MSolovtsov/BachelorThesis_Manipulator/Electronic/Altium/Курсовой проект по  электронике/Электроника/PCBbase.PcbDoc.htm

Reporting Options

# File in Newer Format

Date | : | 27.01.2025
Time | : | 15:22:56
Filename | : | C:\Users\mikha\Desktop\BMSTU\4_course\Дипломная работа\Электроника\Altium\Курсовой проект по электронике\Электроника\PCBbase.PcbDoc

Version | Warning
Release 23.6 | CAUTION - The PCB document contains Footprint parameters. These will be lost when opening the document in a version of Altium Designer that does not support this functionality.

This file was generated by a later version of the software
