MSolovtsov/BachelorThesis_Manipulator/Electronic/Altium/Курсовой проект по  электронике/Электроника/AD_GOST/Examples/MiniPC MB GOST/MiniPC MB GOST.PrjPcb And MiniPC MB GOST.XLS

Change Order Report For Project |  |  | MiniPC MB GOST.PrjPcb And MiniPC MB GOST.PrjPcb
Action | Object |  | Change Document | Status
Remove Pins From Nets
Remove | AB14-C357-1 from DDR4VCC_1 | In | MiniPC.PcbDoc
Remove | AB14-C357-2 from GND | In | MiniPC.PcbDoc
Remove | AB14-C358-1 from DDR4VCC_1 | In | MiniPC.PcbDoc
Remove | AB14-C358-2 from GND | In | MiniPC.PcbDoc
Remove | AB14-C359-1 from DDR4VCC_1 | In | MiniPC.PcbDoc
Remove | AB14-C359-2 from GND | In | MiniPC.PcbDoc
Remove | AB14-C360-1 from DDR4VCC_1 | In | MiniPC.PcbDoc
Remove | AB14-C360-2 from GND | In | MiniPC.PcbDoc
Remove | AB14-C361-1 from NetAB14-C361_1 | In | MiniPC.PcbDoc
Remove | AB14-C362-1 from DDR4VCC_1 | In | MiniPC.PcbDoc
Remove | AB14-C362-2 from GND | In | MiniPC.PcbDoc
Remove | AB15-C364-1 from DDR4VCC_1 | In | MiniPC.PcbDoc
Remove | AB15-C364-2 from GND | In | MiniPC.PcbDoc
Remove | AB15-C365-1 from DDR4VCC_1 | In | MiniPC.PcbDoc
Remove | AB15-C365-2 from GND | In | MiniPC.PcbDoc
Remove | AB15-C366-1 from DDR4VCC_1 | In | MiniPC.PcbDoc
Remove | AB15-C366-2 from GND | In | MiniPC.PcbDoc
Remove | AB15-C367-1 from DDR4VCC_1 | In | MiniPC.PcbDoc
Remove | AB15-C367-2 from GND | In | MiniPC.PcbDoc
Remove | AB15-C369-1 from DDR4VCC_1 | In | MiniPC.PcbDoc
Remove | AB15-C369-2 from GND | In | MiniPC.PcbDoc
Remove | AB21-C401-1 from GND | In | MiniPC.PcbDoc
Remove | AB21-C401-2 from IO_2V5_1 | In | MiniPC.PcbDoc
Remove | AB21-C402-1 from GND | In | MiniPC.PcbDoc
Remove | AB21-C402-2 from IO_3V3_1 | In | MiniPC.PcbDoc
Remove | AB21-C403-1 from GND | In | MiniPC.PcbDoc
Remove | AB21-C403-2 from 5V_1 | In | MiniPC.PcbDoc
Remove | AB21-C404-1 from GND | In | MiniPC.PcbDoc
Remove | AB21-C404-2 from IO_3V3_1 | In | MiniPC.PcbDoc
Remove | AB21-C409-1 from GND | In | MiniPC.PcbDoc
Remove | AB21-C409-2 from 3V3_AVDDH_31 | In | MiniPC.PcbDoc
Remove | AB21-C410-1 from GND | In | MiniPC.PcbDoc
Remove | AB21-C410-2 from 3V3_AVDDH_31 | In | MiniPC.PcbDoc
Remove | AB21-C411-1 from GND | In | MiniPC.PcbDoc
Remove | AB21-C411-2 from 3V3_AVDDH_31 | In | MiniPC.PcbDoc
Remove | AB21-C412-1 from GND | In | MiniPC.PcbDoc
Remove | AB21-C412-2 from 1V2_AVDLL_PLL_31 | In | MiniPC.PcbDoc
Remove | AB21-C413-1 from GND | In | MiniPC.PcbDoc
Remove | AB21-C413-2 from 1V2_AVDLL_PLL_31 | In | MiniPC.PcbDoc
Remove | AB21-C420-1 from GND | In | MiniPC.PcbDoc
Remove | AB21-C420-2 from 1V2_AVDLL_PLL_31 | In | MiniPC.PcbDoc
Remove | AB21-C421-1 from GND | In | MiniPC.PcbDoc
Remove | AB21-C421-2 from 1V2_AVDLL_PLL_31 | In | MiniPC.PcbDoc
Remove | AB21-C422-1 from GND | In | MiniPC.PcbDoc
Remove | AB21-C422-2 from 1V2_AVDLL_PLL_31 | In | MiniPC.PcbDoc
Remove | MH1-MH1 from GND | In | MiniPC.PcbDoc
Remove | MH2-MH1 from GND | In | MiniPC.PcbDoc
Remove | MH3-MH1 from GND | In | MiniPC.PcbDoc
Remove | MH4-MH1 from GND | In | MiniPC.PcbDoc
Remove Component Class Members
Remove | AB16-X1 from A1 | In | MiniPC.PcbDoc
Remove | AB19AC1-X4 from AB19 | In | MiniPC.PcbDoc
Remove | AB19AC1-X4 from AB20 | In | MiniPC.PcbDoc
Remove | AB19AC1-X4 from AC12 | In | MiniPC.PcbDoc
Remove | AB22-XS6 from A3 | In | MiniPC.PcbDoc
Remove | AC2-C540 from AB21 | In | MiniPC.PcbDoc
Remove | AC2-C541 from AB21 | In | MiniPC.PcbDoc
Remove | AC2-C542 from AB21 | In | MiniPC.PcbDoc
Remove | AC2-C543 from AB21 | In | MiniPC.PcbDoc
Remove | AC2-R314 from AB21 | In | MiniPC.PcbDoc
Remove | AC2-R315 from AB21 | In | MiniPC.PcbDoc
Remove | AC2-X5 from AB21 | In | MiniPC.PcbDoc
пятница 6-сен-06.2019 12:04:29 PM |  |  |  |  | Page 1 of 15
Action | Object |  | Change Document | Status
Change Component Parameters
Modify | 5 parameter change(s) (Current - Cathode, Noise - | In | MiniPC.PcbDoc
 | 0#1Hz to 10Hz, Operating Temperature,
 | Temperature Coefficient, Tolerance) In AB3-D7
пятница 6-сен-06.2019 12:04:29 PM |  |  |  |  | Page 2 of 15
Action | Object |  | Change Document | Status
Change Net Names
Modify | 0V9_SENSE+_41 -> 0V9_SENSE+ | In | MiniPC.PcbDoc
Modify | 0V9_SENSE-_41 -> 0V9_SENSE- | In | MiniPC.PcbDoc
Modify | 0V95_1 -> 0V95 | In | MiniPC.PcbDoc
Modify | 1V0_1 -> 1V0 | In | MiniPC.PcbDoc
Modify | 1V2_AVDDL_31 -> 1V2_AVDDL | In | MiniPC.PcbDoc
Modify | 1V2_AVDLL_PLL_31 -> 1V2_AVDLL_PLL | In | MiniPC.PcbDoc
Modify | 1V2_DVDDL_31 -> 1V2_DVDDL | In | MiniPC.PcbDoc
Modify | 1V8_DVDDH_31 -> 1V8_DVDDH | In | MiniPC.PcbDoc
Modify | 3V3_1 -> 3V3 | In | MiniPC.PcbDoc
Modify | 3V3_AVDDH_31 -> 3V3_AVDDH | In | MiniPC.PcbDoc
Modify | 3V3_SENSE+_36 -> 3V3_SENSE+ | In | MiniPC.PcbDoc
Modify | 3V3_SENSE-_36 -> 3V3_SENSE- | In | MiniPC.PcbDoc
Modify | 5V_1 -> IO_5V | In | MiniPC.PcbDoc
Modify | aux_12V_1 -> aux_12V | In | MiniPC.PcbDoc
Modify | CLK_DIFF1_8_N -> CLK_DIFF1_N | In | MiniPC.PcbDoc
Modify | CLK_DIFF1_8_P -> CLK_DIFF1_P | In | MiniPC.PcbDoc
Modify | CLK_DIFF2_8_N -> CLK_DIFF2_N | In | MiniPC.PcbDoc
Modify | CLK_DIFF2_8_P -> CLK_DIFF2_P | In | MiniPC.PcbDoc
Modify | CLOCK_I2C_SCL_8 -> CLOCK_I2C_SCL | In | MiniPC.PcbDoc
Modify | CLOCK_I2C_SDA_8 -> CLOCK_I2C_SDA | In | MiniPC.PcbDoc
Modify | COMP01_41 -> COMP01 | In | MiniPC.PcbDoc
Modify | COMP02_36 -> COMP02 | In | MiniPC.PcbDoc
Modify | Core_0V9_1 -> Core_0V9 | In | MiniPC.PcbDoc
Modify | DDR4_BLK1.CTRL.ACT_1 -> | In | MiniPC.PcbDoc
 | DDR4_BLK1.CTRL.ACT
Modify | DDR4_BLK1.CTRL.ALERT_1 -> | In | MiniPC.PcbDoc
 | DDR4_BLK1.CTRL.ALERT
Modify | DDR4_BLK1.CTRL.CK0_1_N -> | In | MiniPC.PcbDoc
 | DDR4_BLK1.CTRL.CK0_N
Modify | DDR4_BLK1.CTRL.CK0_1_P -> | In | MiniPC.PcbDoc
 | DDR4_BLK1.CTRL.CK0_P
Modify | DDR4_BLK1.CTRL.CK1_1_N -> | In | MiniPC.PcbDoc
 | DDR4_BLK1.CTRL.CK1_N
Modify | DDR4_BLK1.CTRL.CK1_1_P -> | In | MiniPC.PcbDoc
 | DDR4_BLK1.CTRL.CK1_P
Modify | DDR4_BLK1.CTRL.CKE_1 -> | In | MiniPC.PcbDoc
 | DDR4_BLK1.CTRL.CKE
Modify | DDR4_BLK1.CTRL.CS_1 -> | In | MiniPC.PcbDoc
 | DDR4_BLK1.CTRL.CS
Modify | DDR4_BLK1.CTRL.ODT_1 -> | In | MiniPC.PcbDoc
 | DDR4_BLK1.CTRL.ODT
Modify | DDR4_BLK1.CTRL.PARITY_1 -> | In | MiniPC.PcbDoc
 | DDR4_BLK1.CTRL.PARITY
Modify | DDR4_BLK1.CTRL.RESET_1 -> | In | MiniPC.PcbDoc
 | DDR4_BLK1.CTRL.RESET
Modify | DDR4_BLK1.CTRL.SCL_1 -> | In | MiniPC.PcbDoc
 | DDR4_BLK1.CTRL.SCL
Modify | DDR4_BLK1.CTRL.SDA_1 -> | In | MiniPC.PcbDoc
 | DDR4_BLK1.CTRL.SDA
Modify | DDR4_BLK1.DL1.DM0_1 -> | In | MiniPC.PcbDoc
 | DDR4_BLK1.DL1.DM0
Modify | DDR4_BLK1.DL1.DQ0_1 -> | In | MiniPC.PcbDoc
 | DDR4_BLK1.DL1.DQ0
Modify | DDR4_BLK1.DL1.DQ1_1 -> | In | MiniPC.PcbDoc
 | DDR4_BLK1.DL1.DQ1
Modify | DDR4_BLK1.DL1.DQ2_1 -> | In | MiniPC.PcbDoc
 | DDR4_BLK1.DL1.DQ2
Modify | DDR4_BLK1.DL1.DQ3_1 -> | In | MiniPC.PcbDoc
 | DDR4_BLK1.DL1.DQ3
Modify | DDR4_BLK1.DL1.DQ4_1 -> | In | MiniPC.PcbDoc
 | DDR4_BLK1.DL1.DQ4
Modify | DDR4_BLK1.DL1.DQ5_1 -> | In | MiniPC.PcbDoc
 | DDR4_BLK1.DL1.DQ5
Modify | DDR4_BLK1.DL1.DQ6_1 -> | In | MiniPC.PcbDoc
 | DDR4_BLK1.DL1.DQ6
Modify | DDR4_BLK1.DL1.DQ7_1 -> | In | MiniPC.PcbDoc
 | DDR4_BLK1.DL1.DQ7
Modify | DDR4_BLK1.DL1.DQS0_1_N -> | In | MiniPC.PcbDoc
 | DDR4_BLK1.DL1.DQS0_N
Modify | DDR4_BLK1.DL1.DQS0_1_P -> | In | MiniPC.PcbDoc
пятница 6-сен-06.2019 12:04:29 PM |  |  |  |  | Page 3 of 15
Action | Object |  | Change Document | Status
Change Net Names
 | DDR4_BLK1.DL1.DQS0_P
Modify | DDR4_BLK1.DL2.DM1_1 -> | In | MiniPC.PcbDoc
 | DDR4_BLK1.DL2.DM1
Modify | DDR4_BLK1.DL2.DQ8_1 -> | In | MiniPC.PcbDoc
 | DDR4_BLK1.DL2.DQ8
Modify | DDR4_BLK1.DL2.DQ9_1 -> | In | MiniPC.PcbDoc
 | DDR4_BLK1.DL2.DQ9
Modify | DDR4_BLK1.DL2.DQ10_1 -> | In | MiniPC.PcbDoc
 | DDR4_BLK1.DL2.DQ10
Modify | DDR4_BLK1.DL2.DQ11_1 -> | In | MiniPC.PcbDoc
 | DDR4_BLK1.DL2.DQ11
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
 | DDR4_BLK1.DL7.DQ50
Modify | DDR4_BLK1.DL7.DQ51_1 -> | In | MiniPC.PcbDoc
 | DDR4_BLK1.DL7.DQ51
Modify | DDR4_BLK1.DL7.DQ52_1 -> | In | MiniPC.PcbDoc
 | DDR4_BLK1.DL7.DQ52
Modify | DDR4_BLK1.DL7.DQ53_1 -> | In | MiniPC.PcbDoc
 | DDR4_BLK1.DL7.DQ53
Modify | DDR4_BLK1.DL7.DQ54_1 -> | In | MiniPC.PcbDoc
 | DDR4_BLK1.DL7.DQ54
Modify | DDR4_BLK1.DL7.DQ55_1 -> | In | MiniPC.PcbDoc
 | DDR4_BLK1.DL7.DQ55
Modify | DDR4_BLK1.DL7.DQS6_1_N -> | In | MiniPC.PcbDoc
 | DDR4_BLK1.DL7.DQS6_N
Modify | DDR4_BLK1.DL7.DQS6_1_P -> | In | MiniPC.PcbDoc
 | DDR4_BLK1.DL7.DQS6_P
Modify | DDR4_BLK1.DL8.DM7_1 -> | In | MiniPC.PcbDoc
 | DDR4_BLK1.DL8.DM7
Modify | DDR4_BLK1.DL8.DQ56_1 -> | In | MiniPC.PcbDoc
 | DDR4_BLK1.DL8.DQ56
Modify | DDR4_BLK1.DL8.DQ57_1 -> | In | MiniPC.PcbDoc
 | DDR4_BLK1.DL8.DQ57
Modify | DDR4_BLK1.DL8.DQ58_1 -> | In | MiniPC.PcbDoc
пятница 6-сен-06.2019 12:04:29 PM |  |  |  |  | Page 5 of 15
Action | Object |  | Change Document | Status
Change Net Names
 | DDR4_BLK1.DL8.DQ58
Modify | DDR4_BLK1.DL8.DQ59_1 -> | In | MiniPC.PcbDoc
 | DDR4_BLK1.DL8.DQ59
Modify | DDR4_BLK1.DL8.DQ60_1 -> | In | MiniPC.PcbDoc
 | DDR4_BLK1.DL8.DQ60
Modify | DDR4_BLK1.DL8.DQ61_1 -> | In | MiniPC.PcbDoc
 | DDR4_BLK1.DL8.DQ61
Modify | DDR4_BLK1.DL8.DQ62_1 -> | In | MiniPC.PcbDoc
 | DDR4_BLK1.DL8.DQ62
Modify | DDR4_BLK1.DL8.DQ63_1 -> | In | MiniPC.PcbDoc
 | DDR4_BLK1.DL8.DQ63
Modify | DDR4_BLK1.DL8.DQS7_1_N -> | In | MiniPC.PcbDoc
 | DDR4_BLK1.DL8.DQS7_N
Modify | DDR4_BLK1.DL8.DQS7_1_P -> | In | MiniPC.PcbDoc
 | DDR4_BLK1.DL8.DQS7_P
Modify | DDR4_BLK2.CTRL.CK0_1_N -> | In | MiniPC.PcbDoc
 | DDR4_BLK2.CTRL.CK0_N
Modify | DDR4_BLK2.CTRL.CK0_1_P -> | In | MiniPC.PcbDoc
 | DDR4_BLK2.CTRL.CK0_P
Modify | DDR4_BLK2.CTRL.CK1_1_N -> | In | MiniPC.PcbDoc
 | DDR4_BLK2.CTRL.CK1_N
Modify | DDR4_BLK2.CTRL.CK1_1_P -> | In | MiniPC.PcbDoc
 | DDR4_BLK2.CTRL.CK1_P
Modify | DDR4_BLK2.CTRL.CKE_1 -> | In | MiniPC.PcbDoc
 | DDR4_BLK2.CTRL.CKE
Modify | DDR4_BLK2.CTRL.CS_1 -> | In | MiniPC.PcbDoc
 | DDR4_BLK2.CTRL.CS
Modify | DDR4_BLK2.CTRL.ODT_1 -> | In | MiniPC.PcbDoc
 | DDR4_BLK2.CTRL.ODT
Modify | DDR4_INT.CTRL.ACT_1 -> | In | MiniPC.PcbDoc
 | DDR4_INT.CTRL.ACT
Modify | DDR4_INT.CTRL.ALERT0_1 -> | In | MiniPC.PcbDoc
 | DDR4_INT.CTRL.ALERT0
Modify | DDR4_INT.CTRL.ALERT1_1 -> | In | MiniPC.PcbDoc
 | DDR4_INT.CTRL.ALERT1
Modify | DDR4_INT.CTRL.CAS_1 -> | In | MiniPC.PcbDoc
 | DDR4_INT.CTRL.CAS
Modify | DDR4_INT.CTRL.CKE_1 -> | In | MiniPC.PcbDoc
 | DDR4_INT.CTRL.CKE
Modify | DDR4_INT.CTRL.CLK_1_N -> | In | MiniPC.PcbDoc
 | DDR4_INT.CTRL.CLK_N
Modify | DDR4_INT.CTRL.CLK_1_P -> | In | MiniPC.PcbDoc
 | DDR4_INT.CTRL.CLK_P
Modify | DDR4_INT.CTRL.CSn_1 -> | In | MiniPC.PcbDoc
 | DDR4_INT.CTRL.CSn
Modify | DDR4_INT.CTRL.ODT_1 -> | In | MiniPC.PcbDoc
 | DDR4_INT.CTRL.ODT
Modify | DDR4_INT.CTRL.PAR_1 -> | In | MiniPC.PcbDoc
 | DDR4_INT.CTRL.PAR
Modify | DDR4_INT.CTRL.RAS_1 -> | In | MiniPC.PcbDoc
 | DDR4_INT.CTRL.RAS
Modify | DDR4_INT.CTRL.RESETn_1 -> | In | MiniPC.PcbDoc
 | DDR4_INT.CTRL.RESETn
Modify | DDR4_INT.CTRL.WEn_1 -> | In | MiniPC.PcbDoc
 | DDR4_INT.CTRL.WEn
Modify | DDR4_INT.DL1.DM0_1 -> DDR4_INT.DL1.DM0 | In | MiniPC.PcbDoc
Modify | DDR4_INT.DL1.DQ0_1 -> DDR4_INT.DL1.DQ0 | In | MiniPC.PcbDoc
Modify | DDR4_INT.DL1.DQ1_1 -> DDR4_INT.DL1.DQ1 | In | MiniPC.PcbDoc
Modify | DDR4_INT.DL1.DQ2_1 -> DDR4_INT.DL1.DQ2 | In | MiniPC.PcbDoc
Modify | DDR4_INT.DL1.DQ3_1 -> DDR4_INT.DL1.DQ3 | In | MiniPC.PcbDoc
Modify | DDR4_INT.DL1.DQ4_1 -> DDR4_INT.DL1.DQ4 | In | MiniPC.PcbDoc
Modify | DDR4_INT.DL1.DQ5_1 -> DDR4_INT.DL1.DQ5 | In | MiniPC.PcbDoc
Modify | DDR4_INT.DL1.DQ6_1 -> DDR4_INT.DL1.DQ6 | In | MiniPC.PcbDoc
Modify | DDR4_INT.DL1.DQ7_1 -> DDR4_INT.DL1.DQ7 | In | MiniPC.PcbDoc
Modify | DDR4_INT.DL1.DQS0_1_N -> | In | MiniPC.PcbDoc
 | DDR4_INT.DL1.DQS0_N
Modify | DDR4_INT.DL1.DQS0_1_P -> | In | MiniPC.PcbDoc
 | DDR4_INT.DL1.DQS0_P
Modify | DDR4_INT.DL2.DM1_1 -> DDR4_INT.DL2.DM1 | In | MiniPC.PcbDoc
Modify | DDR4_INT.DL2.DQ8_1 -> DDR4_INT.DL2.DQ8 | In | MiniPC.PcbDoc
пятница 6-сен-06.2019 12:04:29 PM |  |  |  |  | Page 6 of 15
Action | Object |  | Change Document | Status
Change Net Names
Modify | DDR4_INT.DL2.DQ9_1 -> DDR4_INT.DL2.DQ9 | In | MiniPC.PcbDoc
Modify | DDR4_INT.DL2.DQ10_1 -> DDR4_INT.DL2.DQ10 | In | MiniPC.PcbDoc
Modify | DDR4_INT.DL2.DQ11_1 -> DDR4_INT.DL2.DQ11 | In | MiniPC.PcbDoc
Modify | DDR4_INT.DL2.DQ12_1 -> DDR4_INT.DL2.DQ12 | In | MiniPC.PcbDoc
Modify | DDR4_INT.DL2.DQ13_1 -> DDR4_INT.DL2.DQ13 | In | MiniPC.PcbDoc
Modify | DDR4_INT.DL2.DQ14_1 -> DDR4_INT.DL2.DQ14 | In | MiniPC.PcbDoc
Modify | DDR4_INT.DL2.DQ15_1 -> DDR4_INT.DL2.DQ15 | In | MiniPC.PcbDoc
Modify | DDR4_INT.DL2.DQS1_1_N -> | In | MiniPC.PcbDoc
 | DDR4_INT.DL2.DQS1_N
Modify | DDR4_INT.DL2.DQS1_1_P -> | In | MiniPC.PcbDoc
 | DDR4_INT.DL2.DQS1_P
Modify | DDR4_INT.DL3.DM2_1 -> DDR4_INT.DL3.DM2 | In | MiniPC.PcbDoc
Modify | DDR4_INT.DL3.DQ16_1 -> DDR4_INT.DL3.DQ16 | In | MiniPC.PcbDoc
Modify | DDR4_INT.DL3.DQ17_1 -> DDR4_INT.DL3.DQ17 | In | MiniPC.PcbDoc
Modify | DDR4_INT.DL3.DQ18_1 -> DDR4_INT.DL3.DQ18 | In | MiniPC.PcbDoc
Modify | DDR4_INT.DL3.DQ19_1 -> DDR4_INT.DL3.DQ19 | In | MiniPC.PcbDoc
Modify | DDR4_INT.DL3.DQ20_1 -> DDR4_INT.DL3.DQ20 | In | MiniPC.PcbDoc
Modify | DDR4_INT.DL3.DQ21_1 -> DDR4_INT.DL3.DQ21 | In | MiniPC.PcbDoc
Modify | DDR4_INT.DL3.DQ22_1 -> DDR4_INT.DL3.DQ22 | In | MiniPC.PcbDoc
Modify | DDR4_INT.DL3.DQ23_1 -> DDR4_INT.DL3.DQ23 | In | MiniPC.PcbDoc
Modify | DDR4_INT.DL3.DQS2_1_N -> | In | MiniPC.PcbDoc
 | DDR4_INT.DL3.DQS2_N
Modify | DDR4_INT.DL3.DQS2_1_P -> | In | MiniPC.PcbDoc
 | DDR4_INT.DL3.DQS2_P
Modify | DDR4_INT.DL4.DM3_1 -> DDR4_INT.DL4.DM3 | In | MiniPC.PcbDoc
Modify | DDR4_INT.DL4.DQ24_1 -> DDR4_INT.DL4.DQ24 | In | MiniPC.PcbDoc
Modify | DDR4_INT.DL4.DQ25_1 -> DDR4_INT.DL4.DQ25 | In | MiniPC.PcbDoc
Modify | DDR4_INT.DL4.DQ26_1 -> DDR4_INT.DL4.DQ26 | In | MiniPC.PcbDoc
Modify | DDR4_INT.DL4.DQ27_1 -> DDR4_INT.DL4.DQ27 | In | MiniPC.PcbDoc
Modify | DDR4_INT.DL4.DQ28_1 -> DDR4_INT.DL4.DQ28 | In | MiniPC.PcbDoc
Modify | DDR4_INT.DL4.DQ29_1 -> DDR4_INT.DL4.DQ29 | In | MiniPC.PcbDoc
Modify | DDR4_INT.DL4.DQ30_1 -> DDR4_INT.DL4.DQ30 | In | MiniPC.PcbDoc
Modify | DDR4_INT.DL4.DQ31_1 -> DDR4_INT.DL4.DQ31 | In | MiniPC.PcbDoc
Modify | DDR4_INT.DL4.DQS3_1_N -> | In | MiniPC.PcbDoc
 | DDR4_INT.DL4.DQS3_N
Modify | DDR4_INT.DL4.DQS3_1_P -> | In | MiniPC.PcbDoc
 | DDR4_INT.DL4.DQS3_P
Modify | DDR4VCC_1 -> DDR4VCC | In | MiniPC.PcbDoc
Modify | DP_3V3_2 -> DP_3V3 | In | MiniPC.PcbDoc
Modify | DP_ML_LANE0_C_2_N -> DP_ML_LANE0_C_N | In | MiniPC.PcbDoc
Modify | DP_ML_LANE0_C_2_P -> DP_ML_LANE0_C_P | In | MiniPC.PcbDoc
Modify | DP_ML_LANE1_C_2_N -> DP_ML_LANE1_C_N | In | MiniPC.PcbDoc
Modify | DP_ML_LANE1_C_2_P -> DP_ML_LANE1_C_P | In | MiniPC.PcbDoc
Modify | DP_ML_LANE2_C_2_N -> DP_ML_LANE2_C_N | In | MiniPC.PcbDoc
Modify | DP_ML_LANE2_C_2_P -> DP_ML_LANE2_C_P | In | MiniPC.PcbDoc
Modify | DP_ML_LANE3_C_2_N -> DP_ML_LANE3_C_N | In | MiniPC.PcbDoc
Modify | DP_ML_LANE3_C_2_P -> DP_ML_LANE3_C_P | In | MiniPC.PcbDoc
Modify | ENET_REFCLK_C_8_N -> ENET_REFCLK_C_N | In | MiniPC.PcbDoc
Modify | ENET_REFCLK_C_8_P -> ENET_REFCLK_C_P | In | MiniPC.PcbDoc
Modify | GND_DP_2 -> GND_DP | In | MiniPC.PcbDoc
Modify | GND_SENSE_1 -> GND_SENSE | In | MiniPC.PcbDoc
Modify | HPS_0V95_1 -> HPS_0V95 | In | MiniPC.PcbDoc
Modify | IO_1V8_1 -> IO_1V8 | In | MiniPC.PcbDoc
Modify | IO_2V5_1 -> IO_2V5 | In | MiniPC.PcbDoc
Modify | IO_3V3_1 -> IO_3V3 | In | MiniPC.PcbDoc
Modify | NetAB14-C361_1 -> NetAB14-R86_2 | In | MiniPC.PcbDoc
Modify | PCIE.CLK_SYN._1_N -> PCIE.CLK_SYN._N | In | MiniPC.PcbDoc
Modify | PCIE.CLK_SYN._1_P -> PCIE.CLK_SYN._P | In | MiniPC.PcbDoc
Modify | PCIE.DL.RX0._1_N -> PCIE.DL.RX0._N | In | MiniPC.PcbDoc
Modify | PCIE.DL.RX0._1_P -> PCIE.DL.RX0._P | In | MiniPC.PcbDoc
Modify | PCIE.DL.RX1._1_N -> PCIE.DL.RX1._N | In | MiniPC.PcbDoc
Modify | PCIE.DL.RX1._1_P -> PCIE.DL.RX1._P | In | MiniPC.PcbDoc
Modify | PCIE.DL.RX2._1_N -> PCIE.DL.RX2._N | In | MiniPC.PcbDoc
Modify | PCIE.DL.RX2._1_P -> PCIE.DL.RX2._P | In | MiniPC.PcbDoc
Modify | PCIE.DL.RX3._1_N -> PCIE.DL.RX3._N | In | MiniPC.PcbDoc
Modify | PCIE.DL.RX3._1_P -> PCIE.DL.RX3._P | In | MiniPC.PcbDoc
Modify | PCIE.DL.RX4._1_N -> PCIE.DL.RX4._N | In | MiniPC.PcbDoc
Modify | PCIE.DL.RX4._1_P -> PCIE.DL.RX4._P | In | MiniPC.PcbDoc
Modify | PCIE.DL.RX5._1_N -> PCIE.DL.RX5._N | In | MiniPC.PcbDoc
пятница 6-сен-06.2019 12:04:29 PM |  |  |  |  | Page 7 of 15
Action | Object |  | Change Document | Status
Change Net Names
Modify | PCIE.DL.RX5._1_P -> PCIE.DL.RX5._P | In | MiniPC.PcbDoc
Modify | PCIE.DL.RX6._1_N -> PCIE.DL.RX6._N | In | MiniPC.PcbDoc
Modify | PCIE.DL.RX6._1_P -> PCIE.DL.RX6._P | In | MiniPC.PcbDoc
Modify | PCIE.DL.RX7._1_N -> PCIE.DL.RX7._N | In | MiniPC.PcbDoc
Modify | PCIE.DL.RX7._1_P -> PCIE.DL.RX7._P | In | MiniPC.PcbDoc
Modify | PCIE.DL.TX0._1_N -> PCIE.DL.TX0._N | In | MiniPC.PcbDoc
Modify | PCIE.DL.TX0._1_P -> PCIE.DL.TX0._P | In | MiniPC.PcbDoc
Modify | PCIE.DL.TX1._1_N -> PCIE.DL.TX1._N | In | MiniPC.PcbDoc
Modify | PCIE.DL.TX1._1_P -> PCIE.DL.TX1._P | In | MiniPC.PcbDoc
Modify | PCIE.DL.TX2._1_N -> PCIE.DL.TX2._N | In | MiniPC.PcbDoc
Modify | PCIE.DL.TX2._1_P -> PCIE.DL.TX2._P | In | MiniPC.PcbDoc
Modify | PCIE.DL.TX3._1_N -> PCIE.DL.TX3._N | In | MiniPC.PcbDoc
Modify | PCIE.DL.TX3._1_P -> PCIE.DL.TX3._P | In | MiniPC.PcbDoc
Modify | PCIE.DL.TX4._1_N -> PCIE.DL.TX4._N | In | MiniPC.PcbDoc
Modify | PCIE.DL.TX4._1_P -> PCIE.DL.TX4._P | In | MiniPC.PcbDoc
Modify | PCIE.DL.TX5._1_N -> PCIE.DL.TX5._N | In | MiniPC.PcbDoc
Modify | PCIE.DL.TX5._1_P -> PCIE.DL.TX5._P | In | MiniPC.PcbDoc
Modify | PCIE.DL.TX6._1_N -> PCIE.DL.TX6._N | In | MiniPC.PcbDoc
Modify | PCIE.DL.TX6._1_P -> PCIE.DL.TX6._P | In | MiniPC.PcbDoc
Modify | PCIE.DL.TX7._1_N -> PCIE.DL.TX7._N | In | MiniPC.PcbDoc
Modify | PCIE.DL.TX7._1_P -> PCIE.DL.TX7._P | In | MiniPC.PcbDoc
Modify | PCIE.PERSTn_1 -> PCIE.PERSTn | In | MiniPC.PcbDoc
Modify | PCIE_aux3V3_1 -> PCIE_aux3V3 | In | MiniPC.PcbDoc
Modify | PCIE_DC_3V3_1 -> PCIE_DC_3V3 | In | MiniPC.PcbDoc
Modify | PCIE_TX0_C_12_N -> PCIE_TX0_C_N | In | MiniPC.PcbDoc
Modify | PCIE_TX0_C_12_P -> PCIE_TX0_C_P | In | MiniPC.PcbDoc
Modify | PCIE_TX1_C_12_N -> PCIE_TX1_C_N | In | MiniPC.PcbDoc
Modify | PCIE_TX1_C_12_P -> PCIE_TX1_C_P | In | MiniPC.PcbDoc
Modify | PCIE_TX2_C_12_N -> PCIE_TX2_C_N | In | MiniPC.PcbDoc
Modify | PCIE_TX2_C_12_P -> PCIE_TX2_C_P | In | MiniPC.PcbDoc
Modify | PCIE_TX3_C_12_N -> PCIE_TX3_C_N | In | MiniPC.PcbDoc
Modify | PCIE_TX3_C_12_P -> PCIE_TX3_C_P | In | MiniPC.PcbDoc
Modify | PCIE_TX4_C_12_N -> PCIE_TX4_C_N | In | MiniPC.PcbDoc
Modify | PCIE_TX4_C_12_P -> PCIE_TX4_C_P | In | MiniPC.PcbDoc
Modify | PCIE_TX5_C_12_N -> PCIE_TX5_C_N | In | MiniPC.PcbDoc
Modify | PCIE_TX5_C_12_P -> PCIE_TX5_C_P | In | MiniPC.PcbDoc
Modify | PCIE_TX6_C_12_N -> PCIE_TX6_C_N | In | MiniPC.PcbDoc
Modify | PCIE_TX6_C_12_P -> PCIE_TX6_C_P | In | MiniPC.PcbDoc
Modify | PCIE_TX7_C_12_N -> PCIE_TX7_C_N | In | MiniPC.PcbDoc
Modify | PCIE_TX7_C_12_P -> PCIE_TX7_C_P | In | MiniPC.PcbDoc
Modify | PLL_1V8_1 -> PLL_1V8 | In | MiniPC.PcbDoc
Modify | PRESENT_12 -> PRESENT | In | MiniPC.PcbDoc
Modify | REFCLK0_FMCB_C_8_N -> | In | MiniPC.PcbDoc
 | REFCLK0_FMCB_C_N
Modify | REFCLK0_FMCB_C_8_P -> | In | MiniPC.PcbDoc
 | REFCLK0_FMCB_C_P
Modify | REFCLK1_FMCB_C_8_N -> | In | MiniPC.PcbDoc
 | REFCLK1_FMCB_C_N
Modify | REFCLK1_FMCB_C_8_P -> | In | MiniPC.PcbDoc
 | REFCLK1_FMCB_C_P
Modify | REFCLK_DP_C_8_N -> REFCLK_DP_C_N | In | MiniPC.PcbDoc
Modify | REFCLK_DP_C_8_P -> REFCLK_DP_C_P | In | MiniPC.PcbDoc
Modify | REFCLK_SDI_C_8_N -> REFCLK_SDI_C_N | In | MiniPC.PcbDoc
Modify | REFCLK_SDI_C_8_P -> REFCLK_SDI_C_P | In | MiniPC.PcbDoc
Modify | SENSESYNC1_41 -> SENSESYNC1 | In | MiniPC.PcbDoc
Modify | SENSESYNC2_36 -> SENSESYNC2 | In | MiniPC.PcbDoc
Modify | SHARE_CLK1_41 -> SHARE_CLK1 | In | MiniPC.PcbDoc
Modify | SHARE_CLK2_36 -> SHARE_CLK2 | In | MiniPC.PcbDoc
Modify | TRCT1_47 -> TRCT1 | In | MiniPC.PcbDoc
Modify | TRCT2_47 -> TRCT2 | In | MiniPC.PcbDoc
Modify | TRCT3_47 -> TRCT3 | In | MiniPC.PcbDoc
Modify | TRCT4_47 -> TRCT4 | In | MiniPC.PcbDoc
Modify | TRD1_31_N -> TRD1_N | In | MiniPC.PcbDoc
Modify | TRD1_31_P -> TRD1_P | In | MiniPC.PcbDoc
Modify | TRD2_31_N -> TRD2_N | In | MiniPC.PcbDoc
Modify | TRD2_31_P -> TRD2_P | In | MiniPC.PcbDoc
Modify | TRD3_31_N -> TRD3_N | In | MiniPC.PcbDoc
Modify | TRD3_31_P -> TRD3_P | In | MiniPC.PcbDoc
Modify | TRD4_31_N -> TRD4_N | In | MiniPC.PcbDoc
пятница 6-сен-06.2019 12:04:29 PM |  |  |  |  | Page 8 of 15
Action | Object |  | Change Document | Status
Change Net Names
Modify | TRD4_31_P -> TRD4_P | In | MiniPC.PcbDoc
Modify | USB3_port.DATA._4_N -> USB3_port.DATA._N | In | MiniPC.PcbDoc
Modify | USB3_port.DATA._4_P -> USB3_port.DATA._P | In | MiniPC.PcbDoc
Modify | USB3_port.GND_4 -> USB3_port.GND | In | MiniPC.PcbDoc
Modify | USB3_port.SSRX._4_N -> USB3_port.SSRX._N | In | MiniPC.PcbDoc
Modify | USB3_port.SSRX._4_P -> USB3_port.SSRX._P | In | MiniPC.PcbDoc
Modify | USB3_port.SSTX._4_N -> USB3_port.SSTX._N | In | MiniPC.PcbDoc
Modify | USB3_port.SSTX._4_P -> USB3_port.SSTX._P | In | MiniPC.PcbDoc
Modify | USB3_port.VBUS_4 -> USB3_port.VBUS | In | MiniPC.PcbDoc
Modify | USB3_TOD_4_N -> USB3_TOD_N | In | MiniPC.PcbDoc
Modify | USB3_TOD_4_P -> USB3_TOD_P | In | MiniPC.PcbDoc
Modify | VADJ_1 -> VADJ | In | MiniPC.PcbDoc
Modify | VCC_SENSE_1 -> VCC_SENSE | In | MiniPC.PcbDoc
Modify | VDD33_1_41 -> VDD33_1 | In | MiniPC.PcbDoc
Modify | VDD33_2_36 -> VDD33_2 | In | MiniPC.PcbDoc
Modify | Vref_DDR4_25 -> Vref_DDR4 | In | MiniPC.PcbDoc
Change Net Colors
Modify | [0V95_1] RGB(59, 178, 83) -> Default | In | MiniPC.PcbDoc
Modify | [1V0_1] RGB(59, 178, 83) -> Default | In | MiniPC.PcbDoc
Modify | [3V3_1] RGB(245, 154, 76) -> Default | In | MiniPC.PcbDoc
Modify | [3V3_OUTPUT] RGB(245, 154, 76) -> Default | In | MiniPC.PcbDoc
Modify | [12V_INPUT] RGB(208, 52, 158) -> Default | In | MiniPC.PcbDoc
Modify | [12V_OUTPUT] RGB(208, 52, 158) -> Default | In | MiniPC.PcbDoc
Modify | [aux_12V_1] RGB(208, 52, 158) -> Default | In | MiniPC.PcbDoc
Modify | [Core_0V9_1] RGB(59, 178, 83) -> Default | In | MiniPC.PcbDoc
Modify | [DDR4VCC_1] RGB(59, 178, 83) -> Default | In | MiniPC.PcbDoc
Modify | [GND] RGB(114, 214, 193) -> Default | In | MiniPC.PcbDoc
Modify | [HPS_0V95_1] RGB(59, 178, 83) -> Default | In | MiniPC.PcbDoc
Modify | [IO_1V8_1] RGB(235, 165, 194) -> Default | In | MiniPC.PcbDoc
Modify | [IO_3V3_1] RGB(245, 154, 76) -> Default | In | MiniPC.PcbDoc
Modify | [NetAB23-D15_D6] RGB(245, 154, 76) -> Default | In | MiniPC.PcbDoc
Modify | [NetAB23-D15_E6] RGB(245, 154, 76) -> Default | In | MiniPC.PcbDoc
Modify | [NetAB24-C437_2] RGB(235, 165, 194) -> Default | In | MiniPC.PcbDoc
Modify | [NetAB24-VT1_5] RGB(235, 165, 194) -> Default | In | MiniPC.PcbDoc
Modify | [NetAB31-R256_2] RGB(255, 110, 110) -> Default | In | MiniPC.PcbDoc
Modify | [NetAB33-R277_2] RGB(245, 154, 76) -> Default | In | MiniPC.PcbDoc
Modify | [PCIE_aux3V3_1] RGB(245, 154, 76) -> Default | In | MiniPC.PcbDoc
Modify | [PCIE_DC_3V3_1] RGB(245, 154, 76) -> Default | In | MiniPC.PcbDoc
Modify | [PLL_1V8_1] RGB(235, 165, 194) -> Default | In | MiniPC.PcbDoc
Modify | [VADJ_1] RGB(59, 178, 83) -> Default | In | MiniPC.PcbDoc
Remove Net Classes
Remove | CLK_DIFF_PCIE | From | MiniPC.PcbDoc
Remove | DDR4_40 | From | MiniPC.PcbDoc
Remove | DDR4_ADDR/C/C | From | MiniPC.PcbDoc
Remove | DDR4_BYTELINE0 | From | MiniPC.PcbDoc
Remove | DDR4_BYTELINE1 | From | MiniPC.PcbDoc
Remove | DDR4_BYTELINE2 | From | MiniPC.PcbDoc
Remove | DDR4_BYTELINE3 | From | MiniPC.PcbDoc
Remove | DDR4_SODIMM_ADDR/C/C | From | MiniPC.PcbDoc
Remove | DDR4_SODIMM_BYTELINE0 | From | MiniPC.PcbDoc
Remove | DDR4_SODIMM_BYTELINE1 | From | MiniPC.PcbDoc
Remove | DDR4_SODIMM_BYTELINE2 | From | MiniPC.PcbDoc
Remove | DDR4_SODIMM_BYTELINE3 | From | MiniPC.PcbDoc
Remove | DDR4_SODIMM_BYTELINE4 | From | MiniPC.PcbDoc
Remove | DDR4_SODIMM_BYTELINE5 | From | MiniPC.PcbDoc
Remove | DDR4_SODIMM_BYTELINE6 | From | MiniPC.PcbDoc
Remove | DDR4_SODIMM_BYTELINE7 | From | MiniPC.PcbDoc
Remove | ENET_HPS | From | MiniPC.PcbDoc
Remove | PCIE_CLK | From | MiniPC.PcbDoc
Remove | PCIE_RX | From | MiniPC.PcbDoc
Remove | PCIE_TX_C | From | MiniPC.PcbDoc
Remove | PCIE_TX | From | MiniPC.PcbDoc
Remove | PCIE_Upr | From | MiniPC.PcbDoc
Remove | SFP | From | MiniPC.PcbDoc
Remove | USB3_diff | From | MiniPC.PcbDoc
пятница 6-сен-06.2019 12:04:29 PM |  |  |  |  | Page 9 of 15
Action | Object |  | Change Document | Status
Remove Channel Classes
Remove | Channel Class [Интерфейс Ethernet] | From | MiniPC.PcbDoc
Remove | Channel Class [Соединитель Ethernet] | From | MiniPC.PcbDoc
Remove | Channel Class [Соединитель SFP] | From | MiniPC.PcbDoc
пятница 6-сен-06.2019 12:04:29 PM |  |  |  |  | Page 10 of 15
Action | Object |  | Change Document | Status
Change Differential Pair Positive Net Name
Modify | CLK_DIFF1_8_P -> CLK_DIFF1_P | In | MiniPC.PcbDoc
Modify | CLK_DIFF2_8_P -> CLK_DIFF2_P | In | MiniPC.PcbDoc
Modify | DDR4_BLK1.CTRL.CK0_1_P -> | In | MiniPC.PcbDoc
 | DDR4_BLK1.CTRL.CK0_P
Modify | DDR4_BLK1.CTRL.CK1_1_P -> | In | MiniPC.PcbDoc
 | DDR4_BLK1.CTRL.CK1_P
Modify | DDR4_BLK1.DL1.DQS0_1_P -> | In | MiniPC.PcbDoc
 | DDR4_BLK1.DL1.DQS0_P
Modify | DDR4_BLK1.DL2.DQS1_1_P -> | In | MiniPC.PcbDoc
 | DDR4_BLK1.DL2.DQS1_P
Modify | DDR4_BLK1.DL3.DQS2_1_P -> | In | MiniPC.PcbDoc
 | DDR4_BLK1.DL3.DQS2_P
Modify | DDR4_BLK1.DL4.DQS3_1_P -> | In | MiniPC.PcbDoc
 | DDR4_BLK1.DL4.DQS3_P
Modify | DDR4_BLK1.DL5.DQS4_1_P -> | In | MiniPC.PcbDoc
 | DDR4_BLK1.DL5.DQS4_P
Modify | DDR4_BLK1.DL6.DQS5_1_P -> | In | MiniPC.PcbDoc
 | DDR4_BLK1.DL6.DQS5_P
Modify | DDR4_BLK1.DL7.DQS6_1_P -> | In | MiniPC.PcbDoc
 | DDR4_BLK1.DL7.DQS6_P
Modify | DDR4_BLK1.DL8.DQS7_1_P -> | In | MiniPC.PcbDoc
 | DDR4_BLK1.DL8.DQS7_P
Modify | DDR4_BLK2.CTRL.CK0_1_P -> | In | MiniPC.PcbDoc
 | DDR4_BLK2.CTRL.CK0_P
Modify | DDR4_BLK2.CTRL.CK1_1_P -> | In | MiniPC.PcbDoc
 | DDR4_BLK2.CTRL.CK1_P
Modify | DDR4_INT.CTRL.CLK_1_P -> | In | MiniPC.PcbDoc
 | DDR4_INT.CTRL.CLK_P
Modify | DDR4_INT.DL1.DQS0_1_P -> | In | MiniPC.PcbDoc
 | DDR4_INT.DL1.DQS0_P
Modify | DDR4_INT.DL2.DQS1_1_P -> | In | MiniPC.PcbDoc
 | DDR4_INT.DL2.DQS1_P
Modify | DDR4_INT.DL3.DQS2_1_P -> | In | MiniPC.PcbDoc
 | DDR4_INT.DL3.DQS2_P
Modify | DDR4_INT.DL4.DQS3_1_P -> | In | MiniPC.PcbDoc
 | DDR4_INT.DL4.DQS3_P
Modify | DP_ML_LANE0_C_2_P -> DP_ML_LANE0_C_P | In | MiniPC.PcbDoc
Modify | DP_ML_LANE1_C_2_P -> DP_ML_LANE1_C_P | In | MiniPC.PcbDoc
Modify | DP_ML_LANE2_C_2_P -> DP_ML_LANE2_C_P | In | MiniPC.PcbDoc
Modify | DP_ML_LANE3_C_2_P -> DP_ML_LANE3_C_P | In | MiniPC.PcbDoc
Modify | ENET_REFCLK_C_8_P -> ENET_REFCLK_C_P | In | MiniPC.PcbDoc
Modify | PCIE.CLK_SYN._1_P -> PCIE.CLK_SYN._P | In | MiniPC.PcbDoc
Modify | PCIE.DL.RX0._1_P -> PCIE.DL.RX2._P | In | MiniPC.PcbDoc
Modify | PCIE.DL.RX1._1_P -> PCIE.DL.RX1._P | In | MiniPC.PcbDoc
Modify | PCIE.DL.RX2._1_P -> PCIE.DL.RX0._P | In | MiniPC.PcbDoc
Modify | PCIE.DL.RX3._1_P -> PCIE.DL.RX3._P | In | MiniPC.PcbDoc
Modify | PCIE.DL.RX4._1_P -> PCIE.DL.RX4._P | In | MiniPC.PcbDoc
Modify | PCIE.DL.RX5._1_P -> PCIE.DL.RX5._P | In | MiniPC.PcbDoc
Modify | PCIE.DL.RX6._1_P -> PCIE.DL.RX6._P | In | MiniPC.PcbDoc
Modify | PCIE.DL.RX7._1_P -> PCIE.DL.RX7._P | In | MiniPC.PcbDoc
Modify | PCIE.DL.TX0._1_P -> PCIE.DL.TX0._P | In | MiniPC.PcbDoc
Modify | PCIE.DL.TX1._1_P -> PCIE.DL.TX1._P | In | MiniPC.PcbDoc
Modify | PCIE.DL.TX2._1_P -> PCIE.DL.TX2._P | In | MiniPC.PcbDoc
Modify | PCIE.DL.TX3._1_P -> PCIE.DL.TX3._P | In | MiniPC.PcbDoc
Modify | PCIE.DL.TX4._1_P -> PCIE.DL.TX4._P | In | MiniPC.PcbDoc
Modify | PCIE.DL.TX5._1_P -> PCIE.DL.TX5._P | In | MiniPC.PcbDoc
Modify | PCIE.DL.TX6._1_P -> PCIE.DL.TX6._P | In | MiniPC.PcbDoc
Modify | PCIE.DL.TX7._1_P -> PCIE.DL.TX7._P | In | MiniPC.PcbDoc
Modify | PCIE_TX0_C_12_P -> PCIE_TX0_C_P | In | MiniPC.PcbDoc
Modify | PCIE_TX1_C_12_P -> PCIE_TX1_C_P | In | MiniPC.PcbDoc
Modify | PCIE_TX2_C_12_P -> PCIE_TX2_C_P | In | MiniPC.PcbDoc
Modify | PCIE_TX3_C_12_P -> PCIE_TX3_C_P | In | MiniPC.PcbDoc
Modify | PCIE_TX4_C_12_P -> PCIE_TX4_C_P | In | MiniPC.PcbDoc
Modify | PCIE_TX5_C_12_P -> PCIE_TX5_C_P | In | MiniPC.PcbDoc
Modify | PCIE_TX6_C_12_P -> PCIE_TX6_C_P | In | MiniPC.PcbDoc
Modify | PCIE_TX7_C_12_P -> PCIE_TX7_C_P | In | MiniPC.PcbDoc
Modify | REFCLK0_FMCB_C_8_P -> | In | MiniPC.PcbDoc
 | REFCLK0_FMCB_C_P
Modify | REFCLK1_FMCB_C_8_P -> | In | MiniPC.PcbDoc
 | REFCLK1_FMCB_C_P
пятница 6-сен-06.2019 12:04:29 PM |  |  |  |  | Page 11 of 15
Action | Object |  | Change Document | Status
Change Differential Pair Positive Net Name
Modify | REFCLK_DP_C_8_P -> REFCLK_DP_C_P | In | MiniPC.PcbDoc
Modify | REFCLK_SDI_C_8_P -> REFCLK_SDI_C_P | In | MiniPC.PcbDoc
Modify | TRD1_31_P -> TRD1_P | In | MiniPC.PcbDoc
Modify | TRD2_31_P -> TRD2_P | In | MiniPC.PcbDoc
Modify | TRD3_31_P -> TRD3_P | In | MiniPC.PcbDoc
Modify | TRD4_31_P -> TRD4_P | In | MiniPC.PcbDoc
Modify | USB3_port.DATA._4_P -> USB3_port.DATA._P | In | MiniPC.PcbDoc
Modify | USB3_port.SSRX._4_P -> USB3_port.SSRX._P | In | MiniPC.PcbDoc
Modify | USB3_port.SSTX._4_P -> USB3_port.SSTX._P | In | MiniPC.PcbDoc
Modify | USB3_TOD_4_P -> USB3_TOD_P | In | MiniPC.PcbDoc
пятница 6-сен-06.2019 12:04:29 PM |  |  |  |  | Page 12 of 15
Action | Object |  | Change Document | Status
Change Differential Pair Negative Net Name
Modify | CLK_DIFF1_8_N -> CLK_DIFF1_N | In | MiniPC.PcbDoc
Modify | CLK_DIFF2_8_N -> CLK_DIFF2_N | In | MiniPC.PcbDoc
Modify | DDR4_BLK1.CTRL.CK0_1_N -> | In | MiniPC.PcbDoc
 | DDR4_BLK1.CTRL.CK0_N
Modify | DDR4_BLK1.CTRL.CK1_1_N -> | In | MiniPC.PcbDoc
 | DDR4_BLK1.CTRL.CK1_N
Modify | DDR4_BLK1.DL1.DQS0_1_N -> | In | MiniPC.PcbDoc
 | DDR4_BLK1.DL1.DQS0_N
Modify | DDR4_BLK1.DL2.DQS1_1_N -> | In | MiniPC.PcbDoc
 | DDR4_BLK1.DL2.DQS1_N
Modify | DDR4_BLK1.DL3.DQS2_1_N -> | In | MiniPC.PcbDoc
 | DDR4_BLK1.DL3.DQS2_N
Modify | DDR4_BLK1.DL4.DQS3_1_N -> | In | MiniPC.PcbDoc
 | DDR4_BLK1.DL4.DQS3_N
Modify | DDR4_BLK1.DL5.DQS4_1_N -> | In | MiniPC.PcbDoc
 | DDR4_BLK1.DL5.DQS4_N
Modify | DDR4_BLK1.DL6.DQS5_1_N -> | In | MiniPC.PcbDoc
 | DDR4_BLK1.DL6.DQS5_N
Modify | DDR4_BLK1.DL7.DQS6_1_N -> | In | MiniPC.PcbDoc
 | DDR4_BLK1.DL7.DQS6_N
Modify | DDR4_BLK1.DL8.DQS7_1_N -> | In | MiniPC.PcbDoc
 | DDR4_BLK1.DL8.DQS7_N
Modify | DDR4_BLK2.CTRL.CK0_1_N -> | In | MiniPC.PcbDoc
 | DDR4_BLK2.CTRL.CK0_N
Modify | DDR4_BLK2.CTRL.CK1_1_N -> | In | MiniPC.PcbDoc
 | DDR4_BLK2.CTRL.CK1_N
Modify | DDR4_INT.CTRL.CLK_1_N -> | In | MiniPC.PcbDoc
 | DDR4_INT.CTRL.CLK_N
Modify | DDR4_INT.DL1.DQS0_1_N -> | In | MiniPC.PcbDoc
 | DDR4_INT.DL1.DQS0_N
Modify | DDR4_INT.DL2.DQS1_1_N -> | In | MiniPC.PcbDoc
 | DDR4_INT.DL2.DQS1_N
Modify | DDR4_INT.DL3.DQS2_1_N -> | In | MiniPC.PcbDoc
 | DDR4_INT.DL3.DQS2_N
Modify | DDR4_INT.DL4.DQS3_1_N -> | In | MiniPC.PcbDoc
 | DDR4_INT.DL4.DQS3_N
Modify | DP_ML_LANE0_C_2_N -> DP_ML_LANE0_C_N | In | MiniPC.PcbDoc
Modify | DP_ML_LANE1_C_2_N -> DP_ML_LANE1_C_N | In | MiniPC.PcbDoc
Modify | DP_ML_LANE2_C_2_N -> DP_ML_LANE2_C_N | In | MiniPC.PcbDoc
Modify | DP_ML_LANE3_C_2_N -> DP_ML_LANE3_C_N | In | MiniPC.PcbDoc
Modify | ENET_REFCLK_C_8_N -> ENET_REFCLK_C_N | In | MiniPC.PcbDoc
Modify | PCIE.CLK_SYN._1_N -> PCIE.CLK_SYN._N | In | MiniPC.PcbDoc
Modify | PCIE.DL.RX0._1_N -> PCIE.DL.RX2._N | In | MiniPC.PcbDoc
Modify | PCIE.DL.RX1._1_N -> PCIE.DL.RX1._N | In | MiniPC.PcbDoc
Modify | PCIE.DL.RX2._1_N -> PCIE.DL.RX0._N | In | MiniPC.PcbDoc
Modify | PCIE.DL.RX3._1_N -> PCIE.DL.RX3._N | In | MiniPC.PcbDoc
Modify | PCIE.DL.RX4._1_N -> PCIE.DL.RX4._N | In | MiniPC.PcbDoc
Modify | PCIE.DL.RX5._1_N -> PCIE.DL.RX5._N | In | MiniPC.PcbDoc
Modify | PCIE.DL.RX6._1_N -> PCIE.DL.RX6._N | In | MiniPC.PcbDoc
Modify | PCIE.DL.RX7._1_N -> PCIE.DL.RX7._N | In | MiniPC.PcbDoc
Modify | PCIE.DL.TX0._1_N -> PCIE.DL.TX0._N | In | MiniPC.PcbDoc
Modify | PCIE.DL.TX1._1_N -> PCIE.DL.TX1._N | In | MiniPC.PcbDoc
Modify | PCIE.DL.TX2._1_N -> PCIE.DL.TX2._N | In | MiniPC.PcbDoc
Modify | PCIE.DL.TX3._1_N -> PCIE.DL.TX3._N | In | MiniPC.PcbDoc
Modify | PCIE.DL.TX4._1_N -> PCIE.DL.TX4._N | In | MiniPC.PcbDoc
Modify | PCIE.DL.TX5._1_N -> PCIE.DL.TX5._N | In | MiniPC.PcbDoc
Modify | PCIE.DL.TX6._1_N -> PCIE.DL.TX6._N | In | MiniPC.PcbDoc
Modify | PCIE.DL.TX7._1_N -> PCIE.DL.TX7._N | In | MiniPC.PcbDoc
Modify | PCIE_TX0_C_12_N -> PCIE_TX0_C_N | In | MiniPC.PcbDoc
Modify | PCIE_TX1_C_12_N -> PCIE_TX1_C_N | In | MiniPC.PcbDoc
Modify | PCIE_TX2_C_12_N -> PCIE_TX2_C_N | In | MiniPC.PcbDoc
Modify | PCIE_TX3_C_12_N -> PCIE_TX3_C_N | In | MiniPC.PcbDoc
Modify | PCIE_TX4_C_12_N -> PCIE_TX4_C_N | In | MiniPC.PcbDoc
Modify | PCIE_TX5_C_12_N -> PCIE_TX5_C_N | In | MiniPC.PcbDoc
Modify | PCIE_TX6_C_12_N -> PCIE_TX6_C_N | In | MiniPC.PcbDoc
Modify | PCIE_TX7_C_12_N -> PCIE_TX7_C_N | In | MiniPC.PcbDoc
Modify | REFCLK0_FMCB_C_8_N -> | In | MiniPC.PcbDoc
 | REFCLK0_FMCB_C_N
Modify | REFCLK1_FMCB_C_8_N -> | In | MiniPC.PcbDoc
 | REFCLK1_FMCB_C_N
пятница 6-сен-06.2019 12:04:29 PM |  |  |  |  | Page 13 of 15
Action | Object |  | Change Document | Status
Change Differential Pair Negative Net Name
Modify | REFCLK_DP_C_8_N -> REFCLK_DP_C_N | In | MiniPC.PcbDoc
Modify | REFCLK_SDI_C_8_N -> REFCLK_SDI_C_N | In | MiniPC.PcbDoc
Modify | TRD1_31_N -> TRD1_N | In | MiniPC.PcbDoc
Modify | TRD2_31_N -> TRD2_N | In | MiniPC.PcbDoc
Modify | TRD3_31_N -> TRD3_N | In | MiniPC.PcbDoc
Modify | TRD4_31_N -> TRD4_N | In | MiniPC.PcbDoc
Modify | USB3_port.DATA._4_N -> USB3_port.DATA._N | In | MiniPC.PcbDoc
Modify | USB3_port.SSRX._4_N -> USB3_port.SSRX._N | In | MiniPC.PcbDoc
Modify | USB3_port.SSTX._4_N -> USB3_port.SSTX._N | In | MiniPC.PcbDoc
Modify | USB3_TOD_4_N -> USB3_TOD_N | In | MiniPC.PcbDoc
Add Component Classes
Add | Board Template Connector | To | MiniPC.PcbDoc
Remove Rooms
Remove | Room Sheet_16_DDR4 | From | MiniPC.PcbDoc
 | (Scope=InComponentClass('Sheet_16_DDR4'))
 | BottomLayer
Remove | Room Sheet_23_12V_to_5V(Scope=InComponent | From | MiniPC.PcbDoc
 | Class('Sheet_23_12V_to_5V')) BottomLayer
Remove | Room Sheet_24_12V_to_3V3(Scope=InCompone | From | MiniPC.PcbDoc
 | ntClass('Sheet_24_12V_to_3V3')) BottomLayer
Remove | Room Sheet_25_3V3_to_2V5(Scope=InCompone | From | MiniPC.PcbDoc
 | ntClass('Sheet_25_3V3_to_2V5')) BottomLayer
Remove | Room Sheet_26_3V3_to_1V8(Scope=InCompone | From | MiniPC.PcbDoc
 | ntClass('Sheet_26_3V3_to_1V8')) BottomLayer
Remove | Room Sheet_27_12V_3V3_1V8_Swiches(Scope=I | From | MiniPC.PcbDoc
 | nComponentClass('Sheet_27_12V_3V3_1V8_Swi
 | ches')) BottomLayer
Remove | Room Sheet_28_12V_to_0V9(Scope=InCompone | From | MiniPC.PcbDoc
 | ntClass('Sheet_28_12V_to_0V9')) BottomLayer
Remove | Room Sheet_29_3V3_to_0V9(Scope=InCompone | From | MiniPC.PcbDoc
 | ntClass('Sheet_29_3V3_to_0V9')) BottomLayer
Remove | Room Sheet_30_3.3V_to_0.9V(Scope=InCompon | From | MiniPC.PcbDoc
 | entClass('Sheet_30_3.3V_to_0.9V')) BottomLayer
Remove | Room Sheet_31_3.3V_to_1.0V(Scope=InCompon | From | MiniPC.PcbDoc
 | entClass('Sheet_31_3.3V_to_1.0V')) BottomLayer
Remove | Room Sheet_33_3.3V_to_DDR4_VDD(Scope=InC | From | MiniPC.PcbDoc
 | omponentClass('Sheet_33_3.3V_to_DDR4_VDD'))
 | BottomLayer
пятница 6-сен-06.2019 12:04:29 PM |  |  |  |  | Page 14 of 15
Action | Object |  | Change Document | Status
Add Rooms
Add | Room A1 (Scope=InComponentClass('A1')) | To | MiniPC.PcbDoc
 | TopLayer
Add | Room A3 (Scope=InComponentClass('A3')) | To | MiniPC.PcbDoc
 | TopLayer
Add | Room A4 (Scope=InComponentClass('A4')) | To | MiniPC.PcbDoc
 | TopLayer
Add | Room A8 (Scope=InComponentClass('A8')) | To | MiniPC.PcbDoc
 | TopLayer
Add | Room A9 (Scope=InComponentClass('A9')) | To | MiniPC.PcbDoc
 | TopLayer
Add | Room A11 (Scope=InComponentClass('A11')) | To | MiniPC.PcbDoc
 | TopLayer
Add | Room AB2 (Scope=InComponentClass('AB2')) | To | MiniPC.PcbDoc
 | TopLayer
Add | Room AB3 (Scope=InComponentClass('AB3')) | To | MiniPC.PcbDoc
 | TopLayer
Add | Room AB4 (Scope=InComponentClass('AB4')) | To | MiniPC.PcbDoc
 | TopLayer
Add | Room AB7 (Scope=InComponentClass('AB7')) | To | MiniPC.PcbDoc
 | TopLayer
Add | Room AB9 (Scope=InComponentClass('AB9')) | To | MiniPC.PcbDoc
 | TopLayer
Add | Room AB13 (Scope=InComponentClass('AB13')) | To | MiniPC.PcbDoc
 | TopLayer
Add | Room AB14 (Scope=InComponentClass('AB14')) | To | MiniPC.PcbDoc
 | TopLayer
Add | Room AB15 (Scope=InComponentClass('AB15')) | To | MiniPC.PcbDoc
 | TopLayer
Add | Room AB16 (Scope=InComponentClass('AB16')) | To | MiniPC.PcbDoc
 | TopLayer
Add | Room AB17 (Scope=InComponentClass('AB17')) | To | MiniPC.PcbDoc
 | TopLayer
Add | Room AB18 (Scope=InComponentClass('AB18')) | To | MiniPC.PcbDoc
 | TopLayer
Add | Room AB25 (Scope=InComponentClass('AB25')) | To | MiniPC.PcbDoc
 | TopLayer
Add | Room Board Template Connector | To | MiniPC.PcbDoc
 | (Scope=InComponentClass('Board Template
 | Connector')) TopLayer
Remove Differential Pair Classes
Remove | 100 | From | MiniPC.PcbDoc
Remove | DDR4_80 | From | MiniPC.PcbDoc
Remove | DDR4_SODIMM_CK0 | From | MiniPC.PcbDoc
Remove | DDR4_SODIMM_CK1 | From | MiniPC.PcbDoc
Remove | DDR4_SODIMM_CK2 | From | MiniPC.PcbDoc
Remove | DDR4_SODIMM_CK3 | From | MiniPC.PcbDoc
Remove | DDR_CKL | From | MiniPC.PcbDoc
Remove | New Class | From | MiniPC.PcbDoc
Remove | PCIE_85 | From | MiniPC.PcbDoc
Remove | SFPA_RX | From | MiniPC.PcbDoc
Remove | SFPA_TX | From | MiniPC.PcbDoc
Remove | SFPB_RX | From | MiniPC.PcbDoc
Remove | SFPB_TX | From | MiniPC.PcbDoc
Remove | USB3_85 | From | MiniPC.PcbDoc
пятница 6-сен-06.2019 12:04:29 PM |  |  |  |  | Page 15 of 15
