MSolovtsov/BachelorThesis_Manipulator/ВКРБ_Соловцов.docx

# Введение

Современные автоматизированные и робототехнические системы играют ключевую роль в широком спектре промышленных и научных задач, включая автоматизацию производственных процессов, выполнение операций в труднодоступных или опасных для человека условиях, а также обучение и исследование в области мехатроники и управления. Одним из важнейших элементов манипулятора является захватное устройство, обеспечивающее взаимодействие с объектами окружающей среды.

Разработка привода захватного устройства представляет собой актуальную инженерную задачу, требующую комплексного подхода, включающего как механическое, так и электрическое проектирование, синтез систем автоматического управления и программную реализацию. Особенно важной является реализация привода для учебных стендов, которые используются в образовательных учреждениях для подготовки специалистов в области робототехники. Такие установки должны быть не только функциональными и надёжными, но и достаточно простыми для анализа, моделирования и модернизации.

Целью данной работы является разработка привода трёхпальцевого захватного устройства, предназначенного для учебного стенда манипулятора. В процессе выполнения работы рассматриваются все ключевые этапы: от постановки технического задания и конструкторских расчётов до проектирования электронных компонентов системы управления и разработки программного обеспечения.

Практическая значимость заключается в создании законченного решения, которое может быть использовано в качестве учебного и исследовательского стенда.

# Техническое задание для привода схвата

Наименование проекта: Разработка трехпалого схвата для лабораторного стенда-манипулятора

Исполнитель: Соловцов М.А.

Дата: 29.10.2024

Цель разработки

Создание трехпалого схвата для учебного манипулятора, предназначенного для проведения лабораторных работ по автоматизации, робототехнике и мехатронике. Схват должен быть безопасен, прост в управлении, и позволять студентам практиковаться в разработке управления манипуляторами и изучении принципов захвата и перемещения объектов.

Область применения

Схват предназначен для использования в учебных лабораториях в составе манипуляторного стенда и должен позволять безопасно захватывать и перемещать легкие учебные объекты различной формы и размера.

Требования к конструкции

- Количество зажимов: 3.
- Материал пальцев: пластик, возможны мягкие накладки (резина или силикон).
- Механизм привода пальцев: двигатель постоянного тока с червячной передачей.

Требования к приводу и мощности двигателя

- Тип двигателя: постоянного тока.
- Мощность двигателя: до 5 Вт.
- Напряжение питания: от источника постоянного тока 5-12 В.
- Управление: по положению.

Основные функциональные требования

- Статическая ошибка по угловому положению не должна превышать 10%.
- Скорость раскрытия/закрытия пальцев: 5 рад/с.
- Время реакции: не более 3 секунды.

Требования к системе управления

- Тип управления: простое цифровое управление (через микроконтроллер семейства STM32).
- Обратная связь: датчики положения (например, потенциометры).

# 1. Разработка и синтез привода захватного устройства

Анализируя различные типы захватов и их механизмы, мы пришли к выводу, что наше захватное устройство должно быть трехпалым механическим, оснащенным плоскопараллельным кинематическим механизмом. Такая конструкция обеспечивает универсальность, позволяя эффективно работать с объектами различной формы и размеров. Плоскопараллельный механизм гарантирует стабильное удержание деталей за счет равномерного распределения усилия на пальцы, что особенно важно при манипуляциях с хрупкими или нестабильными заготовками. Это решение оптимально для наших целей, так как оно сочетает простоту конструкции с надежностью и широкими функциональными возможностями.

На рис. 1 представлена планируемая структурная схема схвата манипулятора. Она иллюстрирует основные компоненты и их взаимосвязи, позволяя понять, как задумана работа схвата. В ней показаны различные элементы, такие как элементы силовой части, датчики и система управления в целом, которые совместно обеспечивают функциональность привода. Структурная схема помогает визуализировать принципы работы схвата и служит основой для дальнейшего проектирования и оптимизации его работы.

Рис. 1. Структурная схема привода захватного устройства.

КУ – корректирующее устройство изменяет сигнал ошибки так, чтобы привести привод к нужным характеристикам.

УМ – усилитель мощности используется для управления потоком энергии от источника. Мощность на выходе значительно больше, чем мощность входного сигнала. Примеры: силовые транзисторы, электромагнитные устройства, гидравлика, тиристоры, магнитные и пневматические элементы.

ИД – исполнительный двигатель преобразует поданный на него сигнал в механическое движение, чтобы выполнить заданное действие в системе. Он служит для управления различными механизмами, перемещая или приводя в движение объект управления.

МП – механическая передача передаёт движение и силу от двигателя к объекту регулирования. Она состоит из набора деталей, таких как шестерни, ремни, цепи, валы и шкивы. Эти компоненты работают вместе, чтобы изменить скорость, направление или силу движения.

ОР – объектом регулирования в данной системе является захватное устройство и груз.

ДП – датчик положения

ОС по положению – обратная связь по положению позволяет добиться от привода отработки входного воздействия.

## 1.1. Конструкторская часть

В данной части работы предстоит разработать конструкцию захвата для учебного манипулятора. Рассмотрим основные требования к конструкции:

- Возможность изготовления деталей захвата с помощью 3D-принтера, что предполагает простую форму и сравнительно крупные размеры компонентов.
- Обеспечение легкой и удобной сборки конструкции.
- Использование стандартных и доступных покупных элементов, которые должны быть недорогими.
- Необходимость обеспечения параллельного движения пальцев захвата для эффективного удержания объектов.

### 1.1.1. Расчет механической передачи

Одним из самых простых и популярных решений для создания трёхпалого захвата является червячная передача. Она из себя представляет механизм, который передаёт вращение за счёт зацепления между винтообразным элементом (червяком) и зубчатым колесом. Червяк похож на винт с особой резьбой, а червячное колесо — на шестерёнку с наклонными зубьями. Такая форма зубьев делает передачу более прочной и долговечной.

Червячные передачи используются, когда нужно передавать движение между пересекающимися валами, чаще всего под углом 90 градусов. При вращении червяк плавно зацепляется с колесом, заставляя его крутиться.

Достоинства:

- Позволяет сильно уменьшить скорость вращения за один шаг
- Работает плавно и почти бесшумно

Недостатки:

- Теряет много энергии при передаче движения
- Нужна высокая точность сборки и настройка
- Может перегреваться, поэтому нужен хороший отвод тепла

По форме боковой поверхности витка червяки подразделяются на архимедовы (ZA), конволютные (ZN), эвольвентные (ZI), нелинейчатые с поверхностью, образованной конусом (ZK), и с вогнутым профилем витка (ZT). Выберем эвольвентный, как наиболее распространенный вид. [1]

Для 3D печати популярным материалом является ABS-пластик. Он обладает низким коэффициентом трения и хорошо сопротивляется износу при скольжении, что критично для червячных передач. Также если при печати поставить коэффициент заполнения детали 60%, то он будет менее хрупкий, и выдержит высокие нагрузки без разрушения, и может выдерживать высокие рабочие температуры, что важно, так как червячная передача может нагреваться при работе.

Кинематический расчёт

Определим сначала число заходов червяка Zч = 4 (из стандартного ряда числа нарезок = 1; 2; 4). Число зубьев колеса выберем из стандартного 2-го ряда (Приложение А) Zк = 27.

В червячной передаче передаточное число (i) определяется как отношение числа зубьев колеса (Zк) к числу заходов червяка (Zч):

i= (Zк)/(Zч)=27/4=6, 75 (1)

Это связано с тем, что при каждом полном обороте червяка колесо поворачивается на количество зубьев, равное числу заходов червяка. Поэтому для полного оборота колеса требуется, чтобы червяк совершил Zк / Zч оборотов.

Необходимо отметить, что в червячной передаче делительные диаметры червяка и колеса не обкатываются друг о друга, как в обычных зубчатых передачах, а взаимодействуют посредством скольжения. Поэтому передаточное число не может быть выражено через отношение делительных диаметров.

Также важной величиной в расчете червячной передачи является скорость скольжения Vs. Она определяется по формуле [2]:

Vs= (4.3 ∙ (π ∙ n_н)/30 ∙ i)/(10^3) = (4.3 ∙ (π ∙ 10)/30 ∙ 6.75)/(10^3)=0,03 м/с, (2)

где

n_н =10 об/мин – частота вращения червячного колеса.

При условии низкой скорости скольжения (0,03 м/с) динамические и тепловые эффекты минимальны, что благоприятно сказывается на долговечности материала. ABS обладает пределом прочности при растяжении порядка 50–90 МПа, а типичный предел текучести может находиться около 55–65 МПа. При выборе коэффициента запаса прочности (обычно 2–3 для пластмасс) допустимое напряжение для расчетов получается в диапазоне примерно 20–30 МПа. Таким образом, можно принять допускаемое напряжение([σн]) для ABS около 25 Мпа [3].

Крутящий момент на червячном колесе примем равным номинальному моменту на выходном валу мотора-редуктора JGA25-370 (предварительно выбранном) T = M_н = 0,95 Н ∙ м.

Геометрический расчет

Назначим из стандартных рядов модуль (Приложение А) для всех колес m=1 мм и коэффициент диаметра червяка (Приложение А) q=20 мм. Тогда межосевое расстояние определяют по формуле [2]:

a_ω = (m ∙(q + Z_к ))/2= (1 ∙(20 + 27))/2= 23,5 мм (3)

Определяем коэффициент смещения

x=(a_ω)/m-0,5(Z_к +q)=23,5-0,5(27+20)=0<1 (4)

В нашем случае коэффициент смещения удовлетворяет условию, поэтому размеры червяка и колес считаются следующим образом [4]:

Делительный диаметр червяка d_ч =q∙m=20∙1=20 мм (5)

Диаметр вершин червяка d_(aч) =d_ч +2m=20+2=22 мм (6)

Диаметр впадин червяка d_(fч) =d_ч -2,4m=20-2,4=17,6 мм (7)

Длина нарезанной части червяка

b_ч ≥|10+5,5|x| + Zч|∙m-C=(10 +0+4)∙1-0=14 мм, (8)

где C=0 при x≤0 , C=(70+60∙x)∙m/(Zк) при x>0 .

Назначим b_ч =17 мм >14 мм.

Делительный диаметр колеса d_к =Z_к ∙m=27 мм. (9)

Диаметр вершин колеса d_(aк) =Z_к +2m(1+x)=27+2=29 мм (10)

Диаметр впадин колеса

d_(fк) =Z_к -2m(1,2-x)=27-2,4=24,6 мм (11)

Ширина венца b_к ≥ψ_a ∙a_ω =0,315∙23,5=7,4 мм, (12)

где ψ_a =0,355 при Zч = 1 или 2, ψ_a =0,315 при Zч = 4.

Назначим b_к =10 мм >7,4 мм.

Угол подъема линии витка на делительном цилиндре (и на начальном цилиндре, т.к. x=0 )

γ=arctg((Zч)/q)=arctg(4/20)=11,31° (13)

Основной угол подъема (рассчитывается для червяка ZI)

cos⁡(γ_b )=cos(γ)cos⁡(20°) , (14)

тогда (учитывая, что 0°<γ_b <90° ) γ_b = 22,9° .

Все основные геометрические параметры механической передачи представлены в таблице 1 (Приложение Б).

Помимо прочего необходимо расположить три зубчатых колеса на равные углы относительно червяка. Червяк при вращении будет перемещаться вдоль своей оси, и чтобы три колеса были правильно зацеплены, их зубья должны соответствовать текущему положению витков червяка. То есть, нужно повернуть каждое последующее колесо на определенный угол, чтобы их зубья совпали с витками червяка при их угловом смещении на 120°. Значит, для компенсации этого смещения колесо должно быть повернуто на угол

θ= (120°)/i=(120°)/(6,75)=17,7778° . (15)

Таким образом, каждое следующее колесо должно быть повернуто на 17,7778° относительно предыдущего. Поскольку три колеса, то углы будут:

первое колесо: 0°;

второе колесо: 17,7778° ≈ 17°46'40'';

третье колесо: 35,5556° ≈ 35°33'20'' относительно первого.

Силовой расчет

Для расчета КПД ( η ) передачи необходимо найти приведенный угол трения ( ρ ) между материалами червяка и колеса. К сожалению, конкретных данных о коэффициенте трения между деталями из ABS без смазки в доступных источниках нет. Однако известно, что сам материал обладает низким коэффициентом трения и часто используется для покрытия трущихся деталей, что повышает их эксплуатационные качества и позволяет функционировать без смазки.

Для оценки приведенного угла трения в червячной передаче можно воспользоваться известными коэффициентами трения для ABS с другими материалами. Например, коэффициент трения ABS по стали без смазки составляет 0,17–0,20. [5] Предполагая, что коэффициент трения в нашем случае будет в этом же диапазоне, можно рассчитать приведенный угол трения по формуле:

ρ=arctg(f)=arctg(0,20)≈ 11,3° , (16)

где f — коэффициент трения.

η=(tg(γ))/(tg(γ+ρ))=(tg(11,31°))/(tg(11,31°+11,3°))=0,48 (17)

Получается, что КПД в данном случае очень невысокий. Тогда оценим приведенный угол трения ABS в тех же условиях, но с масляной смазкой, коэффициент трения которой составляет 0,014–0,020 [5].

ρ=arctg(f)=arctg(0,017)≈ 0,97° , (18)

при f = 0,017 (среднее значение).

η=(tg(γ))/(tg(γ+ρ))=(tg(11,31°))/(tg(11,31°+0,97°))=0,92 (19)

Стоит отметить, что это приблизительная оценка. Точные значения коэффициента трения зависят от множества факторов, включая качество поверхности, температуру, влажность и скорость скольжения.

Осевая сила на червяке, равная окружной силе на колесе [2]

F_(aч) =F_(tк) =(2T)/(d_к)=(2∙0,95∙10^3)/27=70,4 Н (20)

Осевая сила на колесе, равная окружной силе на червяке

F_(aк) =F_(tч) =(2T)/(d_ч ∙i∙η)=(2∙0,95∙10^3)/(20∙6,75∙0,92)=15,3 Н (21)

Радиальные усилия на колесе и червяке

F_(rк) =F_(rч) =F_(tк) ∙tg(20°)=25,6 Н (22)

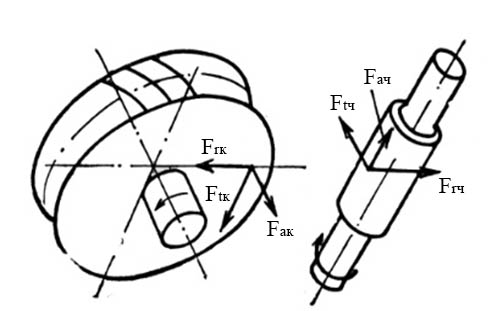
[picture p21: figure]

Рис. 2. Силы, действующие в зацеплении червячной передачи

### 1.1.2. Расчет валов и опор

Расчет вала на изгибную прочность

На вал при червячной передаче действует осевая и радиальные силы.

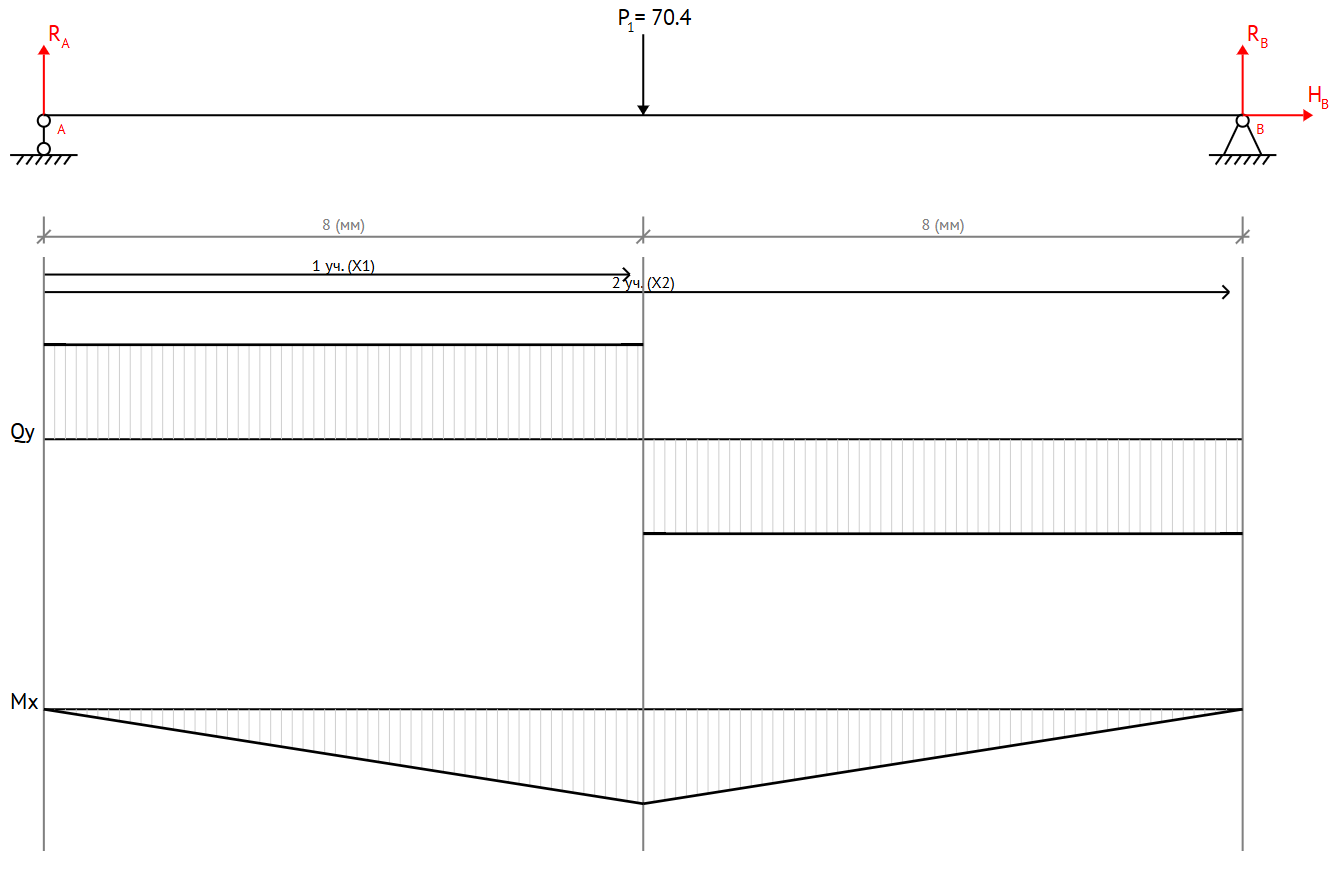
[picture p22: figure]

Рис. 3. Эпюры. Проекция на плоскость OXZ.

Расчет вала в плоскости OXZ (на схеме P_1 =F_(tк) ):

{, -F_(tк) ∙l+R_(By) ∙2l=0, R_(Ay) ∙2l-F_(tк) ∙l=0 (23)

{, -70,4∙8+R_(By) ∙16=0, R_(Ay) ∙16-70,4∙8=0 (24)

R_(Ay) =R_(By) =35,2 Н (25)

Проверка:

R_(Ay) -F_(tк) +R_(By) =0 (26)

35,2-70,4+35,2=0 Н (27)

M_(изг.y) =563,2 Н ∙ мм (28)

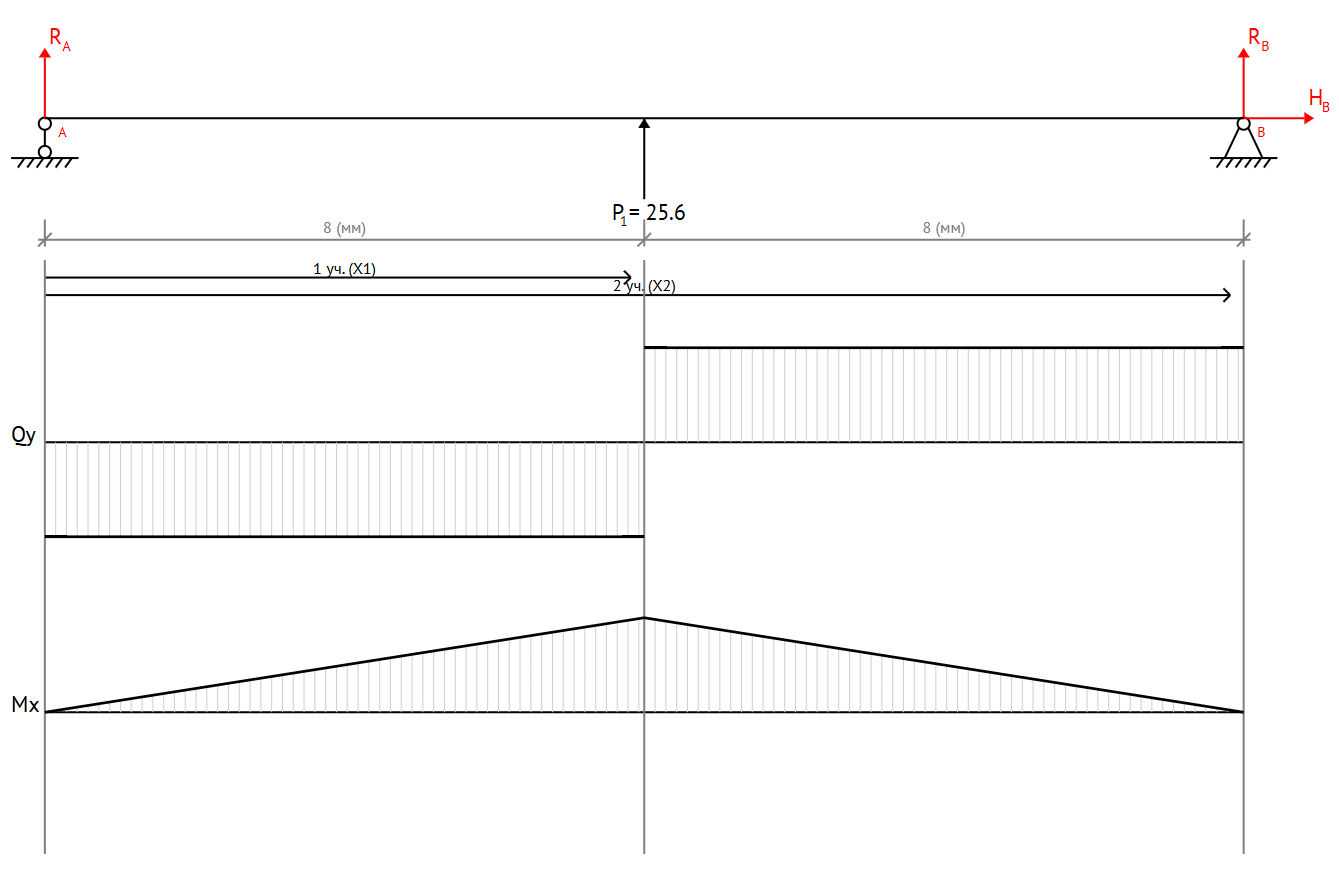
[picture p23: figure]

Рис. 4. Эпюры. Проекция на плоскость OYZ.

Расчет вала в плоскости OYZ (на схеме P_1 =F_(rк) ):

{, F_(rк) ∙l+R_(Bx) ∙2l=0, R_(Ax) ∙2l+F_(rк) ∙l=0 (29)

{, 25,6∙8+R_(Bx) ∙16=0, R_(Ax) ∙16+25,6∙8=0 (30)

R_(Ax) =R_(Bx) =-12,8 Н (31)

Проверка:

R_(Ax) +F_(rк) +R_(Bx) =0 (32)

-12,8+25,6-12,8=0 Н (33)

M_(изг.x) =204,8 Н ∙ мм (34)

Реакции в опорах:

F_A =√(R_(Ax) ^2 +R_(Ay) ^2)=√(12,8^2 +35,2^2)=37,46 Н (35)

F_B =√(R_(Bx) ^2 +R_(By) ^2)=√(12,8^2 +35,2^2)=37,46 Н (36)

Изгибающий момент:

M_(изг.) =√(M_(изг.x) ^2 +M_(изг.y) ^2)=√(563,2^2 +204,8^2)=599,28 Н ∙ мм (37)

Приведенный момент:

M_(прив.) =√(M_(изг.) ^2 +0,75∙T^2)=√(599,28^2 +0,75∙950^2)=1017,85 Н ∙ мм (38)

Диаметр вала:

d≥³√((M_(прив.))/(0,1∙[σ_Н ]))=³√((1017,85)/(0,1∙25))=7,41 мм (39)

Расчет вала на крутильную прочность

[τ]=0,58∙[σ_Н ]=0,58∙25=14,5 МПа, (40)

где [τ] – допускаемое касательное напряжение.

M_(кр.) =T=950 Н ∙ мм (41)

d≥³√((M_(кр.))/(0,2∙[τ]))=³√(950/(0,2∙14,5))=6,89 мм (42)

Условие крутильной жесткости.

∆φ ≤ [φ] (43)

[φ] = 10', (44)

где [φ] – допускаемое значение угла закручивания валика, угл.мин.

Расчет будем вести с учетом того, что по всей длине вала (16 мм) действует постоянный крутящий момент, равный 950 Н·мм.

d≥⁴√((64∙M_(кр.) ∙l)/(π∙G∙[φ])) , (45)

где G – модуль упругости второго рода. Он характеризует способность материала сопротивляться деформациям сдвига. Для пластика ABS значение модуля сдвига можно оценить, используя известные значения модуля Юнга (E) и коэффициента Пуассона (ν). Связь между этими величинами определяется формулой:

G=E/(2(1+ν))=3/(2(1+0,375))=1,09 ГПа, (46)

где E — модуль Юнга, ν — коэффициент Пуассона.

Для ABS 6,6 модуль Юнга составляет примерно 2–4 ГПа [6]. Коэффициент Пуассона для ABS обычно находится в диапазоне 0,35–0,4. Подставляя средние значения в формулу, получили G=1,09 ГПа. Тогда по формуле (45):

d≥⁴√((64∙950∙16)/(π∙1,09∙10^9 ∙0,06108))=0,26 мм (47)

Исходя из расчетов, представленных выше, выбираем диаметр валов на оси зубчатых колес d=8 мм.

Расчет подшипника

n_н =10 об/мин – частота вращения вала,

L_h =10000 часов долговечность,

d=8 мм – предварительно рассчитанный диаметр вала.

Так как n > 1 об/мин, то подбор подшипника нужно вести по динамической грузоподъемности.

(C)_p ≤C . (48)

Основные расчетные формулы:

(C)_p =0,01P³√(60n_н L_h) ; (49)

P=(VXF_(rк) +YF_(aк) )K_σ K_T . (50)

Так как не заданы условия эксплуатации, принимаем коэффициенты безопасности и температуры соответственно:

K_σ =1, K_T =1.

Вращается внешнее кольцо, значит: V = 1,2.

Радиальную силу и осевую нагрузку, воспринимаемые подшипником, нашли выше (формулы (21) и (22)), и они не равны нулю. Следовательно, по формуле (51) [7]

(F_(aк))/(V∙F_(rк))=(15,3)/(1,2∙25,6)= 0,498 (51)

можно выбрать однорядный радиально–упорный подшипник с углом контакта (так как 0,35≤(F_a)/(VF_r)≤0,7 ).

По таблице находим значения коэффициентов [7]: Х = 0,45 ; Y = 1,13.

Тогда по формуле (50) и (49):

P=1,2∙0,45∙25,6+1,13∙15,3=31,113 Н, (52)

(C)_p =0,01∙31,113³√(60∙10∙10000)=56,54 Н. (53)

По каталогу с учетом, что d=8 мм, выбираем подшипник 1006098 ГОСТ 831-75 [8] ( C=1400 Н, С_0 =545 Н ).

Проверка расчетного условия показывает, что данный подшипник подходит:

(C)_p = 56,54 Н < 1400 H= C . (54)

На основании расчетов приведем конструкцию проектируемого привода. На рис. 5 представлена кинематическая схема трехпалого свата.

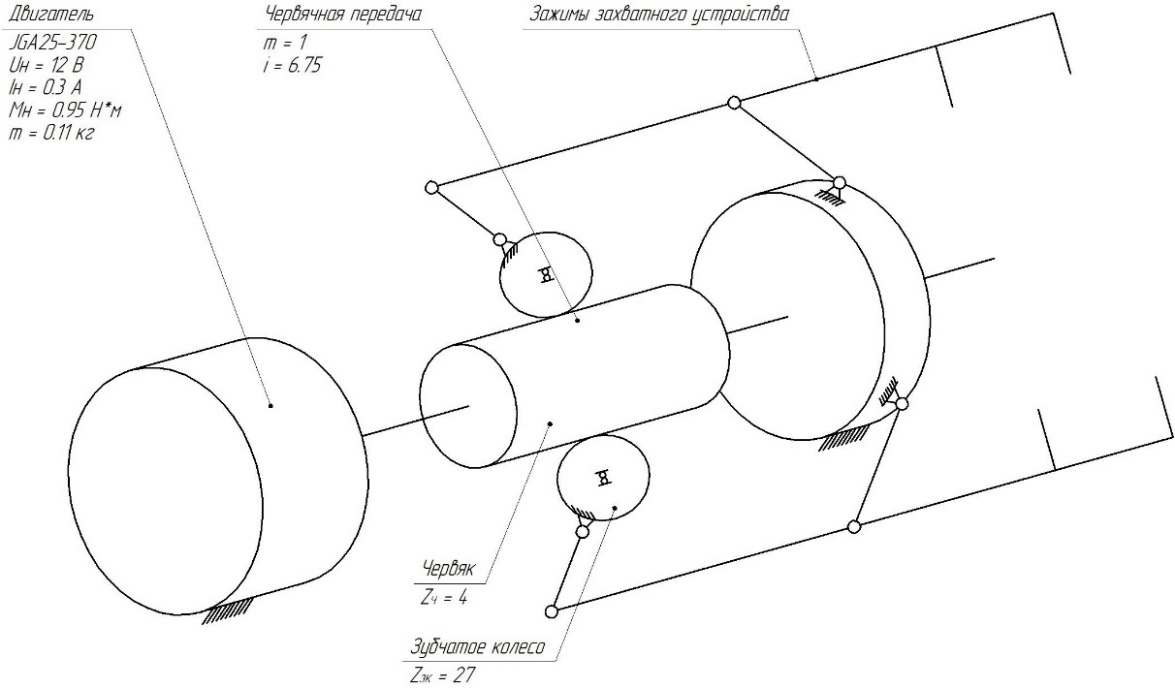
[picture p24: figure]

Рис. 5. Кинематическая схема трехпальцевого схвата.

На рисунке 1 (Приложение В) приведена детальная 3D модель привода захватного устройства учебного робота-манипулятора.

Захват начинается с того, что двигатель передаёт вращательное движение на червячную передачу. Червячная передача снижает скорость вращения двигателя, при этом повышая крутящий момент. Это позволяет создать мощное и стабильное усилие, необходимое для надёжного захвата различных предметов.

Червячная передача преобразует вращательное движение в поступательное, передавая его на механизм, управляющий тремя зажимами захватного устройства. Червяк воздействует на шестерёнки, которые синхронно сближают или раздвигают зажимы.

Три зажима расположены вокруг центральной оси захвата равномерно. Их движение согласовано благодаря червячной передаче, что позволяет зажимам плавно сходиться к центру или расходиться, обеспечивая равномерное распределение усилия. Это позволяет надёжно захватывать как мелкие, так и крупные объекты, без риска их смещения.

Детали для этого трёхпальцевого манипулятора будут напечатаны на 3D-принтере. Это значит, что мы создадим чертежи и с помощью 3D-печати сделаем нужные части для захвата. Использование такого принтера позволяет изготовить детали точно по нашим размерам и формам, а также ускоряет процесс, потому что детали можно будет сразу собрать и протестировать на стенде.

В качестве датчика углового положения пальцев схвата был выбран бесконтактный энкодер AS5600 с диапазоном измерения в 360 ° .

В первоначальном положении угол поворота пальцев схвата манипулятора составляет 0 ° . Их максимальный угол поворота равен 60 ° , что соответствует смыканию рабочей части данных пальцев. Данные углы будут обеспечены программно, однако дополнительно планируется добавить ограничители поворота.

В качестве исполнительного двигателя был выбран мотор-редуктор JGA25-370, поскольку он является относительно дешевым и находится в широком доступе. А также, данный электродвигатель есть в легкой доступности на кафедре.

Таким образом, на базе уже существующего стенда появится более сложная и гибкая система с трёхпальцевым захватом, который позволит выполнять новые задачи, требующие более точного и устойчивого захвата различных объектов.

## 1.2. Энергетический расчет

В качестве исполнительного двигателя был предварительно выбран мотор-редуктор JGA25-370. Документальные параметры данного электродвигателя с передаточным отношением 103 приведены в таблице 2 (Приложение Б).

Все параметры выбранного двигателя известны, так как он находится на кафедре и ранее неоднократно использовался в различных научных и учебных проектах. Наличие опыта работы с этим двигателем позволяет с уверенностью полагаться на его характеристики и учитывать их в расчетах и разработке текущей задачи.

R=R_я – сопротивление обмоток двигателя,

k_м – коэффициент момента,

k_e =k_ω – коэффициент противо-ЭДС,

T_e =T_э – электрическая постоянная времени,

J_e =J_(дв) – момент инерции двигателя,

J_(r_e) =J_(ред пр) – момент инерции редуктора, приведенный к валу двигателя.

Были введены дополнительно следующие переменные:

J=J_(дв) +J_(ред пр) - суммарный момент инерции, приведенный к валу исполнительного двигателя,

T_(эм) =(R_я ∙J)/(k_м ∙k_ω) – электромеханическая постоянная времени,

T_э – электрическая постоянная времени.

В результате ранее была получена передаточная функция по положению двигателя постоянного тока, которая выглядит следующим образом:

W_(дв) (s)=(1/(k_ω))/(is(T_(эм) T_э s^2 +T_(эм) s+1))≅(k_(нч))/(s(T_(эм) s+1)(T_э s+1)) (55)

, где k_(нч) =1/(i∙k_ω) – коэффициент усиления неизменяемой части.

В соответствии с техническими параметрам для данного мотор-редуктора значение коэффициента момента данного двигателя:

k_м =(M_(дн))/(I_н)=(M_н)/(I_н ∙i∙η_(ред)) (56)

k_м =(0,196)/(0,3∙103∙0,855)=0,0074 (57)

Поскольку порядки коэффициентов момента и противо-ЭДС приблизительно равны, то было применено следующее допущение:

k_м =k_ω =0,0074 (58)

Ранее по графику ЛФЧХ двигателя были уже определены интересующие параметры исполнительного двигателя:

T_(эм) ≅0,063 с (59)

Поскольку данный двигатель имеет мощность менее 100 Вт, то было принято следующее приближение:

T_э ≅0,1∙T_(эм) =0,0063 с (60)

Проверим приближение, принятое в формуле (55). Для этого найдем корни знаменателя и убедимся, что они не являются мнимыми.

0,063∙0,0063∙s^2 +0,063 ∙s^2 +1=0 (61)

s_1 =-140,8; s_2 =-17,9 (62)

Далее была определено значение сопротивления якорной обмотки исполнительного двигателя. Для установившегося режима запишем следующее уравнение:

U_н =I_н ∙R_я +E (63)

E=k_ω ∙ω_(дв) (64)

ω_(дв) =(π∙n_(дв))/30 (65)

Следовательно, сопротивление можно определить следующим образом:

R_я =(U_н -k_ω ∙(π∙n_(дв))/30)/(I_н) (66)

R_я =(12-0,0074∙(π∙4738)/30)/(0,3)≅27,8 Ом (67)

На основании данных параметров был определен суммарный момент инерции, приведенный к валу исполнительного двигателя:

J=(k_м ∙k_ω ∙T_(эм))/(R_я) (68)

J=(0,0074∙0,0074∙0,063)/(27,8)≅0,124∙10^(-6) кг∙м^2 (69)

Для двигателя со сплошным ротором можно принять следующее соотношение:

J_(ред пр) ≅(0,1…0,15)J_(дв) (70)

J=J_(дв) +J_(ред пр) =1,15J_(дв) (71)

J_(дв) =(0,124∙10^(-6))/(1,15)≅0,108∙10^(-6) кг∙м^2 (72)

J_(ред пр) =0,016∙10^(-6) кг∙м^2 (73)

В разрабатываемом приводе схвата манипулятора будет использоваться точно такой же исполнительный двигатель, однако будет выбран редуктор с передаточным отношением 500 и дополнительно введена одноступенчатая зубчатая передача с передаточным отношением 6,75.

Общее передаточное число механических передач будет равно:

i_(общ) =i_(ред) ∙i_(доп) (74)

i_(общ) =500∙6,75=3375 (75)

Параметры для мотор-редуктора JGA25-370 с передаточным отношением 500 приведены в таблице 3 (Приложение Б).

Приведем основные формулы энергетического расчета для точечного режима:

M_т = J_н ∙α(t)+ M_c (76)

, где M_т - требуемый момент на валу привода;

M_(тд) = (M_т)/(η_(ред) ∙i_(общ))+ J_(дв пр) ∙ i_(общ) ∙ α(t) (77)

, где M_(тд) - требуемый момент двигателя;

U_(тя) = (R_я)/(K_M)∙M_(тд) +K_ω ∙i_(общ) ∙ α(t) (78)

, где U_(тя) - требуемое управляющее напряжение.

Для проверки рассчитанных значений момента и напряжения по допустимым будем использовать:

M_(тд) = M_(дм) ≤ M_(дд) = 0,9 ∙ λ_M ∙ M_н (79)

, где λ_M – коэффициент форсирования по моменту;

M_(дд) , M_(дм) – допустимый и максимальный моменты двигателя;

U_(тя) = U_(ям) ≤ U_(яд) = 0,95 ∙ λ_(ск) ∙ U_н (80)

, где λ_(ск) – коэффициент форсирования по скорости.

U_(яд) , U_(дм) – допустимое и максимальное напряжение якоря двигателя.

Однако для данного привода приведенные формулы изменятся. При сжатии схватом выбранного объекта составляющие формул (76), (77) и (78), содержащие скорость и ускорение объекта регулирования, будут равны 0, поскольку движение пальцев схвата практически отсутствует. Однако при движении пальцев до момента соприкосновения с захватываемым объектом составляющая формулы (76), содержащая момент сопротивления движения, будет равна 0, так как пальцы схвата не оказывают усилие на захватываемый объект. Следовательно, разделим данные формулы на два случая и проверим каждый из них.

При сжатии захватываемого объекта формулы будут выглядеть следующим образом:

M_т = M_c (81)

M_(тд) = (M_т)/(η_(ред) ∙i_(общ)) (82)

U_(тя) = (R_я)/(K_M)∙M_(тд) (83)

При свободном движении пальцев схвата до соприкосновения с захватываемым объектом формулы примут следующий вид:

M_т = J_н ∙α(t) (84)

M_(тд) = (M_т)/(η_(ред) ∙i)+ J_(дв пр) ∙i_(общ) ∙ α(t) (85)

U_(тя) = (R_я)/(K_M)∙M_(тд) +K_ω ∙i_(общ) ∙ α(t) (86)

Предварительно определим значения моментов инерции нагрузки и силового редуктора с передаточным отношением 500.

Примем увеличение момента инерции редуктора с передаточным отношением 500, приведенного к валу исполнительного двигателя, в 5 раз по сравнению с редуктором с передаточным отношением 103.

J_(ред пр) ^(') =5J_(ред пр) =0,08∙10^(-6) кг∙м^2 (87)

Тогда приведенный момент инерции двигателя рассчитаем по следующей формуле:

J_(дв пр) =J_(ред пр) ^(') + J_(дв) (88)

J_(дв пр) = (0,08+ 0,108) ∙ 10^(-6) =0,188 ∙ 10^(-6) кг∙м^2 (89)

Приведем расчет для определения момента инерции нагрузки:

J_н =J_(пальца) +J_(опоры пальца) +J_(зк) (90)

Момент инерции зубчатого колеса определяется по следующей формуле:

J_(зк) = (π∙b∙ρ∙d^4 ∙10^(-12))/32 (91)

, где b - ширина (толщина) зубчатого колеса в мм,

ρ - плотность материала зубчатого колеса в кг/м³,

d - наружный диаметр зубчатого колеса в мм,

10⁻¹² - поправочный коэффициент для перевода единиц измерения в СИ.

Разобьем все детали конструкции на простейшие геометрические фигуры и определим момент инерции:

J_н =1/6∙0,112∙0,0575+0,112∙0,0265^2 +0,112∙0,178^2 +1/12∙0,0115∙ ∙0,056^2 ++0,0115∙0,11^2 +0,0115∙0,048^2 +1/12∙0,01∙0,092^2 ++ 0,01∙0,1045^2 +0,01∙0,029^2 +1/12∙0,011∙0,078^2 +0,011∙0,059^2 ++ 0,011∙0,0315^2 ++(π∙10∙1,14∙27^4 ∙10^(-12))/32+0,008∙0,0195^2 +0,008∙0,01575^2 ++ (π∙17∙1,14∙20^4 ∙10^(-12))/32≅ 0,0051 кг∙м^2 (92)

Проведем расчет для случая, когда схват сжимает требуемый объект.

Рассчитаем требуемый момент на валу привода:

M_т =10∙0,178=1,78 Н∙м (93)

Рассчитаем требуемый момент на валу двигателя:

M_(тд) = (1,78)/(0,855∙3375)=0,00062 Н∙м (94)

Рассчитаем требуемое напряжение якоря:

U_(тя) = (27,8)/(0,0074)∙0,00278≅10,44 В (95)

Сравним рассчитанные значения момента и напряжения с допустимыми:

M_(тд) = 0,00062 Н∙м ≤ M_(дд) = 0,9∙2,5∙ 0,0022=0,00495 Н∙м (96)

U_(тя) = 10,44 В≤ U_(яд) = 0,9 ∙1 ∙ 12=10,8 В (97)

Проведем расчет для случая, когда пальцы схвата движутся свободно:

Рассчитаем требуемый момент на валу привода:

M_т =1∙0,0051=0,0051 Н∙м (98)

Рассчитаем требуемый момент на валу двигателя:

M_(тд) = (0,0051)/(0,855∙3375)+ 0,188∙ 10^(-6) ∙ 3375∙ 1≅0,00064 Н∙м (99)

Рассчитаем требуемое напряжение якоря:

U_(тя) = (27,8)/(0,0074)∙0,0001+0,0074∙750∙ 1≅5,93 В (100)

Сравним рассчитанные значения момента и напряжения с допустимыми:

M_(тд) = 0,00064 Н∙м ≤ M_(дд) = 0,9∙2,5∙ 0,0022=0,00495 Н∙м (101)

U_(тя) = 5,93 В≤ U_(яд) = 0,9 ∙1 ∙ 12=10,8 В (102)

Максимальные значения требуемых момента двигателя и напряжения якоря получились меньше допустимых при свободном движении пальцев схвата и при сжатии требуемого объекта. Следовательно, предварительно выбранный мотор-редуктора JGA25-370 можно использовать в разрабатываемом приводе. На этом моменте считаем энергетический расчет оконченным.

## 1.3. Модель и синтез САУ

Синтез системы необходимо проводить с учетом углов положения, то есть во время движения пальцев захватного устройства. Для реализации данного процесса будет использована среда Matlab, с помощью которой проанализируем его работу с учетом всех необходимых параметров.

### 1.3.1. Линейная модель привода

На первом этапе составим математическую модель, позволяющую промоделировать непосредственное перемещение объекта. То есть, движения пальцев схвата до прикосновения с захватываемым объектом и возврат пальцев в исходное положение.

Параметры для синтезируемого привода приведем в соответствующем m-файле, который представлен ниже.

% Техническая информация о JGA25-370

n = 46*103;% Об/мин

i0 = 500;

isum = 3375;%

w = pi*n/30;% рад/с

In = 0.3;% A

Un = 12;% B

R = 27.8;% Ом

ke = (Un-In*R)/w;

km = ke;

Je = 0.108*10^(-6);% кг*м2

Jr = 0.016*10^(-6);% кг*м2

Tm = 0.063;% с

Te = 0.1*Tm;% с

L = Te*R;% Гн

В соответствии со структурной схемой разрабатываемого привода схвата составим математическую модель, описывающую процесс сжатия и разжатия схвата, представленную на рис. 6.

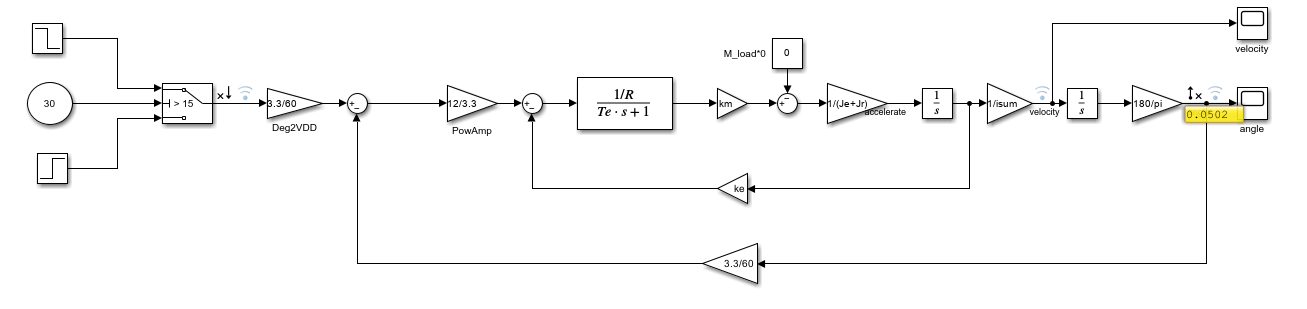
[picture p25: figure]

Рис. 6. Линейная математическая модель привода схвата без коррекции.

Так как задающее воздействие в градусах, то для перехода к напряжению, которое использует микроконтроллер, а именно 3,3 В, нужен блок deg2VDD, значение в нем k_(лог1) = 3.3/60 В/(°) . В обратной связи по напряжению находится энкодер, который переводит значение угла положения в соответствующее значение напряжения, он задан в виде такого же коэффициента k_(лог2) =k_(лог1) = 3.3/60 В/(°) .

Усилитель мощности представлен коэффициентом усиления k_(ум) =(Un)/(3,3)=12/(3,3) – переводит напряжение микроконтроллера в номинальное напряжение двигателя.

J = J_р +J_(ред) – общий момент инерции, приведенный к валу двигателя, состоящий из: момента инерции ротора двигателя – J_р , момента инерции редуктора, приведенного к валу двигателя – J_(ред) .

Так как управляемую координату мы тоже отсчитываем в градусах, то также необходим блок rad2deg, который переводит радианы в градусы k_(р-г) =180/π .

Составим передаточную функцию привода на основании приведенной выше математической модели:

=g∙k_(лог1) -x∙k_(лог2) =k_(лог1) ∙(g-x) ; (103)

u_(дв) = ∙k_(ум) =(g-x)∙k_(лог1) ∙k_(ум) ; (104)

u_1 =u_(дв) -k_ω ∙ =(g-x)∙k_(лог1) ∙k_(ум) -k_ω ∙ ; (105)

I= (1/R)/(T_e ∙s+1)∙u_1 =((g-x)∙k_(лог1) ∙k_(ум) -k_ω ∙)/(T_e ∙s+1)∙1/R ; (106)

M=I∙k_m =((g-x)∙k_(лог1) ∙k_(ум) -k_ω ∙)/(T_e ∙s+1)∙(k_m)/R ; (107)

=M/J=((g-x)∙k_(лог1) ∙k_(ум) -k_ω ∙)/(T_e ∙s+1)∙(k_m)/(R∙J) ; (108)

=∙1/s=((g-x)∙k_(лог1) ∙k_(ум) -k_ω ∙)/((T_e ∙s+1)∙s)∙(k_m)/(R∙J)= ((g-x)∙k_(лог1) ∙k_(ум) k_m)/((T_e ∙s+1)∙s∙R∙J + k_ω ∙k_m) ; (109)

=∙1/s=((g-x)∙k_(лог1) ∙k_(ум) k_m)/(((T_e ∙s+1)∙s∙R∙J + k_ω ∙k_m )∙s) ; (110)

x=∙k_(р-г) =((g-x)∙k_(лог1) ∙k_(ум) k_m ∙k_(р-г))/(((T_e ∙s+1)∙s∙R∙J + k_ω ∙k_m )∙s) ; (111)

Решив систему уравнений, получим передаточную функцию привода:

W(s)=K/(s∙(A_1 ∙s^2 +A_2 ∙s+1)) , где (112)

K=(k_(лог1) k_(ум) k_(р-г))/(k_ω) (113)

A_1 =(J ∙R∙T_e)/(k_ω ∙k_m) (114)

A_2 =(J ∙R)/(k_ω ∙k_m) (115)

Промоделируем работу данной системы. В качестве задающего воздействия подается угол 60 ° в соответствии с данными из конструкторской части. Графики изменения выходной величины – угла отклонения и угловой скорости – приведены на рис. 7.

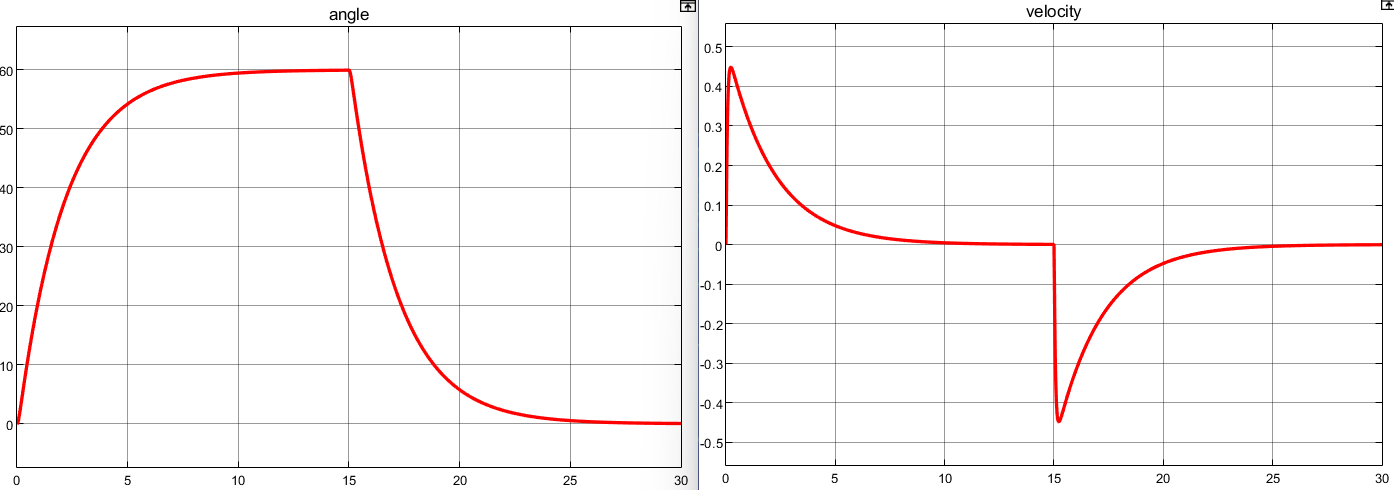
[picture p26: figure]

Рис. 7. Графики изменения угла отклонения и угловой скорости без коррекции линейной системы.

На данном графике видно, что система без коррекции не может обеспечить время срабатывания, указанное в техническом задании, для захвата требуемого объекта.

График ошибки линейной системы без коррекции представлен на рис. 8.

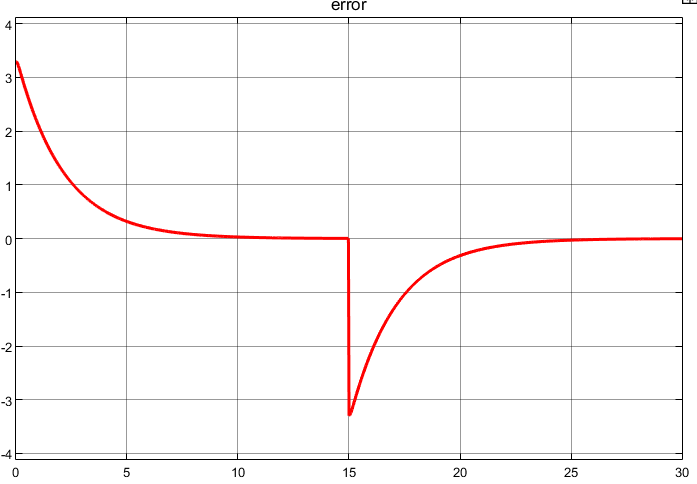
[picture p27: figure]

Рис. 8. График ошибки линейной системы без коррекции.

График переходного процесса приведен на рис. 9.

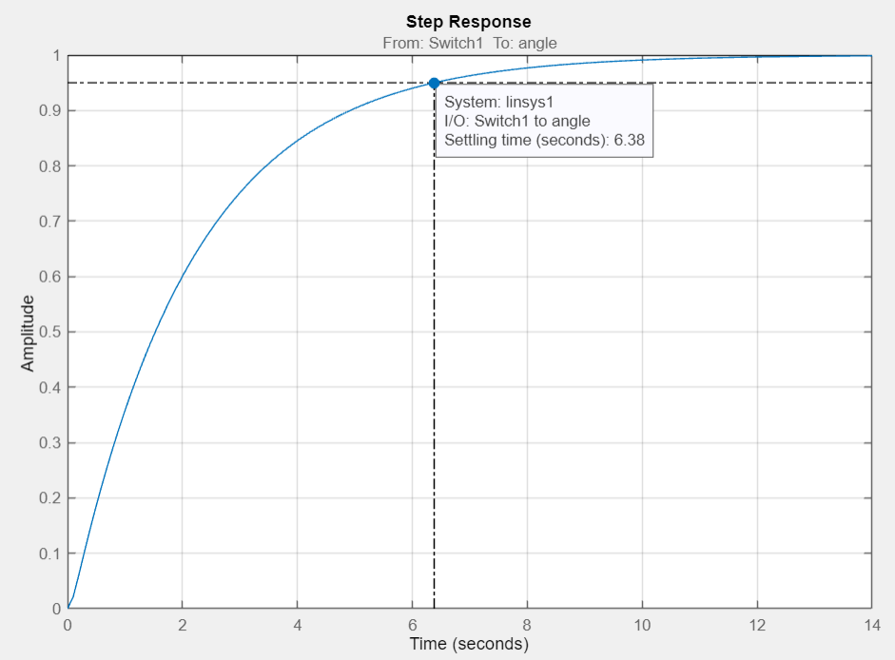
[picture p28: figure]

Рис. 9. График переходного процесса для привода схвата.

По рис. 10 видим, что перерегулирование σ=0% , а время переходного процесса t_(пп) =6,38 с .

Также приведем частотные характеристики модели (ЛАФЧХ) на рис. 10:

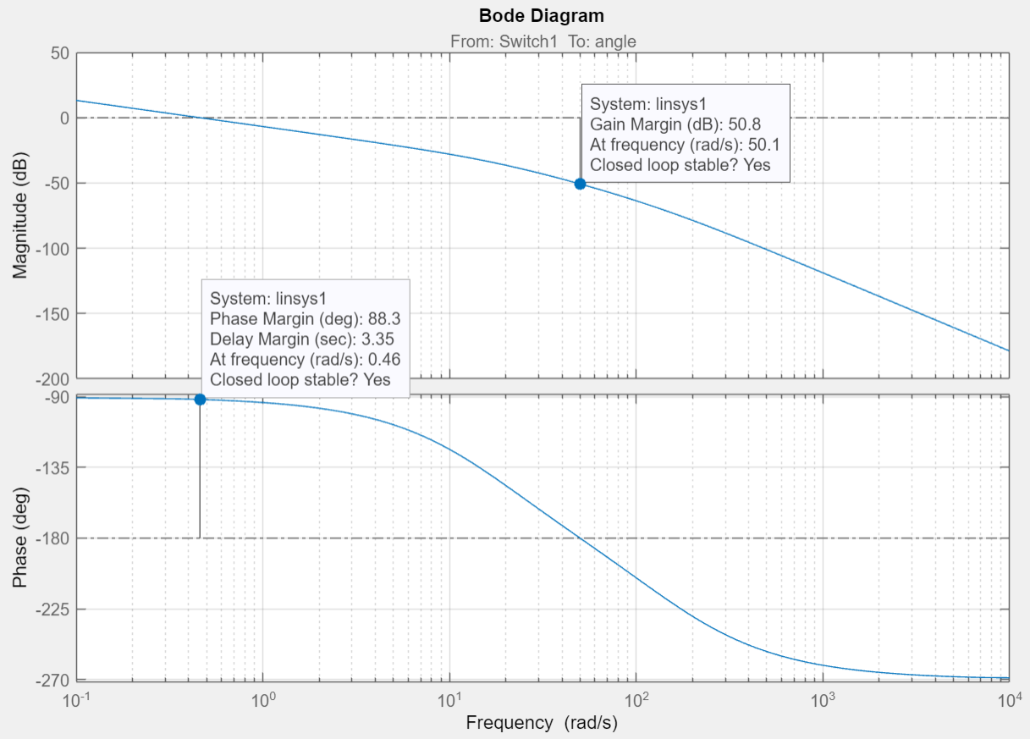
[picture p29: figure]

Рис. 10. Частотные характеристики линейной нескорректированной модели.

По логарифмическим частотным характеристикам определяем запас по амплитуде и фазе. Запас по амплитуде ∆A=50,8 дБ , а запас по фазе ∆φ=88,3° .

Данная система не удовлетворяет заданным в техническом задании требованиям. Следовательно, для достижения необходимых результатов нужно ввести корректирующее устройство. В качестве коррекции выберем ПИ-регулятор.

### 1.3.2. Коррекция линейной модели привода

Составим линейную математическую модель привода схвата манипулятора с учетом коррекции, приведенную на рис. 11.

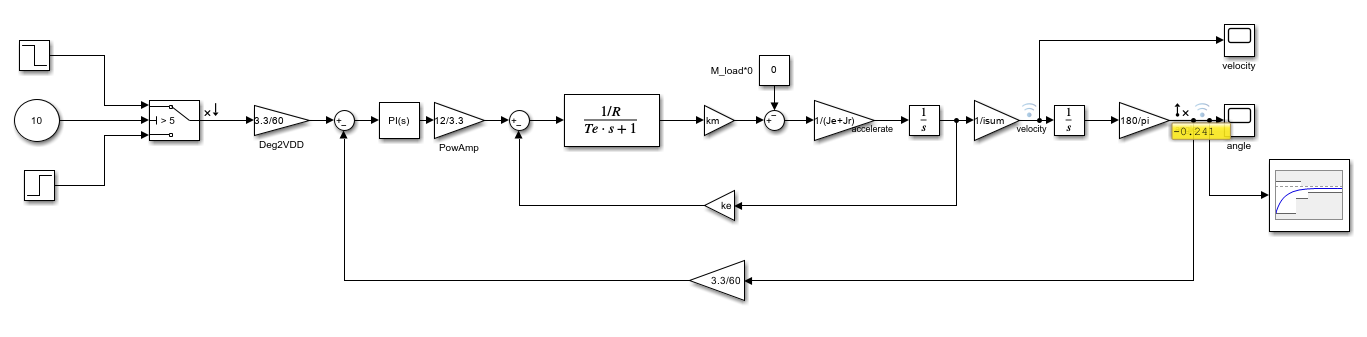
[picture p30: figure]

Рис. 11. Линейная математическая модель привода схвата с коррекцией.

Передаточная функция выбранного ПИ-регулятора выглядит следующим образом:

W_к (s)=k_(p1) +(k_(i1))/s=(k_(p1) ∙s+k_(i1))/s (116)

, где k_(p1) – коэффициент усиления пропорциональной составляющей;

k_(i1) – коэффициент усиления интегральной составляющей.

Для задания желаемых параметров используем блок Check Step Response Characteristics. В результате проведения синтеза данной системы в ПО Simulink получим следующие значения коэффициентов усиления выбранного регулятора:

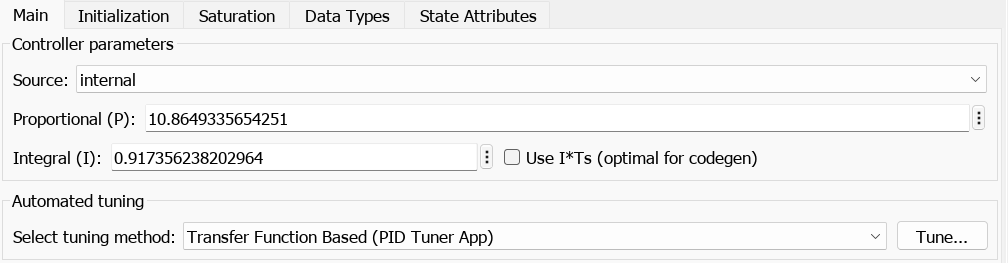
[picture p31: figure]

Рис. 12. Коэффициенты ПИ-регулятора.

k_p =10,865 (117)

k_i =0,917 (118)

Промоделируем работу скорректированной системы. Графики изменения выходной величины – угла отклонения и угловой скорости – приведена на рис. 13.

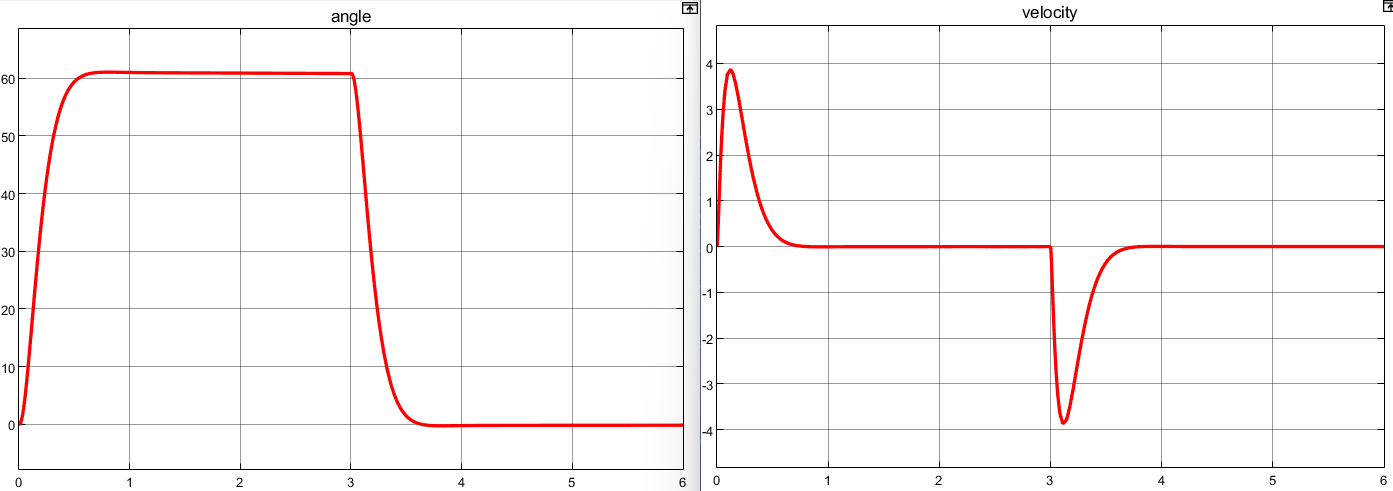
[picture p32: figure]

Рис. 13. Графики изменения угла отклонения и угловой скорости с коррекцией линейной системы.

График ошибки линейной системы с коррекцией представлен на рис. 14.

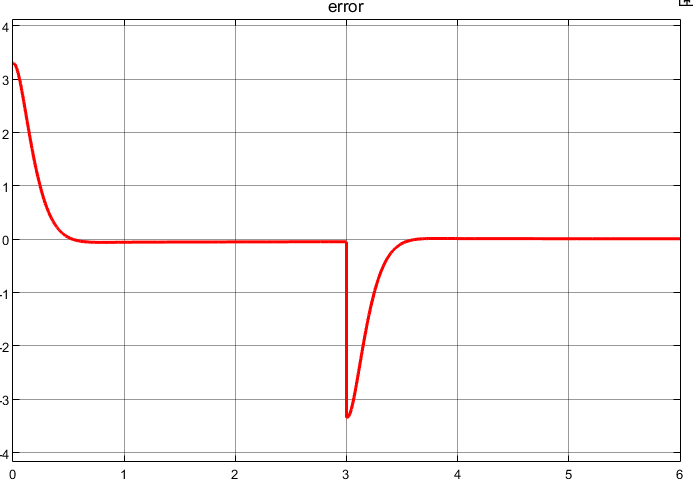
[picture p33: figure]

Рис. 14. График ошибки линейной системы с коррекцией.

График переходного процесса для линейной системы с коррекцией приведен на рис. 15.

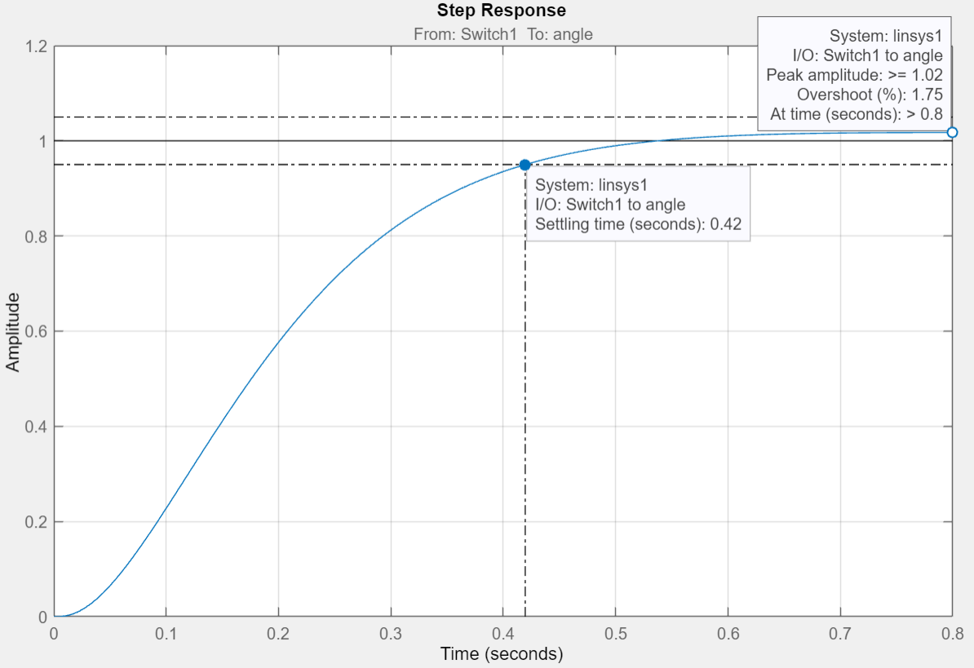
[picture p34: figure]

Рис. 15. График переходного процесса для привода схвата.

По рис. 6 видим, что перерегулирование σ=2% , а время переходного процесса t_(пп) =0,42 с .

В соответствии с данными графиками была получена система, полностью удовлетворяющая требованиям технического задания: значение установившейся ошибки не превышает 10% (2% < 10%), при этом время переходного процесса составляет 0,42 с.

Также приведем частотные характеристики модели (ЛАФЧХ) с коррекцией на рис. 16:

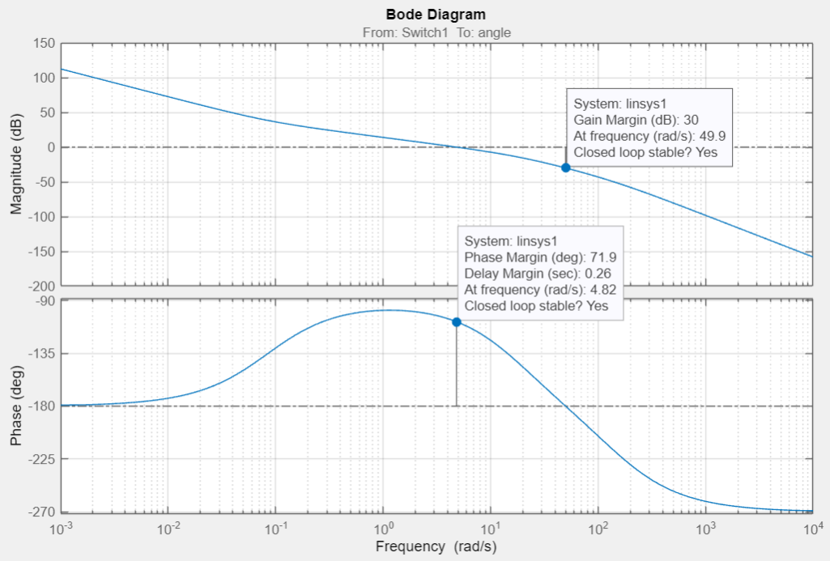
[picture p35: figure]

Рис.16. Частотные характеристики линейной скорректированной модели.

По логарифмическим частотным характеристикам определяем запас по амплитуде и фазе. Запас по амплитуде ∆A=30 дБ , а запас по фазе ∆φ=71,9° .

Далее проверим работу системы с учетом возникающих в процессе работы нелинейностей.

### 1.3.3. Нелинейная модель привода

Составим нелинейную математическую модель привода схвата манипулятора с учетом коррекции и нелинейностей, приведенную на рис. 17:

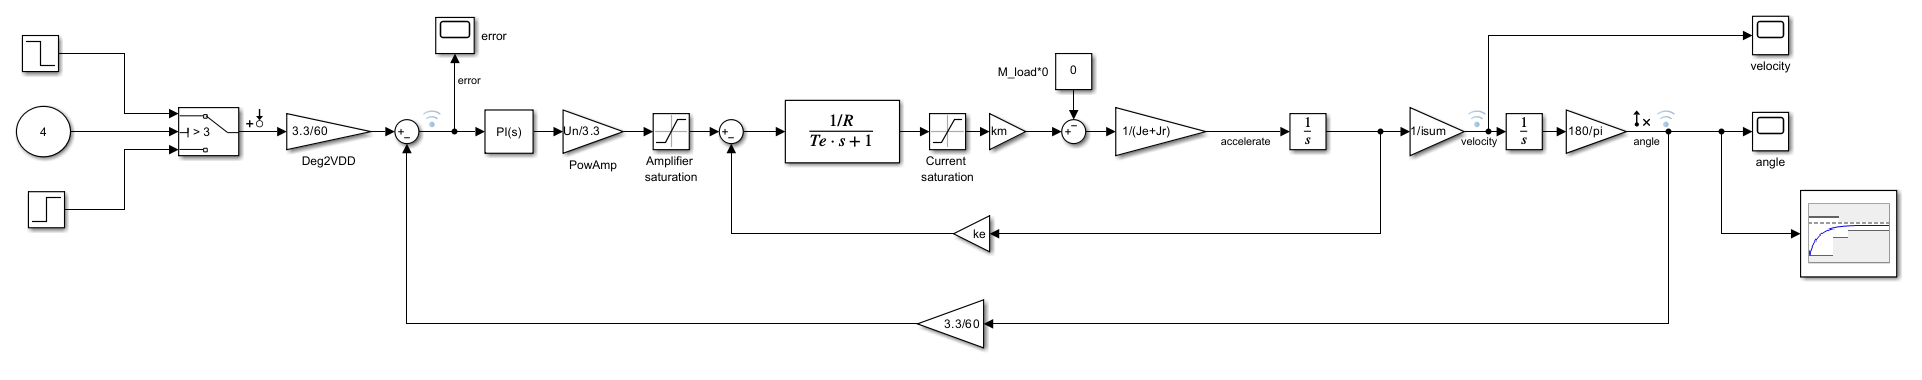
[picture p36: figure]

Рис. 17. Нелинейная математическая модель привода схвата с коррекцией.

Основными нелинейностями, возникающими в процессе работы, являются:

- насыщение усилителя мощности, на схеме данная нелинейность описывается блоком Saturation, ее максимальное по модулю значение равно номинальному напряжению питания двигателя 12 В;
- насыщение тока в обмотках двигателя, на схеме данная нелинейность описывается блоком Saturation, ее максимальное по модулю значение равно максимально допустимому току в обмотках 1,2 А.

Промоделируем работу данной системы. Графики изменения выходной величины – угла отклонения и угловой скорости – приведены на рис. 18.

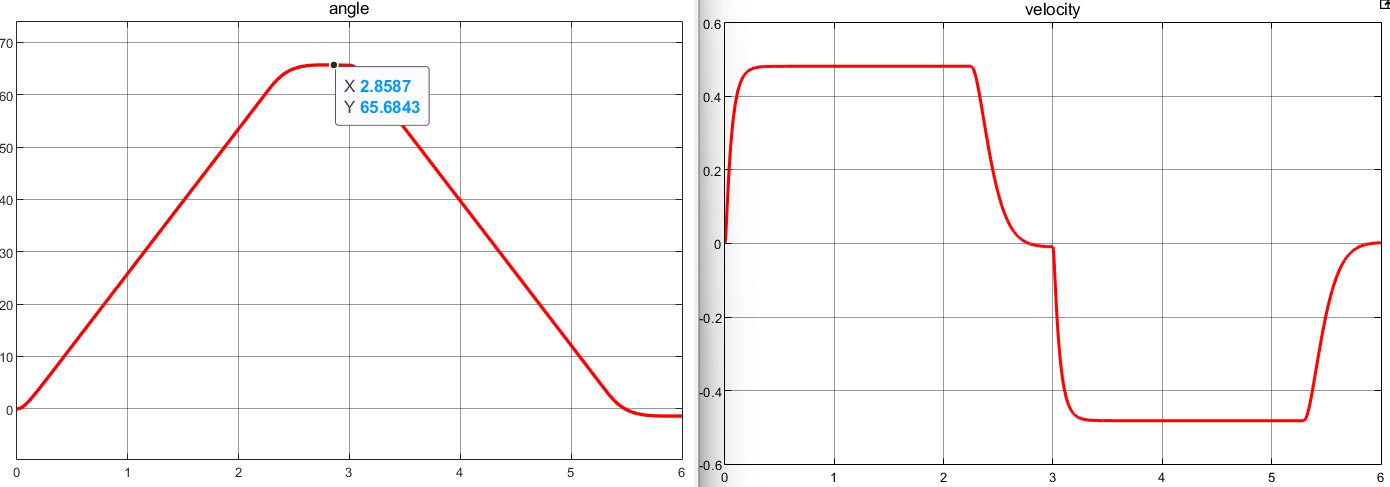
[picture p37: figure]

Рис. 18. Графики изменения угла отклонения и угловой скорости с коррекцией нелинейной системы.

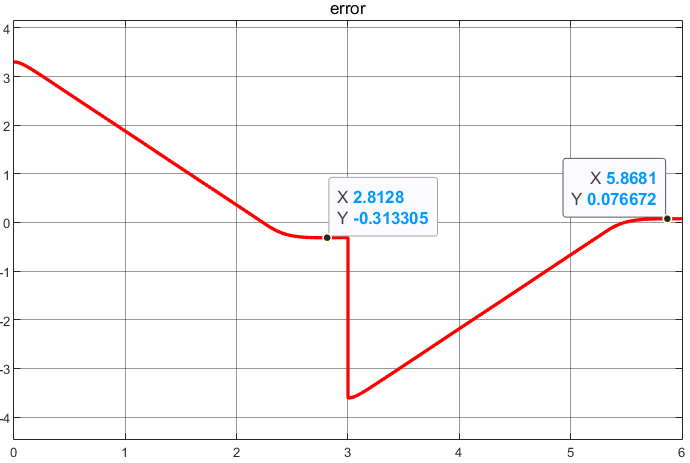
[picture p38: figure]

Рис. 19. График ошибки нелинейной системы с коррекцией.

В соответствии с данными графиками была получена нелинейная система, полностью удовлетворяющая требованиям технического задания: значение установившейся ошибки не превышает 10% (9,46% < 10%), при это время переходного процесса составляет 2,5 с.

Логично предположить, что в дальнейшем может появиться идея подключить датчик усилия. Смоделируем работу системы в таком случае с удержанием объекта. Для этого внесем изменения в нелинейную модель, добавив следующую логику. Предположим, что привод обхватывает предмет, то есть пальцы разгибаются не полностью, а лишь наполовину (на 30 ° ). При контакте он фиксирует свое положение, а для удержания предмета требуется статическая сила 10 Н. Для реализации данной логики в модель добавляются: ключ на входе, сумматор для расчета угла возврата и реле для фиксации нового положения. Схема представлена на рис. 20.

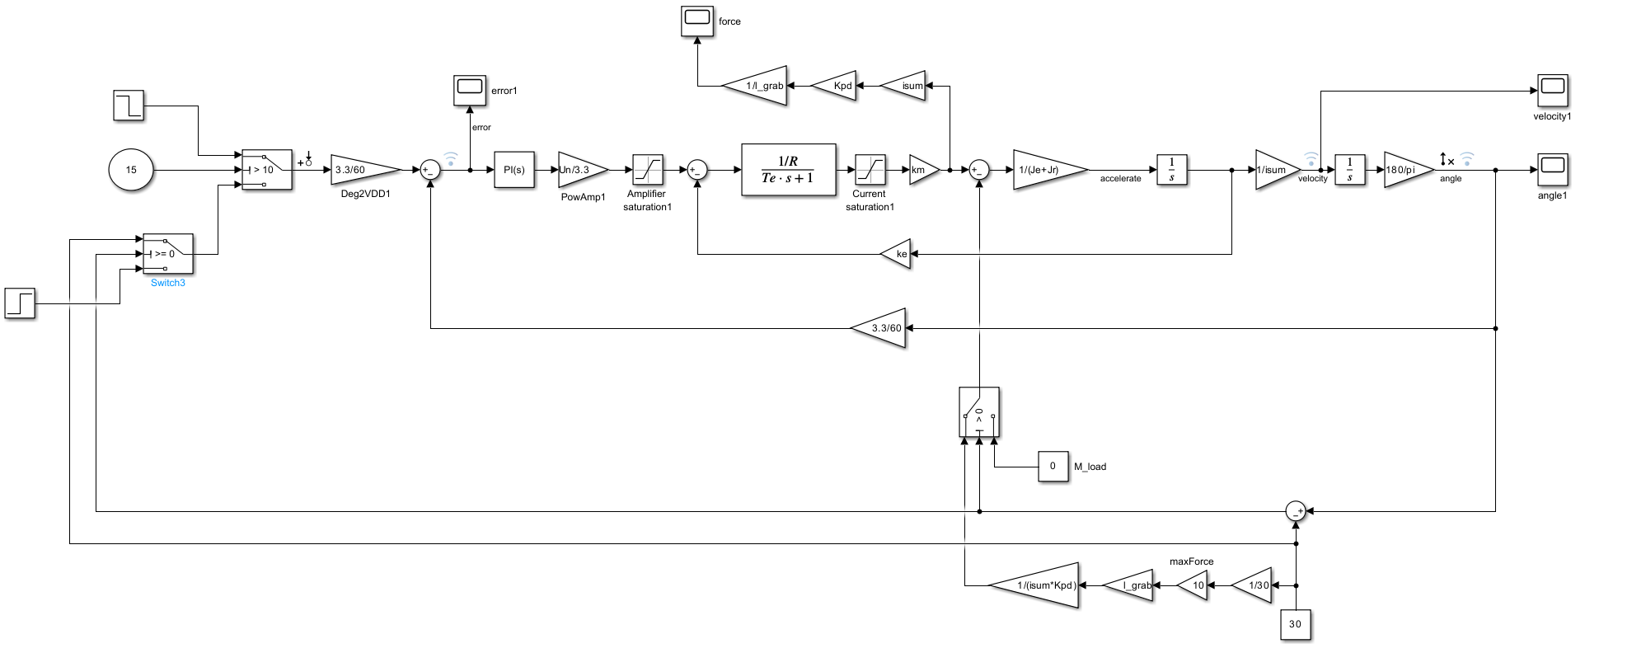
[picture p39: figure]

Рис. 20. Нелинейная математическая модель дополнительной логикой работы.

Графики изменения угла отклонения и угловой скорости приведены на рис. 21 ниже.

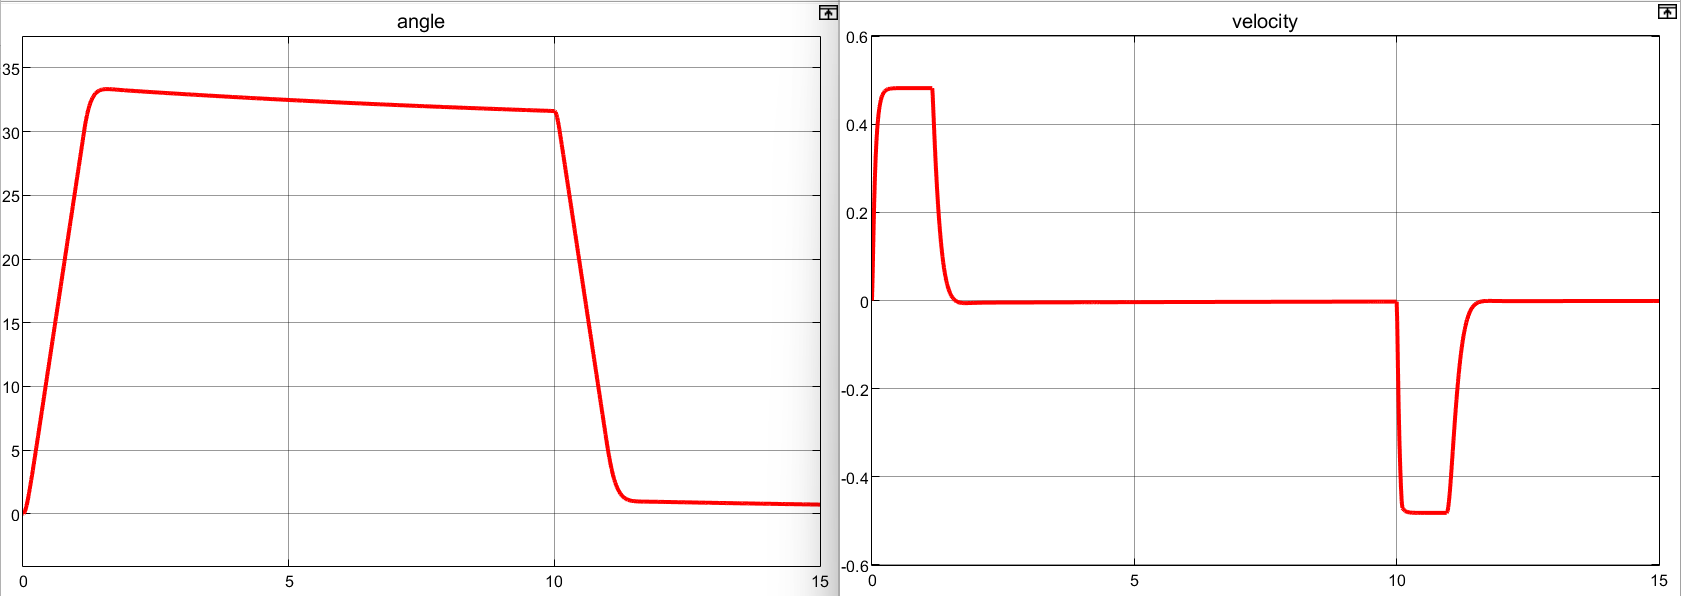
[picture p40: figure]

Рис. 21. Графики изменения угла отклонения и угловой скорости при захвате.

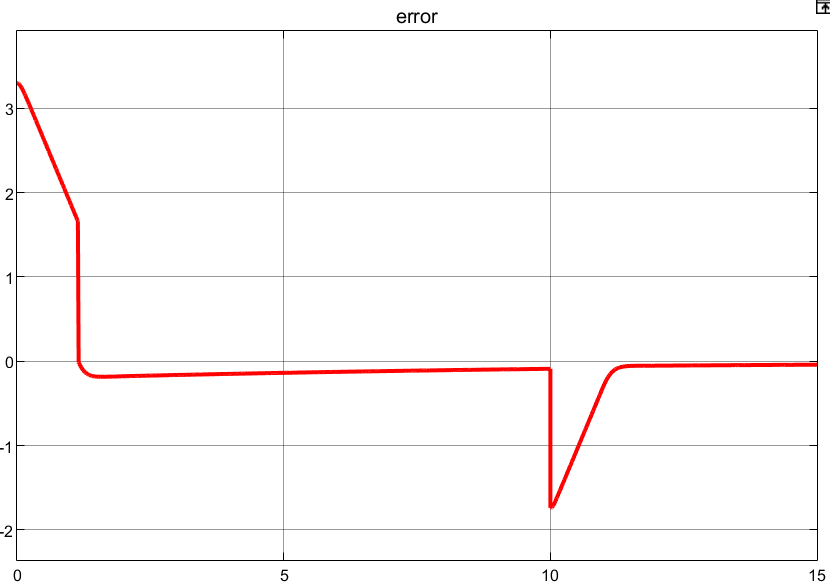
[picture p41: figure]

Рис. 22. График ошибки нелинейной системы при захвате.

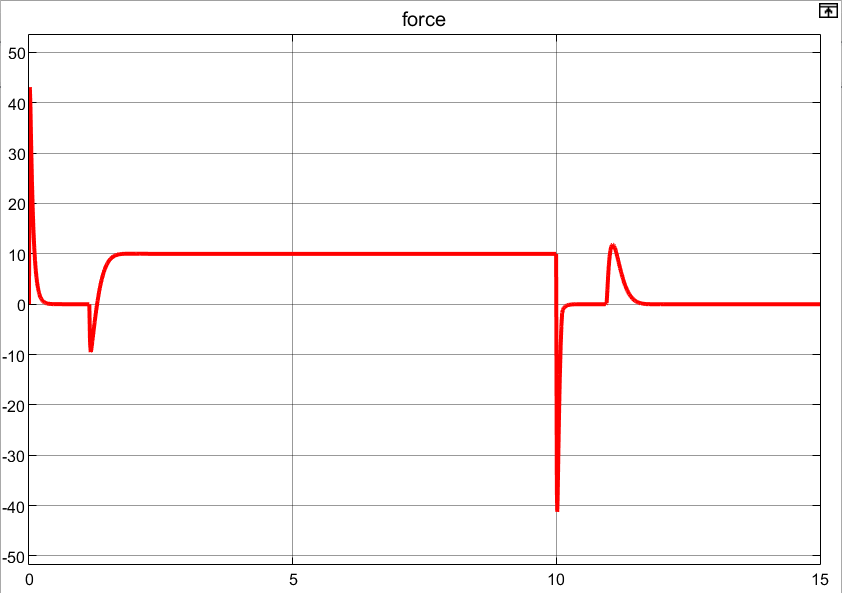
[picture p42: figure]

Рис. 23. График изменения усилия при захвате.

По графикам наблюдаем, что привод достигает объекта, остается в данном положении и сохраняет постоянным прикладываемую силу на протяжении всего заданного времени. Таким образом обеспечивается захват и удержание предметов в работе лабораторного манипулятора. При этом прикладываемое усилие не превышает 10 Н, как было сформулировано в техническом задании.

### 1.3.4. Дискретная модель привода

Последним этапом является проверка функционирования системы при учете наличия дискретности работы микроконтроллера. Для контура период дискретизации зависит от параметра аналого-цифрового преобразователя, который является частью микроконтроллера. Для микроконтроллеров STM32 любой серии среднее значение длительности преобразования составляет 1 мкс. Однако данный преобразователь не является достаточно точным, и для повышения точности работы необходимо вычислять среднее значение из нескольких полученных результатов. В контуре обратной связи по положению опрос значения датчика будет производиться с частотой 2000(раз)/с . В соответствии с данным условием примем период дискретизации в данном контуре равным 5∙10^(-4) с.

Составим математическую модель привода схвата манипулятора с учетом дискретного блока Zero-Order Hold, установленного в цепи обратной связи по углу, и описывающий дискретность работы микропроцессора, приведенную на рис. 24.

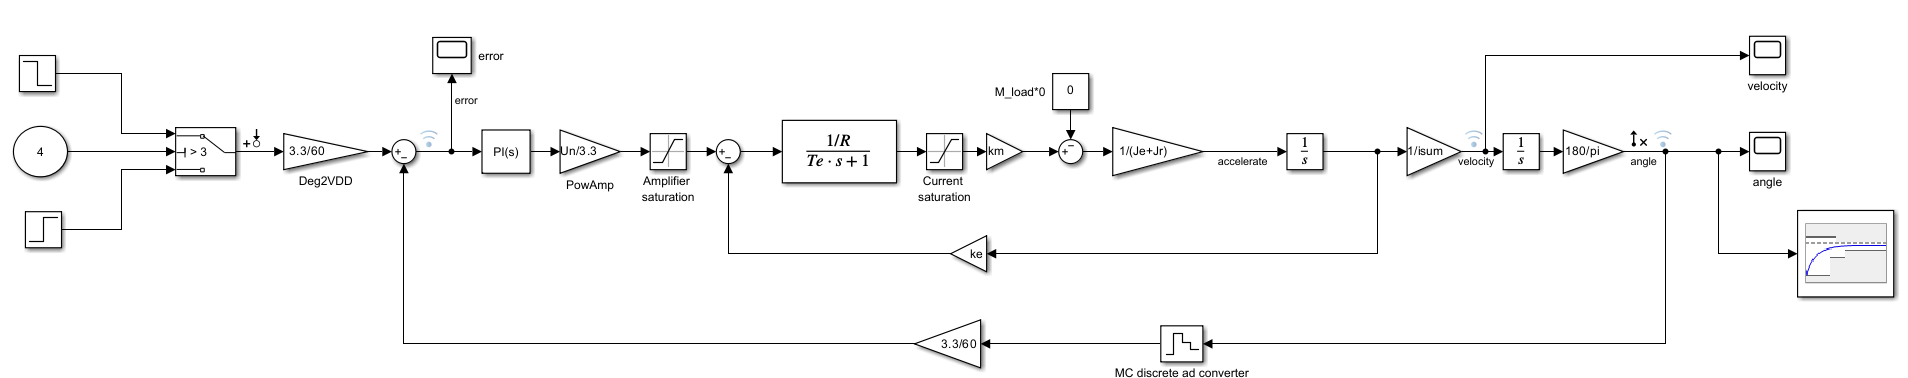
[picture p43: figure]

Рис. 24. Дискретная математическая модель привода схвата с коррекцией.

Составим передаточную функцию корректирующего устройства:

W_(ПИ) (z)=k_(pz) +(Tk_(iz))/(z-1)=(k_(pz) z+(Tk_(iz) -k_(pz) ))/(z-1) (119)

, где k_(pz) – коэффициент усиления пропорциональной составляющей;

k_(iz) – коэффициент усиления интегральной составляющей;

Составим разностное уравнение для реализации корректирующего устройства в микроконтроллере:

(k_(pz) z+(Tk_(iz) -k_(pz) ))/(z-1)=(X^(*) (z))/(G^(*) (z)) (120)

, где X^(*) (z) – изображение сигнала на выходе с корректирующего устройства;

G^(*) (z) – изображение сигнала на входе в корректирующего устройства.

Преобразуем данные уравнения следующим образом:

X^(*) (z)∙(z-1)=G^(*) (z)∙[k_(pz) z+(Tk_(iz) -k_(pz) )] (121)

Запишем данное уравнение в следующем виде:

x[n+1]-x[n]=k_(pz) ⨯g[n+1]+(Tk_(iz) -k_(pz) )∙g[n] (122)

Промоделируем работу данной системы. Графики изменения выходной величины – угла отклонения и угловой скорости приведены на рис. 25.

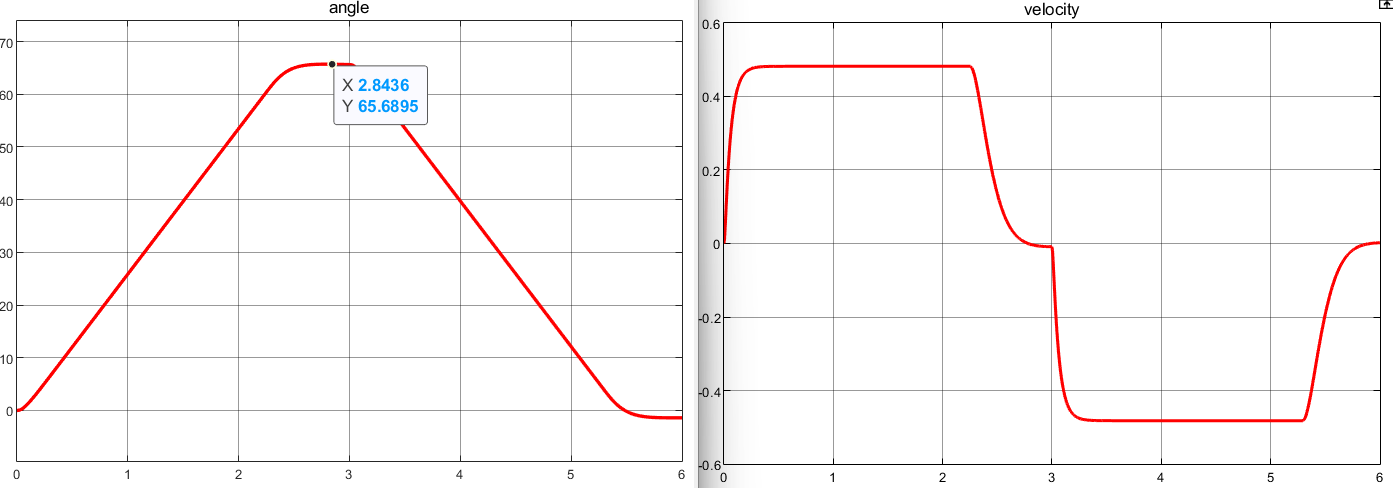
[picture p44: figure]

Рис. 25. Графики изменения угла отклонения и угловой скорости с коррекцией дискретной системы.

График ошибки линейной системы с коррекцией представлен на рис. 26.

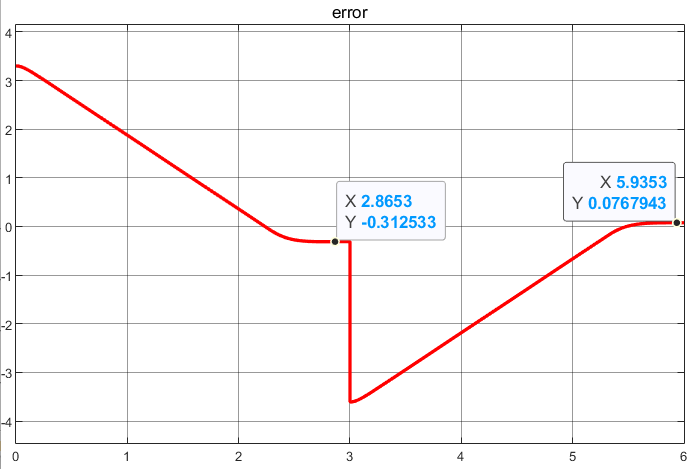
[picture p45: figure]

Рис. 26. График ошибки дискретной системы с коррекцией.

В соответствии с данными графиками была получена дискретная система, полностью удовлетворяющая требованиям технического задания: значение не превышает 10% (9,46% < 10%), время переходного процесса не превышает 3 с (2,5 с < 3 с).

# Техническое задание для системы управления

Наименование проекта: Разработка лабораторного стенда-манипулятора

Исполнитель: Соловцов М.А.

Дата: 25.02.2025

Требования к системе

Система должна включать:

1. Плату управления приводом, обеспечивающую:

- Управление двигателем постоянного тока (DC);

- Обратные связи по:

- угловому положению звена;

- Возможность программирования микроконтроллера;

- Интерфейс связи: USB, UART или USART.

2. Плату датчика углового положения с возможностью интеграции в систему.

Функциональные требования

1. Управление двигателями

- Необходимо выбрать подходящий способ управления (ШИМ или аналоговый сигнал).

- Должна быть предусмотрена схема управления на основе драйвера двигателя.

2. Контроль углового положения звена

- Датчик углового положения должен обеспечивать точное определение текущего угла.

3. Обеспечение безопасности

- Реализация защиты от перегрузок и перегрева двигателя.

4. Энергоснабжение

- Разработка преобразователей напряжения для питания узлов схемы.

Выбор компонентов системы

Для реализации системы необходимо подобрать следующие комплектующие:

1. Микроконтроллер

- Требуется выбрать микроконтроллер с достаточным количеством GPIO, АЦП и интерфейсами (USART, I2C, SPI) для подключения периферии (например, STM32, ESP32 или аналог).

2. Схема управления двигателями

- Драйвер, поддерживающий токи и напряжение, соответствующие характеристикам двигателя JGA25-370 [Приложение Б] (например, L298N, DRV8833 или TB6612FNG).

3. Датчик углового положения

- Потенциометрический, магнитный или оптический энкодер (например, AS5600 (магнитный энкодер), потенциометр ALPS или аналог).

4. Преобразователи напряжения

- Регуляторы для питания микроконтроллера и периферии (например, AMS1117 или LM2596).

Этапы разработки

1. Электрическая схема

- Разработать принципиальные схему для платы управления.

- Рассчитать необходимые параметры для элементов схемы.

2. Печатная плата (PCB)

- Разработать печатную плату, обеспечивающую по возможности минимальные размеры и удобство сборки.

3. Документация.

- Предоставить комплект документации для производства.

# 2. Проектирование плат системы управления привода захватного устройства

## 2.1 Проектирование платы управления

Для управления двигателем постоянного тока и обеспечения режимов реверса и торможения выбрана схема полного H-моста, выполненная на транзисторных ключах (приведена на рис. 27). пропускать ток через нагрузку в прямом и обратном направлении. Если в эту цепь подключить DC-мотор, то он будет крутиться либо по часовой стрелке (СW) либо против часовой стрелки (CCW), а также динамическое торможение и торможение противовключением.


Рис. 27. Схема полного H-моста

Для обеспечения надежной работы ключей используются защитные диоды, которые предотвращают повреждение транзисторов при возникновении ЭДС самоиндукции в обмотке двигателя. Диоды VD1-VD4 включены в обратном направлении, чтобы обеспечить путь для тока индуктивности при выключении транзисторов.

Преимущества полевых транзисторов с изолированным затвором

Для реализации схемы выбраны n-канальные MOSFET транзисторы. Это обусловлено их рядом преимуществ по сравнению с биполярными транзисторами:

- Отсутствие неосновных носителей позволяет MOSFET транзисторам работать быстрее.
- При нагревании сопротивление открытого канала увеличивается, что ограничивает ток и снижает риск повреждения.
- Благодаря высокому входному сопротивлению требуется минимальный ток для управления.
- n-канальные транзисторы обладают меньшим сопротивлением открытого канала и большей стабильностью параметров при работе на высоких частотах.

Однако для управления верхними n-канальными транзисторами требуется напряжение, превышающее напряжение источника питания двигателя. Для решения этой задачи используется схема самоподкачки верхнего ключа.

Управление с использованием ШИМ

Работа двигателя будет управляться с использованием широтно-импульсной модуляции (ШИМ). Этот метод предполагает чередование состояний транзисторов между полностью открытым и полностью закрытым положениями. Среднее напряжение, подаваемое на двигатель, пропорционально коэффициенту заполнения ШИМ.

Рассчитаем частоту ШИМ:

1) T_(пп) ≪T_(ШИМ) -условие управляемости системы
2) Пульсации тока:

ΔI=T_(ШИМ) ⋅((dI)/(dt))_(max) =T_(ШИМ) ⋅(U_(пит.дв))/L≪I_(ном) (123)

T_(ШИМ) ≪(L⋅I_(ном))/(U_(пит.дв))=(0,175⋅1,2)/12=0,0175 с.=17,5 мс. (124)

f_(ШИМ) ≫1/(0,0175)=57,14 Гц (125)

3) T_(ШИМ) < T_э =6,3 мс. (126)

Примем f_(ШИМ) =20 кГц, T_(ШИМ) =50 мкс .

Элементы схемы управления

Для реализации схемы полного H-моста и управления двигателем необходимо выбрать следующие элементы:

1. N-канальные полевые транзисторы с изолированным затвором.
2. Схему самоподкачки для верхнего ключа.
3. Драйверы для управления транзисторными ключами.
4. Схемы включения.

### 2.1.1 Выбор полевых транзисторов

Для управления двигателем постоянного тока с использованием схемы полного H-моста транзисторы должны работать в ключевом режиме. В данном режиме транзисторы находятся только в двух состояниях — полностью открыты или полностью закрыты, что минимизирует выделение тепловой мощности и продлевает срок службы компонентов.

Основные требования к транзисторам

1. Напряжение сток-исток ( U_(DS) ):

Транзисторы должны выдерживать напряжение, равное удвоенному напряжению питания двигателя. Для нашего случая U_(DS) должно быть не менее 24 В.

2. Тепловой режим:

При работе в ключевом режиме выделяемая мощность должна быть меньше максимальной рассеиваемой мощности транзистора, что обеспечивает нормальный тепловой режим работы.

Требования к параллельным защитным диодам

1. Время обратного восстановления ( t_(rr) ):

Должно быть меньше времени включения транзистора ( t_r ).

2. Максимальный ток:

Диод должен выдерживать максимальный ток. Из технической документации двигателя выяснили, что он достигается в заблокированном состоянии и составляет I_(max) =1,2 А .

Выбор транзистора

На основе вышеперечисленных требований был выбран транзистор IRF100B202 фирмы «International IOR Rectifier». Основные технические характеристики транзистора:

- U_(DS)^(max) =100 В ;
- Сопротивление открытого канала R_(DS)^(on) =7,2 мОм ;
- Тепловое сопротивление кристалл-воздух R_(JA)^ti =62(°C)/(Вт) ;
- Заряд затвора Q_g =77 нК ;
- Время включения и выключения t_r = 56 нс,t_f =58 нс .

Транзистор также содержит паразитный параллельный диод, который может быть использован в качестве ограничительного, если он соответствует следующим параметрам:

- Время обратного восстановления t_(rr) = 51 нс ;
- Максимальный ток диода I_S =97 А ;
- Импульсный ток I_(SM) =380 А ;
- Падение напряжения на диоде U_(SD) =1,3 В .

Тепловой расчет

Для обеспечения нормального теплового режима необходимо убедиться, что выделяемая мощность транзистора при номинальном токе двигателя меньше максимальной рассеиваемой мощности.

Максимальная рассеиваемая мощность:

P_D^(max) = (T_j^(max) - T_A)/(R_(JA)^ti) (127)

Где:

- T_j^(max) =175℃ — максимально допустимая температура кристалла;
- T_A =25℃ — температура окружающей среды;

Подставляя значения:

P_D^(max) = (125- 25)/62=1,61 Вт (128)

Мощность, выделяемая на транзисторе:

P_D = I_(max)^2 ∙ R_(DS(on)) (129)

Где:

- I_(max) =1,2 А — максимальный ток двигателя (в блокировке);

Подставляя значения:

P_D =1,2^2 ∙7,2∙10^(-3) ≈0,0104 Вт (130)

Так как P_D <P_D^(max) , транзистор работает в нормальном тепловом режиме.

Проверка параметров параллельного диода

Для использования паразитного диода в качестве ограничительного в схеме полного H-моста проверим следующие условия:

1. U_(DS) <U_(DS)^(max) ⇒ 24 В<100 В . Условие выполнено.
2. t_(rr) <t_r ⇒ 51 нс<56 нс . Условие выполнено.
3. I_(max) <I_S ⇒ 1,2 А<97 А . Условие выполнено.

Так что транзистор IRF100B202 удовлетворяет всем техническим требованиям для работы в схеме полного H-моста. Паразитный диод может быть использован в качестве ограничительного, что упрощает конструкцию схемы. На рисунке ниже указано условное графическое обозначение (УГО) этого транзистора.


Рис. 28. УГО транзистора IRF100B202

### 2.1.2 Выбор драйвера и схемы самоподкачки

Для управления транзисторами в схеме полного H-моста используется драйвер, который обеспечивает открытие и закрытие ключей в зависимости от поступающего сигнала ШИМ. Одним из наиболее распространенных решений для этой цели является драйвер полумоста IR2104. Применение двух таких микросхем позволяет реализовать управление полным H-мостом.


Рис. 29. УГО драйвера IR2104

Принцип работы драйвера IR2104

Драйвер IR2104 обеспечивает управление верхним и нижним транзисторами полумоста следующим образом:

- При поступлении логической единицы на вход «IN» верхний транзистор открывается, а нижний закрывается.
- При поступлении логического нуля — верхний транзистор закрывается, а нижний открывается.
- Если сигнал на входе « SD » становится равным логическому нулю, оба выхода («HO» и «LO») переходят в высокоомное состояние, выключая выходы микросхемы.

Основные параметры драйвера IR2104

Характеристики и назначение выводов микросхемы представлены в таблице 4 (Приложение Б) [14]. Среди ключевых параметров:

- Напряжение питания V_(CC) = 12 В.
- Логические уровни управления: совместимы с типовыми уровнями сигналов ШИМ.
- Быстродействие: позволяет управлять транзисторами в широком диапазоне частот.

Особенности подключения драйвера

На рис. 30 представлена схема включения драйвера IR2104 из технической документации [14].


Рис. 30. Схема обвязки драйвера IR2104

Эта схема включает:

1. Конденсатор подкачки, обеспечивающий питание для управления верхним ключом.
2. Диод в цепи вторичного источника питания, который:
  - Заряжает конденсатор при открытии нижнего ключа.
  - Предотвращает разряд конденсатора при закрытии нижнего ключа.

Выбор компонентов для схемы подкачки верхнего ключа

Схема включения драйвера и элементы обвязки приведены на рисунке 2. Основные элементы для реализации схемы включения драйвера включают диод, конденсатор подкачки и затворные резисторы. Выбор каждого компонента будет обоснован ниже.

1. Диод

Диод в цепи питания обеспечивает зарядку конденсатора подкачки при открытии нижнего ключа и препятствует его разрядке при закрытии. Основные требования к диоду:

  - Время обратного восстановления t_(rr) ≤ 50 нс ;
  - Напряжение пробоя диода U_(rpm) > V_(CC) , где V_(CC) =12 В .

Этим требованиям удовлетворяет диод Шоттки SK34 со следующими характеристиками:

- t_(rr) =10 нс ;
- U_(rpm) =40В .

Таким образом, диод SK34 подходит для данной схемы.

2. Конденсатор подкачки

Для корректной работы верхнего ключа конденсатор подкачки должен обеспечивать достаточный заряд для открытия транзистора. Минимальная ёмкость конденсатора рассчитывается по формуле:

C_b ≥(Q_g +(I_(qbs) +I_(ут))/(f_(ШИМ))+Q_(shift))/(V_(CC) -U_(д пр) -U_(DS)^(min)) (131)

где:

- Q_g =77 нКл — заряд затвора;
- U_(DS)^(min) =4 В — минимальное напряжение затвор-исток;
- V_(CC) =12 В — напряжение питания;
- U_(д пр) =0,5 В — прямое падение напряжения на диоде;
- Q_(shift) =5 нКл — заряд для поднятия уровня сигнала;
- I_(qbs) =30 мкА — ток питания драйвера;
- I_(ут) =0 A (при использовании керамического конденсатора);
- f_(ШИМ) =20 кГц — частота ШИМ.

Подставим значения:

C_b ≥(77∙10^(-9) +(30∙10^(-6))/(20∙10^3)+5∙10^(-9))/(12-0,5-4)≈11 нФ (132)

Для обеспечения запаса по ёмкости и исключения риска полной разрядки конденсатора примем значение C_b =1 мкФ .

Выберем керамический конденсатор GRM21BR71E105K фирмы «Murata» с ёмкостью 1 мкФ и напряжением пробоя 25 В. Этот же конденсатор используем в качестве шунтирующего в цепи питания драйвера.

3. Затворные резисторы

Затворные резисторы формируют RC-цепь с входной ёмкостью транзистора, влияя на скорость переключения. При слишком малом сопротивлении возможно появление шумов, а при слишком большом — увеличение времени переключения и рассеиваемой мощности. Типичное значение сопротивления составляет 10 Ом.

Выберем резистор RC0402JR-0710RL фирмы «Yageo» с номиналом 10 Ом.

4. Конденсаторы для фильтрации помех

Для фильтрации шумов в цепи питания используем два параллельных конденсатора:

  - Электролитический EEVFK1V102V фирмы «Panasonic» с ёмкостью 1000 мкФ и напряжением пробоя 35 В;
  - Керамический GRM21BR6YA106KE43L фирмы «Murata» с ёмкостью 10 мкФ и напряжением пробоя 35 В.

### 2.1.3 Выбор микроконтроллера

Основное устройство управления в разрабатываемой плате — микроконтроллер. Он должен выполнять следующие функции:

- Генерация сигналов управления.
- Обработка данных с датчика положения.
- Решение разностных уравнений для коррекции системы.

Требования к микроконтроллеру

Для обеспечения работы проектируемой системы микроконтроллер должен обладать следующими характеристиками:

1. Наличие не менее 16 выводов.
2. Поддержка как минимум одного аналогово-цифрового преобразователя (АЦП) для обработки данных с датчика тока.
3. Наличие интерфейса I2C или CAN для подключения периферийных устройств.
4. Интерфейсы USART, UART или SPI для связи с программатором и микроконтроллером верхнего уровня.
5. Линии для подключения программатора.
6. Доступность технической документации и примеров использования.

Выбор микроконтроллера

В соответствии с указанными требованиями был выбран микроконтроллер STM32F030K6T6 компании STMicroelectronics. Данный микроконтроллер соответствует всем перечисленным критериям и обладает следующими техническими параметрами:

- 32 выводных линии.
- Рабочее напряжение: от 2,4 до 3,6 В, среднее значение — 3,3 В.
- Максимальная частота процессора: 48 МГц.
- Наличие одного АЦП.
- Интерфейсы USART и I2C.
- Линии SWDIO и SWCLK для подключения программатора.
- Корпус: LQFP32.


Рис. 31. УГО микроконтроллера STM32F030K6T6

Особенности подключения микроконтроллера

Подключение микроконтроллера будет выполнено в соответствии с технической документацией [13].

Ключевые аспекты подключения:

1. Шунтирующие конденсаторы:
  - Используются керамические конденсаторы номиналом 10 мкФ (C2012A106K350NT, Hottech).
2. Резисторы:
  - Применяются резисторы RC0603FR-07430RL от Yageo с номиналом 430 Ом.
3. Выводы для программатора:
  - SWCLK (вывод 23) и SWDIO (вывод 24).
4. Интерфейсы связи:
  - USART_TX (вывод 8) и USART_RX (вывод 9) используются для подключения микроконтроллера верхнего уровня.
5. ШИМ-сигналы:
  - Линии PWM1 и PWM2 генерируют сигналы для управления драйверами транзисторных ключей.
6. Режим загрузки программы:
  - Вывод BOOT0 управляет выбором загрузки программы из памяти микроконтроллера.
7. Ключи сброса:
  - SW1 (тактовая кнопка KLS7-TS6601-7.0-180) позволяет перезапустить микроконтроллер при необходимости.
  - Подключение кнопки аварийного отключения манипулятора производится на 22 выводе микроконтроллера.

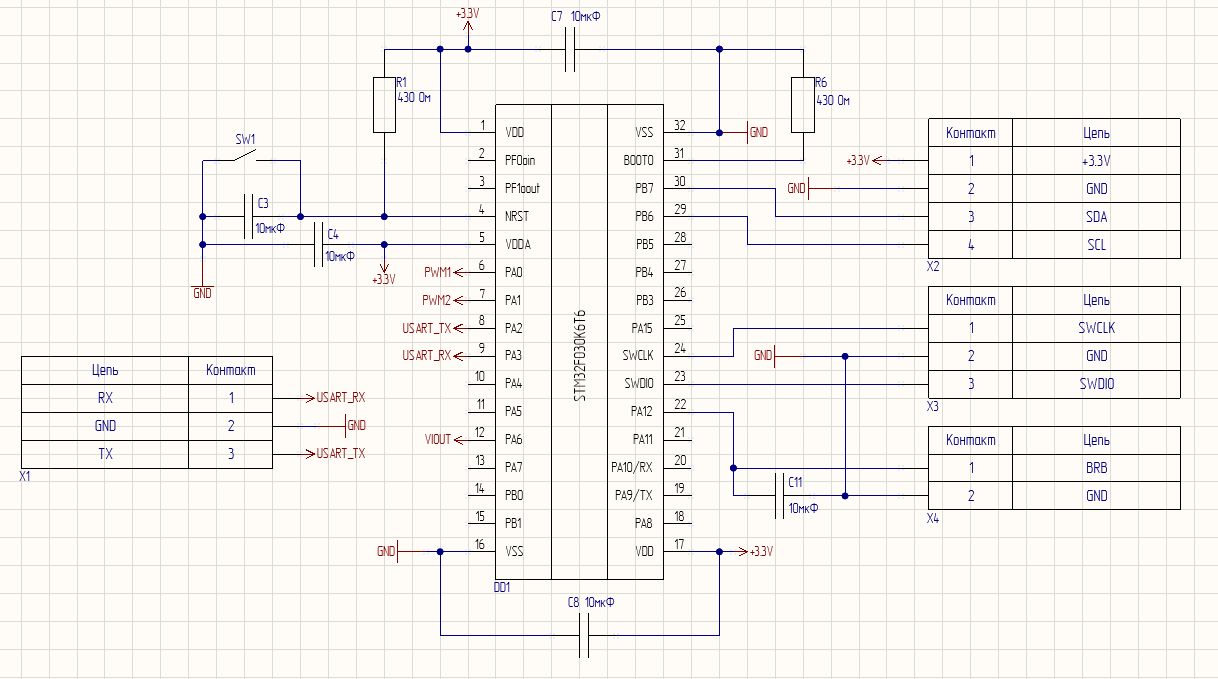
[picture p46: figure]

Рис. 32. Схема включения микроконтроллера STM32F030K6T6

### 2.1.4 Выбор преобразователей напряжения

Для питания компонентов системы потребуется организация каскадного преобразования напряжения с начального уровня 12 В. Оно же необходимо для питания исполнительного двигателя, однако для других компонентов требуется понижение до 3,3 В. Для реализации преобразования выберем импульсный понижающий преобразователь напряжения LM2596S.


Рис. 33. УГО микросхемы LM2596S

Схема его включения представлена на рис. 34. Назначение выводов микросхемы LM2596S приведено в таблице 5 (Приложение Б).


Рис. 34. Схема обвязки микросхемы LM2596S

Выбор компонентов

Преобразователь с 12 В на 3.3 В

  - Входной конденсатор: EEVFK1V102V фирмы Panasonic, ёмкость 1000 мкФ, напряжение пробоя 35 В.
  - Катушка индуктивности: MSS1278-104ML фирмы Coilcraft, индуктивность 100 мкГн.
  - Выходной конденсатор: EEEFK1C221P фирмы Panasonic, ёмкость 220 мкФ, напряжение пробоя 16 В.
  - Диод: Шоттки SK34.
  - Шунтирующий конденсатор: GRM21BR6YA106KE43L фирмы Murata, ёмкость 10 мкФ.

### 2.1.5 Разработка печатной платы управления

При разработке печатной платы управления необходимо учитывать технологические возможности производителя, чтобы её изготовить. В качестве примера можно использовать рекомендации компании «Резонит»[18 (https://www.rezonit.ru/articles/zadanie-pravil-proektirovaniya-pechatnoy-platy-v-altium-designer/)]. Перед началом проектирования следует ознакомиться с их требованиями и рекомендациями, доступными на официальном сайте компании.

Толщина медной фольги и ширина дорожек:

Примем толщину медной фольги равной 35 мкм. На основании этого определим ширину проводников:

- Для цепей питания 12 В:
  - Ширина дорожки 1 мм.
- Для сигнальных цепей:
  - Ширина дорожки 0,3 мм.
- Расстояние между соседними дорожками должно быть не менее 0,35 мм.

Рекомендации к проектированию платы и расположению компонентов:

- Фильтрующие конденсаторы следует размещать как можно ближе к выводам микросхем для эффективного подавления помех.
- По возможности сокращать общую длину дорожек с высоким напряжением, чтобы минимизировать потери и повысить эффективность работы платы.
- Скруглить края платы для повышения её прочности.
- Предусмотреть четыре отверстия диаметром 3 мм для крепления платы винтами M3.

Для разработки печатной платы будем использовать программное обеспечение Altium Designer. 3-D модель платы управления представлена на рисунке 2 (Приложение В).

## 2.2 Разработка платы датчика положения

Датчик углового положения (ДУП) используется для измерения угла поворота или положения объекта. При изменении углового положения формируется выходной сигнал, который преобразуется в уровень напряжения, соответствующий углу поворота. Этот сигнал передаётся для обработки микроконтроллером и используется для реализации обратной связи по положению и формирования главной ошибки в приводах.

При проектировании платы для датчика углового положения необходимо решить следующие задачи:

- Определить подходящий датчик углового положения, способный измерять углы в диапазоне от 0° до 360°, с учётом требований точности и стабильности.
- Выбрать схему обвязки датчика для его корректной работы.
- Обеспечить питание платы датчика углового положения.
- Реализовать интерфейс соединения датчика с микроконтроллером для передачи данных.

### 2.2.1 Выбор датчика углового положения

Для измерения углового положения в диапазоне от 0° до 360° выбран магнитный датчик углового положения AS5600. Принцип его работы основан на эффекте Холла. Датчик обладает высоким уровнем точности и надёжности, а также поддерживает интерфейс I2C, который позволяет передавать данные на большие расстояния без искажений, характерных для аналогового сигнала.

Основные технические параметры датчика приведены в таблице 6 (Приложение Б) Схему обвязки датчика AS5600 приведем из технической документации на рис. 35.


Рис. 35. Схема обвязки датчика AS5600

- Подтягивающие резисторы: RC0805FR-074R7L компании «Yageo» с номиналом 4,7 кОм.
- Керамический конденсатор C1 по питанию: GRM155R71C104K фирмы «Murata» ёмкостью 100 нФ.
- Дополнительный конденсатор устанавливается только при необходимости постоянного программирования, в данном случае он не используется.

Особенности питания

Для питания AS5600 используется стабилизатор напряжения LM317, обеспечивающий выходное напряжение 3,3 В. Соединение датчика с микроконтроллером осуществляется через разъёмы типа 61303211121 PinHeader 2,54 мм 1х4.

### 2.2.2 Обеспечение питания датчика положения и реализация соединения датчика с микроконтроллером

Датчик углового положения AS5600 обладает гибкими возможностями подключения и может питаться как от 5 В, так и от 3,3 В. Он предоставляет два варианта выходного сигнала: аналоговый и цифровой (по интерфейсу I2C). В связи с тем, что плата управления будет находиться на удалении от платы датчика, использование аналогового выхода может привести к искажению сигнала. Поэтому в данном проекте выбран цифровой интерфейс I2C для передачи данных между датчиком и микроконтроллером.

Для обеспечения согласования логических уровней «0» и «1» между датчиком и микроконтроллером, питание датчика необходимо организовать от 3,3 В. В результате подключение платы датчика положения к управляющей плате будет выполнено с использованием четырёх проводов, объединённых в шлейф:

- 3,3 В – линия питания датчика;
- SDA – линия данных интерфейса I2C;
- SCL – линия тактирования интерфейса I2C;
- GND – общая земля.

Преимущества выбранного подключения

1. Использование цифрового интерфейса I2C позволяет минимизировать влияние помех и обеспечивает стабильную передачу данных на расстоянии.
2. Питание датчика от 3,3 В устраняет необходимость в дополнительных преобразователях уровней сигналов.
3. Компактный шлейф из четырёх проводов упрощает соединение и снижает вероятность ошибок при монтаже.

### 2.2.3 Разработка печатной платы датчика углового положения

Для проектирования платы датчика углового положения необходимо учитывать технологические требования, чтобы обеспечить возможность её производства. Основой для проектирования являются стандарты компании «Резонит»[18 (https://www.rezonit.ru/articles/zadanie-pravil-proektirovaniya-pechatnoy-platy-v-altium-designer/)]. Примем толщину используемой фольги равной 17,5 мкм, а также следующие параметры:

- Ширина дорожек: 0,4 мм;
- Расстояние между соседними дорожками: не менее 0,35 мм.

Дополнительные требования

- Фильтрующие конденсаторы следует размещать максимально близко к выводам микросхем для уменьшения помех.
- Углы платы необходимо скруглить для повышения прочности, исключения концентраторов напряжений и улучшения эргономики.
- Предусмотреть 4 отверстия диаметром 2 мм для крепления платы винтами.

Плата датчика углового положения имеет прямоугольную форму с размерами 15,5 × 20 мм. 3D-модель платы, представлена на рисунке 3 (Приложение В).

# 3. Реализация алгоритма управления

Разработаем алгоритм управления трёхпальцевым захватом. Общая логика для реализации программного обеспечения будет следующей:

- Устройство управляется одной кнопкой или интерфейсом с двумя режимами: «ОТКРЫТЬ» и «СХВАТИТЬ».
- Управляющий контроллер отслеживает угол вращения червяка по одному датчику угла (энкодеру).
- Привод — мотор с червячной передачей.
- Есть заданное значение угла для "открыто" и "закрыто".
- Также используется заданная точность (допуск) на достижение угла.
- Логика должна учитывать, что если угол перестал меняться до достижения целевого значения при захвате, то объект был схвачен.

## 3.1 Общая логика алгоритма работы захватного устройства

Напишем псевдокод для двух режимов работы. Для простоты восприятия мной будут введены так называемые Ключевые параметры. Например, под «УГОЛ_ОТКРЫТО» / «УГОЛ_ЗАКРЫТО» я ввожу понятия значений, которые отражают целевые позиции захвата при открытых и закрытых пальцах для выполнения команд "ОТКРЫТЬ" и "СХВАТИТЬ". «ДОПУСК» - допустимое отклонение от целевого угла, при котором положение считается достигнутым. Оно учитывает неточности сенсоров и люфт в механике и позволяет избежать зацикливания. «МИНИМАЛЬНЫМ_ШАГОМ» обозначим наименьшее изменение угла, которое квалифицируется как движение, то есть ошибку. Оно должно исключить ложную детекцию движения из-за шума или вибраций. А «ПРЕДЕЛ» - это число подряд идущих итераций (или временной интервал), в течение которых угол не изменяется в пределах минимального шага. Это условие остановки при захвате объекта. Если угол не меняется — значит, червяку мешаем преграда (объект).

Режим «ОТКРЫТЬ»

Целевой угол = УГОЛ_ОТКРЫТО

Включить мотор в направлении открытия

ПОКА ( Угол_текущий - УГОЛ_ОТКРЫТО) > ДОПУСК:

Чтение текущего угла

(Продолжать вращение)

Остановить мотор

Режим «СХВАТИТЬ»

Целевой угол = УГОЛ_ЗАКРЫТО

Включить мотор в направлении закрытия

Инициализировать: угол_предыдущий = текущий угол

Инициализировать: таймер_без_изменений = 0

ПОКА (Угол_текущий - УГОЛ_ЗАКРЫТО) > ДОПУСК:

Чтение текущего угла

ЕСЛИ угол_текущий ≈ угол_предыдущий (изменение < МИНИМАЛЬНЫЙ_ШАГ):

Увеличить таймер_без_изменений

ИНАЧЕ:

Сбросить таймер_без_изменений

угол_предыдущий = угол_текущий

ЕСЛИ таймер_без_изменений > ПРЕДЕЛ:

// Объект схвачен, угол не меняется

ВЫЙТИ из цикла

Остановить мотор

## 3.2 Моделирование аппаратной части

Для реализации системы управления электроприводом мы использовали микроконтроллер Arduino Nano[19], а также две специализированные микросхемы: драйвер мотора DRV8871[20] и датчик угла поворота AS5600. Ниже рассмотрим краткое описание каждой из микросхем, а также схему их подключения и принцип взаимодействия компонентов.

Драйвер мотора DRV8871

DRV8871 — это универсальный драйвер постоянного тока, способный управлять нагрузками до 3.6 А (пиково) при напряжении питания до 45 В. Он особенно удобен для управления малыми и средними электродвигателями, обеспечивая простое подключение и защиту от перегрева, перегрузки по току и короткого замыкания. Управление направлением и включением двигателя осуществляется с помощью цифровых входов IN1 и IN2, к которым можно подавать сигналы с микроконтроллера.

Датчик угла AS5600

AS5600 — как уже говорилось выше, это высокоточный магнитный энкодер, работающий по протоколу I2C. Он позволяет считывать абсолютное угловое положение вала (от 0 до 360 градусов) с разрешением до 12 бит. Благодаря своему компактному размеру и простому интерфейсу, AS5600 отлично подходит для интеграции в системы обратной связи, где требуется отслеживать положение ротора двигателя или вала механизма.

Схема подключения

Подключение компонентов выполнено следующим образом:

- AS5600 подключён к Arduino Nano через интерфейс I2C:
  - SDA → A4
  - SCL → A5
  - Питание: VCC → 3.3V, GND → GND
- DRV8871 подключён следующим образом:
  - Power+ и Power- соединены с зарядно-предпусковым устройством с регулировкой тока и напряжения, которое имитирует работу аккумулятора;
  - Motor+ и Motor- подключены к выводам двигателя;
  - GND соединён с общей землёй;
  - IN1 подключён к цифровому пину D9 на Arduino;
  - IN2 подключён к пину D8;
- Простым пользовательским интерфейсом взаимодействия является кнопка управления подключена к цифровому пину D3, с подтягивающим резистором. Она позволяет переключать режимы работы системы:
  - "ОТКРЫТЬ" — двигатель вращается в одну сторону;
  - "СХВАТИТЬ" — двигатель вращается в обратную сторону.

#### Принцип работы

После подачи питания Arduino считывает угловое положение с датчика AS5600, а также отслеживает нажатия на кнопку. При каждом нажатии режим переключается, и соответствующим образом задаются логические уровни на входы IN1 и IN2 драйвера DRV8871, определяя направление вращения двигателя. Таким образом была смоделирована работа разработанных выше плат управления, которые выполняют те же функций.

## 3.3 Разработка программного обеспечения

Первое, с чего начинается любая программа это подключение библиотек и определение пинов. Этот блок - основа аппаратной конфигурации. Он связывает программу с физическими компонентами: мотором, датчиком и кнопкой.

#include <Wire.h>

#include "AS5600.h"

#define IN1 9

#define IN2 8

#define BUTTON 3

Wire.h - эта библиотека используется для работы с интерфейсом I2C. В данном случае, с датчиком угла AS5600.

AS5600.h - это специализированная библиотека для удобной работы с магнитным энкодером AS5600. Она предоставляет методы для инициализации, считывания угла и управления направлением вращения (в логике энкодера).

IN1 и IN2 — пины на Arduino, которые подключаются к драйверу мотора. Они задают направление вращения мотора. В зависимости от того, какая комбинация HIGH/LOW подаётся на эти пины, мотор вращается вперёд, назад или останавливается.

BUTTON — цифровой вход, подключённый к кнопке. Его логическое состояние определяет, в каком режиме работает захват:

- LOW (0) — кнопка нажата → открыть пальцы.
- HIGH (1) — кнопка отпущена → захватить объект.

Далее реализуем собственные функции управления мотором, которые отвечают за движение или остановку захвата. Эти функции управляют направлением вращения мотора путём подачи определённых сигналов на два управляющих пина: IN1 и IN2.

void open_fingers() {

digitalWrite(IN1, LOW);

digitalWrite(IN2, HIGH);

}

В функции open_fingers() сигналы подаются на драйвер мотора (H-мост), который изменяет полярность на выходе. В результате двигатель вращается в одну определённую сторону, которая механически соответствует открытию пальцев захвата.

void close_fingers() {

digitalWrite(IN1, HIGH);

digitalWrite(IN2, LOW);

}

В функции close_fingers() Направление тока через мотор обратное сравнению с open_fingers() и двигатель вращается в противоположную сторону, что приводит к закрытию пальцев.

void stop_motor() {

digitalWrite(IN1, LOW);

digitalWrite(IN2, LOW);

}

Функция stop_motor() устанавливает оба сигнала в 0 , и на мотор не подаётся питание. Двигатель останавливается (инерционно или через торможение, зависит от драйвера).

float read_angle(){

uint16_t raw = as5600.readAngle();

return raw * 360.0 / 4096.0;

}

Функция read_angle() считывает сырое значение угла с датчика AS5600. Оно лежит в диапазоне от 0 до 4095 (12 бит) и преобразует это значение в градусы.

void move_to_angle(float target_angle){

while (abs(current_angle - target_angle) > ДОПУСК) {

if (current_angle < target_angle) {

open_fingers();

} else {

close_fingers();

}

}

}

Функция move_to_angle(float target_angle) cравнивает текущий угол с заданным target_angle: Если текущий угол меньше - вызывает open_fingers(), то есть мотор крутится на открытие, а если больше - вызывает close_fingers(), мотор крутится на закрытие. овторяет это, пока разница больше допустимой погрешности (ДОПУСК). Как только достигли цели — stop_motor(). Это простая пропорциональная логика управления: мотор крутится в нужную сторону, пока угол не приблизится к целевому значению с достаточной точностью.

void grab_object(float target_angle){

while (abs(current_angle - target_angle) > ДОПУСК) {

close_fingers();

if (delta < МИНИМАЛЬНЫЙ_ШАГ) {

steady_counter++;

} else {

steady_counter = 0;

}

if (steady_counter > ПРЕДЕЛ) {

break;

}

}

Функция grab_object(float target_angle) пытается закрыть захват до целевого угла target_angle, как в move_to_angle(),но следит за тем, как изменяется угол между итерациями: Если угол перестал меняться (то есть delta < МИНИМАЛЬНЫЙ_ШАГ) - считает, что захват столкнулся с объектом, увеличивает счётчик steady_counter., если счётчик превысил ПРЕДЕЛ - делает вывод: объект захвачен, дальше крутить нельзя, и выходит из цикла, останавливает мотор. Эта логика позволяет захватить объект неизвестного размера.

Блок основного цикла loop() в вашем Arduino-коде. Именно здесь происходит непрерывная работа: каждый проход цикла анализирует текущее состояние системы и запускает нужные действия.

void loop() {

float degrees = read_angle();

Serial.print("Текущий угол: ");

Serial.println(degrees);

if (digitalRead(BUTTON) == LOW) {

move_to_angle(УГОЛ_ОТКРЫТО);

} else {

grab_object(УГОЛ_ЗАКРЫТО);

}

delay(200);

}

Вызывается функция read_angle(), которая считывает значение угла с энкодера AS5600 и преобразует его в градусы. Это значение сохраняется в переменной degrees и выводится через Serial.print(), чтобы пользователь мог наблюдать текущий угол в Serial Monitor.

digitalRead(BUTTON) считывает состояние кнопки. Предполагается, что:

- LOW (0) — кнопка нажата.
- HIGH (1) — кнопка отпущена.

Именно такая логика характерна для кнопок, подключённых с pull-up резистором (либо внешним, либо встроенным).

Что происходит:

- Если кнопка нажата (LOW):
  - Вызывается функция move_to_angle(УГОЛ_ОТКРЫТО), то есть пальцы схвата раскрываются до заранее заданного угла.
  - Это "режим открытия".
- Если кнопка отпущена (HIGH):
  - Запускается grab_object(УГОЛ_ЗАКРЫТО) — происходит попытка захвата объекта с применением логики останова по сопротивлению.
  - Это "режим захвата".

Пауза в 200 миллисекунд между циклами снижает частоту опроса датчика и обработки сигнала с кнопки, делает работу захвата более плавной и стабильной.

Полная программа приведена в Приложении Г.

## Заключение

В рамках данной выпускной квалификационной работы была выполнена разработка привода трёхпальцевого захватного устройства, предназначенного для учебного стенда манипулятора. Основной задачей проекта стало создание компактного, надёжного и функционального механизма, обеспечивающего синхронную работу всех трёх пальцев от единого привода на базе червячной передачи.

Проведён полный цикл проектирования, включающий: разработку конструктивной схемы и расчёт параметров червячной передачи, валов и опор; энергетический расчёт системы; синтез и моделирование систем автоматического управления в линейной, нелинейной и дискретной постановках; проектирование электронных плат управления и платы датчика углового положения; реализацию алгоритма управления захватным устройством и разработку программного обеспечения.

Выбор червячной передачи позволил обеспечить удобную компоновку, высокий передаточный момент и надёжную фиксацию положения захвата. Такое конструктивное решение упрощает реализацию синхронного движения трёх пальцев от одного привода, снижает общее количество исполнительных механизмов и облегчает управление системой.

Результаты моделирования подтверждают работоспособность разработанного привода и алгоритмов управления. Аппаратная часть может быть использована как в учебных целях, так и как база для дальнейших исследований в области робототехники и мехатронных систем.

Разработанное устройство соответствует поставленным требованиям и может быть успешно интегрировано в состав учебного манипулятора для демонстрации принципов работы современных захватных механизмов и систем управления ими.

# Список используемых источников

1. Расчет на выносливость по напряжениям изгиба активных поверхностей зубьев зубчатых колес. [Электронный ресурс] URL: https://studfile.net/preview/4200349/page:15/

(дата обращения: 24.02.2025)

2. Геометрия и кинематика червячных передач. [Электронный ресурс] URL: https://studopedia.org/1-109256.html?utm_source

(дата обращения: 24.02.2025)

3. Ultramid. [Электронный ресурс] URL: https://plastics-rubber.basf.com/global/en/performance_polymers/products/ultramid

(дата обращения: 25.02.2025)

4. Передачи червячные цилиндрические. ГОСТ 19650-74 [Электронный ресурс] URL:https://files.stroyinf.ru/Data2/1/4294833/4294833742.pdf?ysclid=m7k5bfz4qg858416918 (дата обращения: 25.02.2025)
5. АБС-пластик. [Электронный ресурс] URL: https://ru.wikipedia.org/wiki

(дата обращения: 25.02.2025)

6. АБС. Точка кипения, плотность и модуль Юнга. [Электронный ресурс] URL: https://www.wanhan-plastic.com/ru/article-5416602614952950.html (дата обращения: 26.02.2025)
7. ПОДШИПНИКИ КАЧЕНИЯ. Часть 1. ГОСТ 18855-82. [Электронный ресурс] URL:https://files.stroyinf.ru/Data2/1/4294834/4294834433.pdf?ysclid=m7lriez3iv683683481 (дата обращения: 26.02.2025)
8. ПОДШИПНИКИ ШАРИКОВЫЕ РАДИАЛЬНО-УПОРНЫЕ ОДНОРЯДНЫЕ. Типы и основные размеры. ГОСТ 831-75. [Электронный ресурс] URL:https://files.stroyinf.ru/Data2/1/4294821/4294821660.pdf?ysclid=m7lujqx3x8440365508 (дата обращения: 26.02.2025)
9. Попов Е.П. Теория линейных систем автоматического регулирования и управления: Учеб. пособие для втузов. – 2-е изд., перераб. и доп. – М.: Наука. Гл. ред. физ.-мат. лит., 1989. -
10. Кокорев Ю.А., Жаров В.А., Торгов А.М. Расчет электромеханического привода: Учеб. пособие / Под ред. В.Н.Баранова. – М.: Изд-во МГТУ им. Баумана, 1995. – 132 с.
11. Попов Е.П. Теория нелинейных систем автоматического регулирования и управления: Учеб. пособие. – 2-е изд.,стер. – М.: Наука. Гл. ред. Физ-мат. лит., 1998. – 256 с.
12. «MathWorks» Documentation

URL:https://www.mathworks.com/help/?s_tid=gn_supp

(дата обращения: 14.11.24)

13. Техническая документация на микроконтроллер STM32F030K6T6 [Электронный ресурс] // STMicroelectronicshtt. 2021. С.1-93.

URL.: https://www.st.com/resource/en/datasheet/stm32f030f4.pdf

(дата обращения: 25.01.2025).

14. Техническая документация на драйвер IR2104 [Электронный ресурс] // Infineon Technologies AG. 2004. С.1-14.

URL.: https://www.infineon.com/dgdl/Infineon-IR2104-DS-v01_00-EN.pdf?fileId=5546d462533600a4015355c7c1c31671

(дата обращения: 25.01.2025).

15. Техническая документация на преобразователь напряжения LM2596s [Электронный ресурс] // Guangdong Youtai Semiconductor Co., Ltd. С.1-1

URL.: https://images.tuyacn.com/smart/A_TUYA/cropper/LM2596S.pdf

(дата обращения: 27.01.2025).

16. Техническая документация на датчик углового положения AS5600 [Электронный ресурс] // ams OSRAM Group. 2016. С.1-44.

URL.: https://ams.com/documents/20143/36005/AS5600_DS000365_5-00.pdf (дата обращения: 26.01.2025).

17. Техническая документация на полевой транзистор IRF100B202 [Электронный ресурс] // Infineon Technologies AG. 2014. С.1-11.

URL.: https://www.infineon.com/dgdl/Infineon-IRF100B202-DataSheet-v01_01-EN.pdf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

(дата обращения: 25.01.2025).

18. Использование правил проектирования печатной платы в Altium Designer [Электронный ресурс]

URL.: https://www.rezonit.ru/articles/zadanie-pravil-proektirovaniya-pechatnoy-platy-v-altium-designer/?utm_source

(дата обращения: 26.01.2025).

19. Arduino Nano v3.0 на процессоре ATMEGA328P [Электронный ресурс] URL:https://supereyes.ru/img/instructions/arduino_nano_v3.pdf?ysclid=mbo2yfrd9q304727837 (дата обращения: 3.06.2025).
20. Техническая документация на драйвер DRV8871. [Электронный ресурс] URL: https://cdn-shop.adafruit.com/product-files/3190/drv8871.pdf (дата обращения: 3.06.2025).

# ПРИЛОЖЕНИЯ

# ПРИЛОЖЕНИЕ А

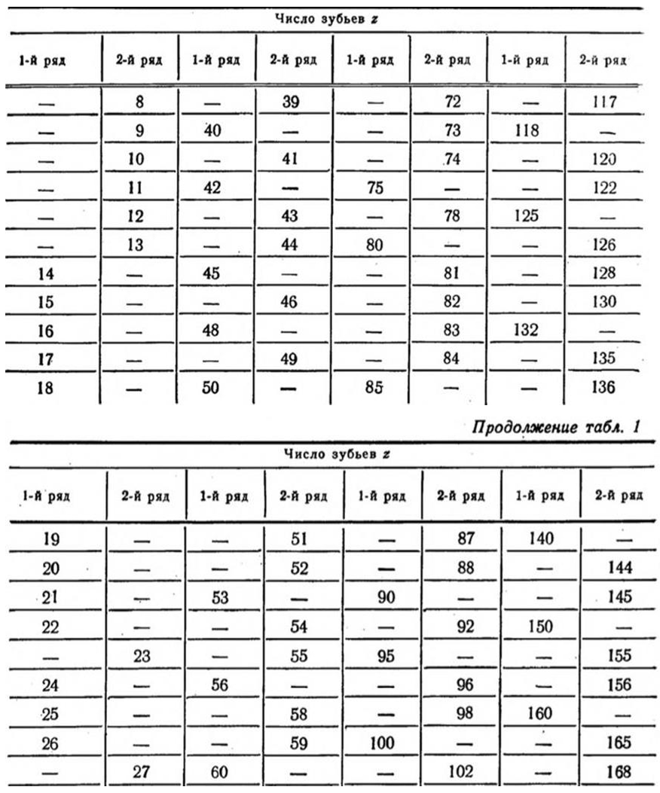
[picture p47: figure]

Рис. 1. Стандартный ряд модулей зубчатых колес

# ПРИЛОЖЕНИЕ Б

Таблица 1

Параметры червячной передачи

Параметр | Обозначение | Значение
Число зубьев зубчатого колеса | zк | 27
Число витков червяка (Вид ZI) | zч | 4
Модуль зацепления | m | 1
Межосевое расстояние между зубчатым колесом и червяком, мм | aω | 23,5
Делительный диаметр зубчатого колеса, мм | dк | 27
Делительный диаметр червяка, мм | dч | 20
Ширина зубчатого колеса, мм | bк | 10
Ширина червяка, мм | bч | 17
Основной угол подъема, ° | γ_b | 22,9
Передаточное отношение | i | 6,75

Таблица 2

Технические характеристики мотора-редуктора JGA25-370

с передаточным отношением 103

Параметр | Обозначение | Значение
Номинальное напряжение, В | U_н | 12
Номинальная скорость вращения выходного вала редуктора, ±10% , об/мин | n_н | 46

Таблица 2

Технические характеристики мотора-редуктора JGA25-370

с передаточным отношением 103

Параметр | Обозначение | Значение
Номинальный ток, А | I_н | 0,3
Номинальный момент на выходном валу редуктора, Н ∙ м | M_н | 0,196
Масса, кг | m | 0,105

Таблица 3

Технические характеристики мотора-редуктора JGA25-370

с передаточным отношением 500

Параметр | Обозначение | Значение
Номинальное напряжение, В | U_н | 12
Номинальная скорость вращения выходного вала редуктора, ±10%, об/мин | n_н | 10
Номинальный ток, А | I_н | 0,3
Номинальный момент на выходном валу редуктора, Н ∙ м | M_н | 0,95
Масса, кг | m | 0,11

Таблица 4

Функционал выводов IR2104

Номер вывода | Функциональное назначение | Условное обозначение
1 | Вход напряжения питания «низкой стороны» фиксированного значения | V_(CC)
2 | Вход логического напряжения | IN
3 | Вход для сигнала выключения | SD
4 | Подключение к общему проводу для «низкой стороны» | COM
5 | Вход напряжения питания «высокой стороны» переменного значения | V_B
6 | Выход управляющего напряжения для верхнего ключа | HO
7 | Подключение к нагрузке для «высокой стороны» | V_S
8 | Выход управляющего напряжения для нижнего ключа | LO

Таблица 5

Функционал выводов LM2596S

Номер вывода | Функциональное назначение | Условное обозначение
1 | Вход для подключения напряжения питания | VIN
2 | Выход микросхемы | OUT
3 | Вход для подключения к общему проводу | GND
4 | Вход для обратной связи по выходному напряжению | FB
5 | Включение/выключение микросхемы | ON/OFF

Таблица 6

Основные характеристики AS5600

Обозначение | Минимальное значение | Максимальное значение
V_(DD5V) | -0,3 В | 6,1 В
V_(DD3V3) | -0,3 В | 4 В
VIH | -0,3 В | 0,3∙V_(DD) В
VIL | 0,7∙V_(DD) В | V_(DD) +0,3 В

Таблица 7

Функционал выводов AS5600

Номер вывода | Функциональное назначение | Условное обозначение
1 | Вход для подключения напряжения питания 5 В | V_(DD5V)
2 | Вход для подключения напряжения питания 3,3 В | V_(DD3V3)
3 | Аналоговый выход датчика положения | OUT
4 | Вход для подключения земли | GND
5 | Вход для возможности программирования | PGO
6 | Вход для подключения линии данных I²C интерфейса | SDA
7 | Вход для подключения линии тактирования I²C интерфейса | SCL
8 | Вход для определения полярности направления | DIR

# ПРИЛОЖЕНИЕ В

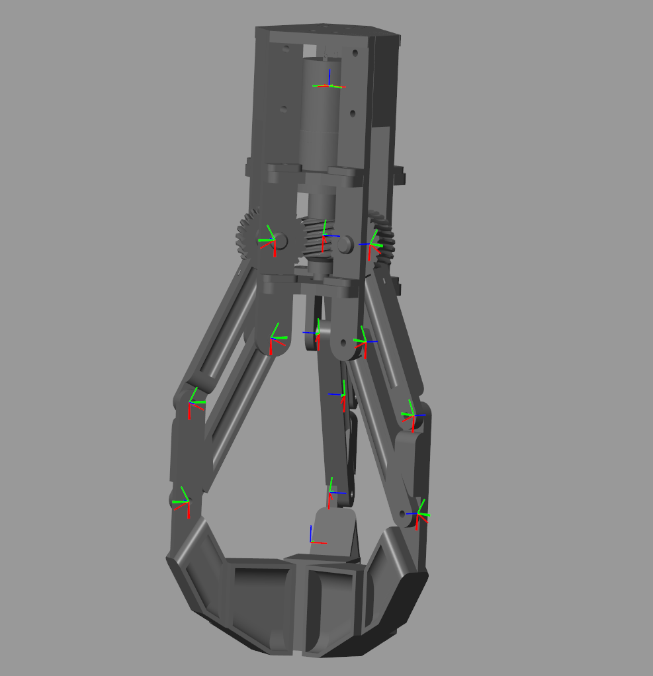
[picture p48: figure]

Рис. 1. 3D модель привода захватного устройства учебного робота-манипулятора

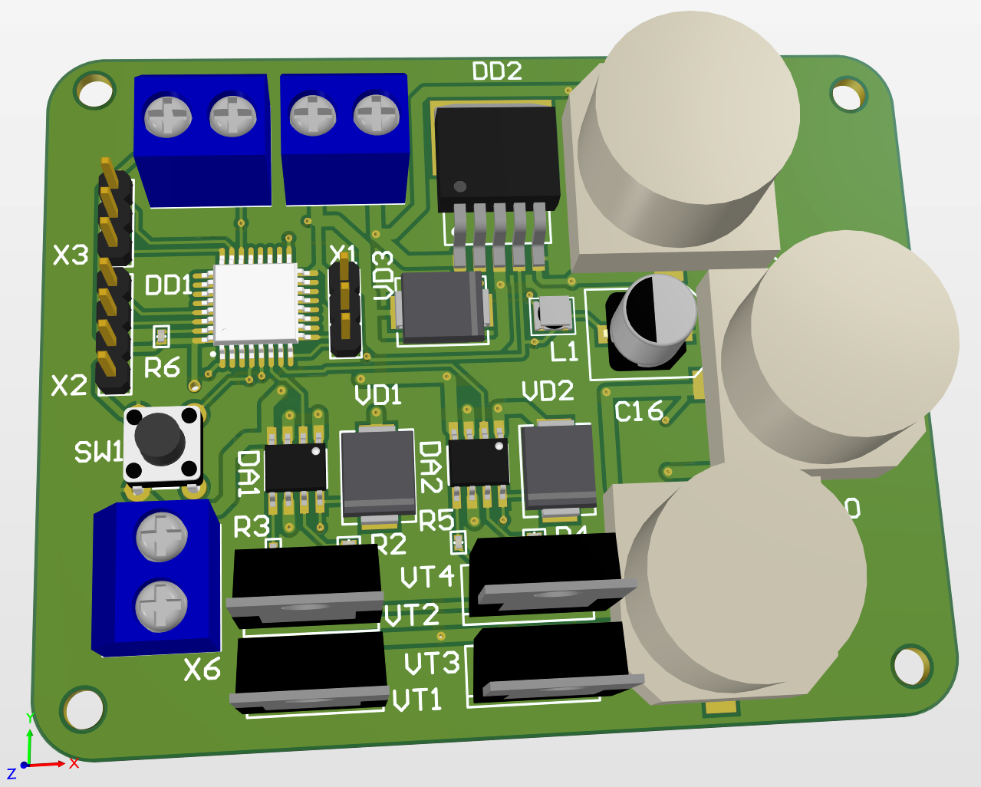
[picture p49: figure]

Рис. 2. 3D модель платы управления


Рис. 3. 3D модель платы датчика углового положения

# ПРИЛОЖЕНИЕ Г

// Подключение необходимых библиотек

#include <Wire.h>

#include "AS5600.h"

// Пины управления мотором и кнопкой

#define IN1 9

#define IN2 8

#define BUTTON 3

// Ключевые параметры

#define УГОЛ_ОТКРЫТО 300.0 // Градусы для открытого состояния

#define УГОЛ_ЗАКРЫТО 50.0 // Градусы для закрытого состояния

#define ДОПУСК 2.0 // Допустимое отклонение в градусах

#define МИНИМАЛЬНЫЙ_ШАГ 0.5 // Минимальное изменение угла

#define ПРЕДЕЛ 50 // Максимальное число итераций без изменения угла

AS5600 as5600; // Объект датчика угла

void setup() {

pinMode(IN1, OUTPUT);

pinMode(IN2, OUTPUT);

pinMode(BUTTON, INPUT);

Serial.begin(9600);

Wire.begin();

if (!as5600.begin()) {

Serial.println("AS5600 не найден!");

while (1);

}

as5600.setDirection(AS5600_CLOCK_WISE);

Serial.println("AS5600 готов!");

stop_motor();

}

void loop() {

float degrees = read_angle();

Serial.print("Текущий угол: ");

Serial.println(degrees);

if (digitalRead(BUTTON) == LOW) {

Serial.println("Режим: ОТКРЫТЬ");

move_to_angle(УГОЛ_ОТКРЫТО);

} else {

Serial.println("Режим: СХВАТИТЬ");

grab_object(УГОЛ_ЗАКРЫТО);

}

delay(200);

}

float read_angle() {

uint16_t raw = as5600.readAngle();

return raw * 360.0 / 4096.0;

}

void move_to_angle(float target_angle) {

float current_angle = read_angle();

while (abs(current_angle - target_angle) > ДОПУСК) {

if (current_angle < target_angle) {

open_fingers();

} else {

close_fingers();

}

delay(50);

current_angle = read_angle();

}

stop_motor();

Serial.println("Целевой угол достигнут");

}

void grab_object(float target_angle) {

float current_angle = read_angle();

int steady_counter = 0;

float previous_angle = current_angle;

while (abs(current_angle - target_angle) > ДОПУСК) {

close_fingers();

delay(50);

current_angle = read_angle();

float delta = abs(current_angle - previous_angle);

if (delta < МИНИМАЛЬНЫЙ_ШАГ) {

steady_counter++;

} else {

steady_counter = 0;

}

if (steady_counter > ПРЕДЕЛ) {

Serial.println("Объект захвачен, мотор остановлен");

break;

}

previous_angle = current_angle;

}

stop_motor();

}

void open_fingers() {

digitalWrite(IN1, LOW);

digitalWrite(IN2, HIGH);

}

void close_fingers() {

digitalWrite(IN1, HIGH);

digitalWrite(IN2, LOW);

}

void stop_motor() {

digitalWrite(IN1, LOW);

digitalWrite(IN2, LOW);

}
