MSolovtsov/BachelorThesis_Manipulator/Electronic/Draws/Датчик/сбор датчик.pdf

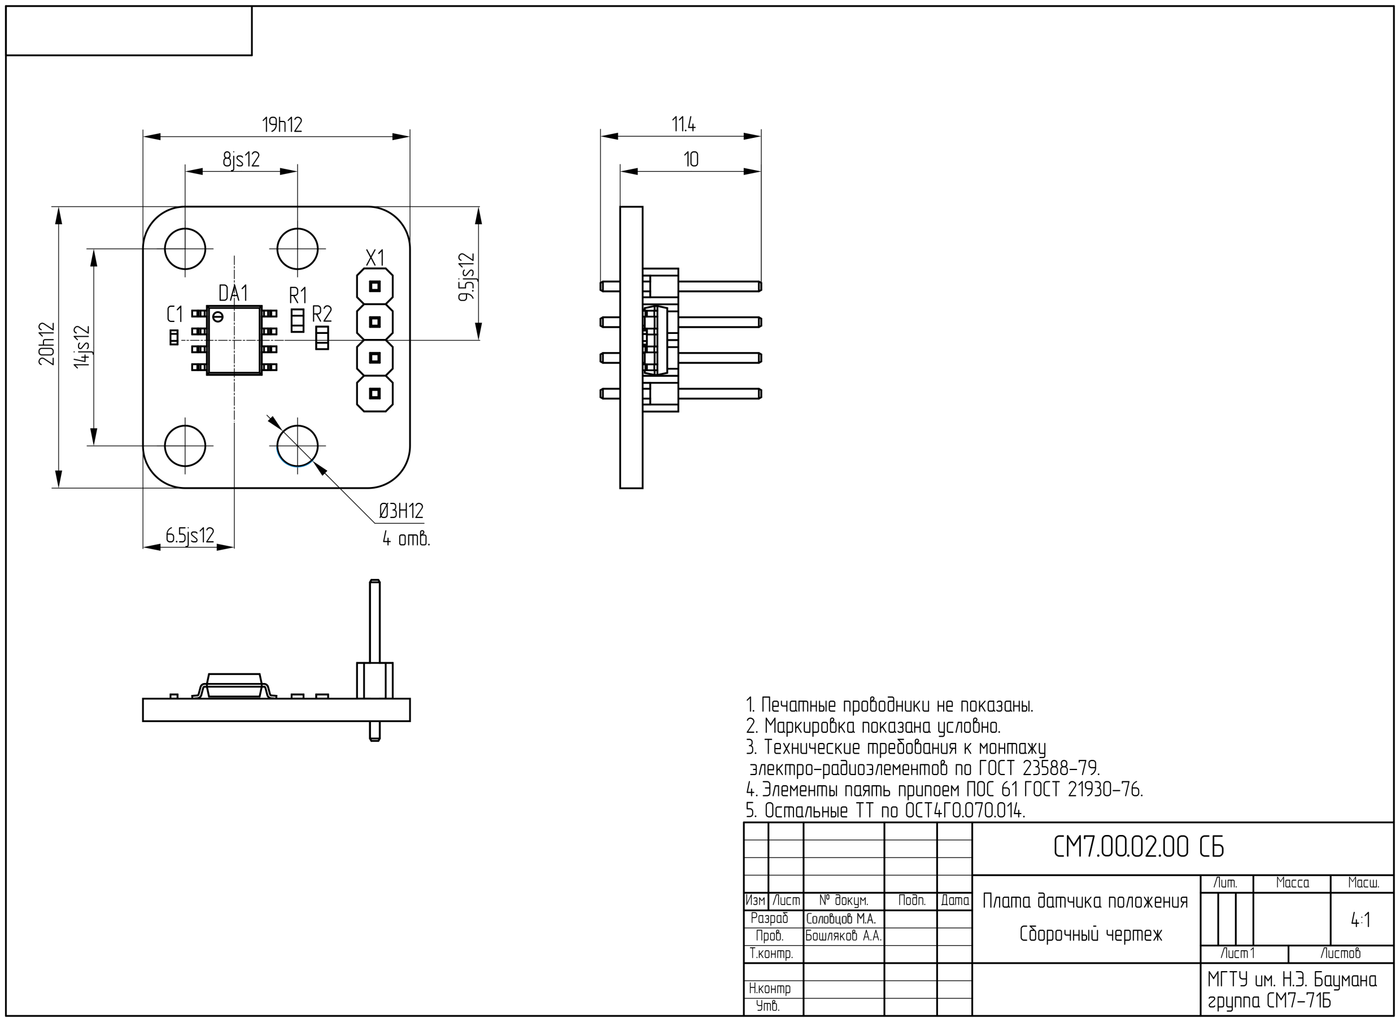
[picture p66: page 1]
