MSolovtsov/BachelorThesis_Manipulator/Electronic/Altium/Курсовой проект по  электронике/Электроника/DBGOSTBOM.xls

Group | Status | Раздел | Обозначение | Наименование | Part Number | Analog | Name | ValueSCH | PCB_Layout | Pin Count | Library Path | Library Ref | Footprint Path | Footprint Ref | ComponentLink1Description | ComponentLink1URL | ComponentLink2Description | ComponentLink2URL | HelpURL | Manufacturer | ManufacturerCountry | StandartDoc | ProductCode
C | Разрешен | Прочие изделия | (null) | Конденсатор | GRM188R71H104KA93# | (null) | GRM 0603 0,1 мкФ ±10% 50В X7R | 0,1мк | SMT | 2 | GOSTBOM.SchLib | CAP_NONPOL | GOSTBOM.PcbLib | CAPC1608X90N | Manufacturer Link | www.murata.com | Datasheet Link | http://www.murata.com/products/catalog/pdf/c02e.pdf |  | MURATA | США
R | Разрешен | Прочие изделия | (null) | Резистор | CR0402-FX-4701G | (null) | CR 0402 4,7 кОм ±1% | 4,7к | SMT | 2 | GOSTBOM.SchLib | RESISTOR | GOSTBOM.PcbLib | RESC1005X40N | Manufacturer Link | www.bourns.com | Datasheet Link | http://www.bourns.com/data/global/pdfs/CR0402.pdf |  | Bourns | США
DD | Разрешен | Прочие изделия | (null) | Микросхема | DS18B20U | (null) | DS18B20U | (null) | SMT | 8 | GOSTBOM.SchLib | DS18B20U | GOSTBOM.PcbLib | SOP65P490X110-8CN | Manufacturer Link | www.maximintegrated.com | Datasheet Link | http://datasheets.maximintegrated.com/en/ds/DS18B20.pdf
DD | Разрешен | Прочие изделия | (null) | Микросхема | DS18B20U+ | (null) | DS18B20U+ | (null) | SMT | 8 | GOSTBOM.SchLib | DS18B20U | GOSTBOM.PcbLib | SOP65P490X110-8CN | Manufacturer Link | www.maximintegrated.com | Datasheet Link | http://datasheets.maximintegrated.com/en/ds/DS18B20.pdf
R | Разрешен | Прочие изделия | (null) | Резистор | CR2512-FX-8200E | (null) | CR 2512 820 Ом ±1% | 820 | SMT | 2 | GOSTBOM.SchLib | RESISTOR | GOSTBOM.PcbLib | RESC6331X75N | Manufacturer Link | www.bourns.com | Datasheet Link | http://www.bourns.com/data/global/pdfs/CR2010.pdf |  | Bourns | США
R | Разрешен | Прочие изделия | (null) | Резистор | CR2512-FX-8201E | (null) | CR 2512 8,2 кОм ±1% | 8,2к | SMT | 2 | GOSTBOM.SchLib | RESISTOR | GOSTBOM.PcbLib | RESC6331X75N | Manufacturer Link | www.bourns.com | Datasheet Link | http://www.bourns.com/data/global/pdfs/CR2010.pdf |  | Bourns | США
R | Разрешен | Прочие изделия | (null) | Резистор | CR2512-FX-8202E | (null) | CR 2512 82 кОм ±1% | 82к | SMT | 2 | GOSTBOM.SchLib | RESISTOR | GOSTBOM.PcbLib | RESC6331X75N | Manufacturer Link | www.bourns.com | Datasheet Link | http://www.bourns.com/data/global/pdfs/CR2010.pdf |  | Bourns | США
R | Разрешен | Прочие изделия | (null) | Резистор | CR2512-FX-8203E | (null) | CR 2512 820 кОм ±1% | 820к | SMT | 2 | GOSTBOM.SchLib | RESISTOR | GOSTBOM.PcbLib | RESC6331X75N | Manufacturer Link | www.bourns.com | Datasheet Link | http://www.bourns.com/data/global/pdfs/CR2010.pdf |  | Bourns | США
XP | Разрешен | Прочие изделия | (null) | Соединитель | СНП346-5ВП21-1-В РЮМК.430420.011ТУ | PLS | СНП346-5ВП21-1-В | 1.0А, 125В | PTH | 1 | GOSTBOM.SchLib | CONN5_1PARTM | GOSTBOM.PcbLib | ELECTRODETAL_SNP346-5VP21-1 | Manufacturer Link | https://www.elektrodetal.com/ | Datasheet Link | http://www.elektrodetal.com/sites/default/files/downloads/snp346.pdf |  | АО «Карачевский завод «Электродеталь» | Россия | РЮМК.430420.011ТУ | 27.33.13.120
XP | Разрешен | Прочие изделия | (null) | Соединитель | СНП346-5ВП31-1-В РЮМК.430420.011ТУ | PLS | СНП346-5ВП31-1-В | 1.0А, 125В | PTH | 1 | GOSTBOM.SchLib | CONN5_1PARTM | GOSTBOM.PcbLib | ELECTRODETAL_SNP346-5VP31-1 | Manufacturer Link | https://www.elektrodetal.com/ | Datasheet Link | http://www.elektrodetal.com/sites/default/files/downloads/snp346.pdf |  | АО «Карачевский завод «Электродеталь» | Россия | РЮМК.430420.011ТУ | 27.33.13.120
XP | Запрещен | Прочие изделия | (null) | Соединитель | PLS |  | PLS | 1.0А, 125В | PTH | 1 | GOSTBOM.SchLib | CONN1_1PARTM | GOSTBOM.PcbLib | PLS-1 | Manufacturer Link |  | Datasheet Link
XP | Разрешен | Стандартные изделия | (null) | Соединитель | Лепесток 2-1-2-7-02 ГОСТ 16840-78 |  | Лепесток 2-1-2-7-02 ГОСТ 16840-78 | 1.0А, 125В | PTH | 1 | GOSTBOM.SchLib | CONN1_1PARTM | GOSTBOM.PcbLib | ELPetalPin_2-1-2-7-02GOST_16840 | Manufacturer Link | http://docs.cntd.ru/document/1200044394 | Datasheet Link | http://docs.cntd.ru/document/1200044394 |  |  | Россия | ГОСТ 16840-78 | 27.33.13.120
