MSolovtsov/BachelorThesis_Manipulator/Electronic/Altium/Курсовой проект по  электронике/Электроника/AD_GOST/Examples/MiniPC MB GOST/MiniPC MB GOST_╨Я╨н3.xls

Sheet: 495.604.1585. Первый лист.
Перв. примен. | 495.604.1585 | Поз. обозна-чение |  |  | Наименование |  |  |  | Кол. |  | Примечание
 |  |  |  |  | Устройства
 |  | A1-R5 |  |  | Резистор ERJ-2GE0R00X |  |  |  | 5
 |  | A1-D3 |  |  | Сборка диодная 82401646 |  |  |  | 3
Справ. № |  | A1-C1 |  |  | Конденсатор GRM188R61A225KE34x |  |  |  | 1
 |  | A1-D1 |  |  | Электронный ключ MAX14523AATA+ |  |  |  | 1
 |  | A1-C13 |  |  | Конденсатор GRM155R71H472KA01D |  |  |  | 13
 |  | A1-R1 |  |  | Резистор ERJ-2RKF2803X |  |  |  | 1
 |  | A1-R2 |  |  | Резистор ERJ-2RKF1003X |  |  |  | 2
 |  | A1-R6 |  |  | Резистор ERJ-2RKF1004X |  |  |  | 6
 |  | A1-R4 |  |  | Резистор ERJ-2RKF1004X |  |  |  | 4
 |  | A1-R3 |  |  | Резистор ERJ-2RKF1004X |  |  |  | 3
 |  | A1-R7 |  |  | Резистор ERJ-2RKF1003X |  |  |  | 7
 |  | A1-C6 |  |  | Конденсатор C1005X7R1E104M |  |  |  | 6
Подп. и дата |  | A1-C7 |  |  | Конденсатор C1005X7R1E104M |  |  |  | 7
 |  | A1-D2 |  |  | Сборка диодная 82401646 |  |  |  | 2
 |  | A1-C12 |  |  | Конденсатор C1005X7R1E104M |  |  |  | 12
 |  | A1-C5 |  |  | Конденсатор C1005X7R1E104M |  |  |  | 5
Инв. № дубл. |  | A1-C11 |  |  | Конденсатор C1005X7R1E104M |  |  |  | 11
 |  | A1-C8 |  |  | Конденсатор C1005X7R1E104M |  |  |  | 8
 |  | A1-C3 |  |  | Конденсатор C1005X7R1E104M |  |  |  | 3
Взам. инв.№ |  | A1-C9 |  |  | Конденсатор C1005X7R1E104M |  |  |  | 9
 |  | A1-C10 |  |  | Конденсатор C1005X7R1E104M |  |  |  | 10
Подп. и дата
 |  |  |  |  |  |  |  | 495.604.1585ПЭ3
 |  |  | -
 |  | Изм. | Лист | № докум. |  | Подп. | Дата
Инв. № подл. |  | Разраб. |  | Разрабов |  |  |  | MiniPC Основная плата |  | Лит. |  | Лист | Листов
 |  | Пров. |  | Проверов |  |  |  |  |  | О |  | 1 | 7
 |  | Н.контр |  | Нормачев
 |  | Утв. |  | Утверждун |  |  |  | Перечень элементов

Sheet: 2
 | Поз. обозна- чение |  |  | Наименование |  |  |  | Кол. | Примечание
 |  |  |  | Устройства
 | A1-C4 |  |  | Конденсатор C1005X7R1E104M |  |  |  | 4
 | A1-C2 |  |  | Конденсатор C1005X7R1E104M |  |  |  | 2
 | A3-C27 |  |  | Конденсатор C1005X7R1E104M |  |  |  | 25
 | A3-C14-A3-C17 |  |  | Конденсатор GRM033R60J104KE19D |  |  |  | 12
 | A3-R8 |  |  | Резистор ERJ-2RKF1651X |  |  |  | 6
 | A3-C19 |  |  | Конденсатор GRM033R60J104KE19D |  |  |  | 17
 | A3-D4 |  |  | Преобразователь интерфейсов |  |  |  | 2
 | A3-C21 |  |  | Конденсатор GRM033R60J104KE19D |  |  |  | 19
 | A3-G1 |  |  | Генератор ASE2-33.000MHZ-ET |  |  |  | -1
 | A3-C28 |  |  | Конденсатор GRM033R60J104KE19D |  |  |  | 26
 | A3-C20 |  |  | Конденсатор C1005X7R1E104M |  |  |  | 18
 | A3-C26 |  |  | Конденсатор C1005X7R1E104M |  |  |  | 24
Подп. и дата | A3-C22 |  |  | Конденсатор C1005X7R1E104M |  |  |  | 20
 | A3-C25 |  |  | Конденсатор C1005X7R1E104M |  |  |  | 23
 | A3-R9 |  |  | Резистор ERJ-2RKF1002X |  |  |  | 7
 | A3-C24 |  |  | Конденсатор C1005X7R1E104M |  |  |  | 22
Инв. № дубл. | A3-C23 |  |  | Конденсатор C1005X7R1E104M |  |  |  | 21
 | A3-C18 |  |  | Конденсатор C1005X7R1E104M |  |  |  | 16
 | A4-C36 |  |  | Конденсатор GRM188R61A225KE34x |  |  |  | 33
Взам. инв.№ | A4-G11 |  |  | Генератор ASE2-33.000MHZ-ET |  |  |  | 8
 | A4-XW1-A4-XW3 |  |  | Соединитель ВЧ LTI-SASF54GT |  |  |  | -2
 | A4-C48 |  |  | Конденсатор C1005X7R1E104M |  |  |  | 45
Подп. и дата | A4-R12 |  |  | Резистор ERJ-2GE0R00X |  |  |  | 9
 | A4-R10 |  |  | Резистор ERJ-2GE0R00X |  |  |  | 7
 | A4-R13 |  |  | Резистор ERJ-2GE0R00X |  |  |  | 10
 | A4-L3 |  |  | Ферритовый дроссель |  |  |  | 0
 | A4-C37 |  |  | Конденсатор |  |  |  | 34
Инв. № подл. | A4-L4 |  |  | Ферритовый дроссель BLM15AG221SN1x |  |  |  | 1
 |  |  |  |  |  |  | 495.604.1585ПЭ3 |  |  | Лист
 |  | -
 |  |  |  |  |  |  |  |  |  | 2
 | Изм. | Лист | № докум. |  | Подп. | Дата

Sheet: 3
 | Поз. обозна- чение |  |  | Наименование |  |  |  | Кол. | Примечание
 |  |  |  | Устройства
 | A4-L5 |  |  | Ферритовый дроссель |  |  |  | 2
 | A4-L2 |  |  | Ферритовый дроссель BLM15AG221SN1x |  |  |  | -1
 | A4-L6 |  |  | Ферритовый дроссель |  |  |  | 3
 | A4-XP1 |  |  | Соединитель 613 002 111 21 |  |  |  | -2
 | A4-R14 |  |  | Резистор ERJ-2RKF4701X |  |  |  | 11
 | A4-R16-A4-R18 |  |  | Резистор ERJ-2RKF1001X |  |  |  | 13
 | A4-L1 |  |  | Ферритовый дроссель BLM15AG221SN1J |  |  |  | -2
 | A4-R15 |  |  | Резистор ERJ-2RKF4701X |  |  |  | 12
 | A4-G7 |  |  | Программируемый генератор Si5338C-B03798-GM |  |  |  | 4
 | A4-G10 |  |  | Генератор FA-128 25.0000MB-C |  |  |  | 7
 | A4-G6 |  |  | Программируемый генератор Si5338B-B03799-GM |  |  |  | 3
 | A4-D5 |  |  | Мультиплексор ICS83054AGILF |  |  |  | 2
Подп. и дата | A4-G9 |  |  | Генератор FA-128 25.0000MB-C |  |  |  | 6
 | A4-C56 |  |  | Конденсатор GRM155R71H103KA88D |  |  |  | 53
 | A4-G8 |  |  | Генератор FA-128 25.0000MB-C |  |  |  | 5
 | A4-G5 |  |  | Программируемый генератор Si5338B-B03799-GM |  |  |  | 2
Инв. № дубл. | A4-G2 |  |  | Генератор FA-128 25.0000MB-C |  |  |  | -1
 | A4-G4 |  |  | Сдвоенный ГУН 516FHA000132AAG |  |  |  | 1
 | A4-XP2 |  |  | Соединитель 613 002 111 21 |  |  |  | -1
Взам. инв.№ | A4-G3 |  |  | Сдвоенный генератор Si52112-A1-GM2 |  |  |  | 0
 | A4-C34 |  |  | Конденсатор C1005X7R1E104M |  |  |  | 31
 | A4-C35 |  |  | Конденсатор C1005X7R1E104M |  |  |  | 32
Подп. и дата | A4-R11 |  |  | Резистор ERJ-2GE0R00X |  |  |  | 8
 | A4-C41 |  |  | Конденсатор C1005X7R1E104M |  |  |  | 38
 | A4-C49 |  |  | Конденсатор C1005X7R1E104M |  |  |  | 46
 | A4-C47 |  |  | Конденсатор C1005X7R1E104M |  |  |  | 44
 | A4-C43 |  |  | Конденсатор C1005X7R1E104M |  |  |  | 40
Инв. № подл. | A4-C54 |  |  | Конденсатор C1005X7R1E104M |  |  |  | 51
 |  |  |  |  |  |  | 495.604.1585ПЭ3 |  |  | Лист
 |  | -
 |  |  |  |  |  |  |  |  |  | 3
 | Изм. | Лист | № докум. |  | Подп. | Дата

Sheet: 4
 | Поз. обозна- чение |  |  | Наименование |  |  |  | Кол. | Примечание
 |  |  |  | Устройства
 | A4-C52 |  |  | Конденсатор C1005X7R1E104M |  |  |  | 49
 | A4-C62 |  |  | Конденсатор C1005X7R1E104M |  |  |  | 59
 | A4-C32 |  |  | Конденсатор C1005X7R1E104M |  |  |  | 29
 | A4-C51 |  |  | Конденсатор C1005X7R1E104M |  |  |  | 48
 | A4-C40 |  |  | Конденсатор C1005X7R1E104M |  |  |  | 37
 | A4-C33 |  |  | Конденсатор C1005X7R1E104M |  |  |  | 30
 | A4-C42 |  |  | Конденсатор C1005X7R1E104M |  |  |  | 39
 | A4-C39 |  |  | Конденсатор C1005X7R1E104M |  |  |  | 36
 | A4-C29 |  |  | Конденсатор C1005X7R1E104M |  |  |  | 26
 | A4-C30 |  |  | Конденсатор C1005X7R1E104M |  |  |  | 27
 | A4-C38 |  |  | Конденсатор C1005X7R1E104M |  |  |  | 35
 | A4-C46 |  |  | Конденсатор C1005X7R1E104M |  |  |  | 43
Подп. и дата | A4-C45 |  |  | Конденсатор C1005X7R1E104M |  |  |  | 42
 | A4-C44 |  |  | Конденсатор C1005X7R1E104M |  |  |  | 41
 | A4-C57 |  |  | Конденсатор C1005X7R1E104M |  |  |  | 54
 | A4-C31 |  |  | Конденсатор C1005X7R1E104M |  |  |  | 28
Инв. № дубл. | A4-C53 |  |  | Конденсатор C1005X7R1E104M |  |  |  | 50
 | A4-C50 |  |  | Конденсатор C1005X7R1E104M |  |  |  | 47
 | A4-C64 |  |  | Конденсатор C1005X7R1E104M |  |  |  | 61
Взам. инв.№ | A4-C65 |  |  | Конденсатор C1005X7R1E104M |  |  |  | 62
 | A4-C60 |  |  | Конденсатор C1005X7R1E104M |  |  |  | 57
 | A4-C66 |  |  | Конденсатор C1005X7R1E104M |  |  |  | 63
Подп. и дата | A4-C68 |  |  | Конденсатор C1005X7R1E104M |  |  |  | 65
 | A4-C67 |  |  | Конденсатор C1005X7R1E104M |  |  |  | 64
 | A4-C61 |  |  | Конденсатор C1005X7R1E104M |  |  |  | 58
 | A4-C55 |  |  | Конденсатор C1005X7R1E104M |  |  |  | 52
 | A4-C63 |  |  | Конденсатор C1005X7R1E104M |  |  |  | 60
Инв. № подл. | A4-C58 |  |  | Конденсатор C1005X7R1E104M |  |  |  | 55
 |  |  |  |  |  |  | 495.604.1585ПЭ3 |  |  | Лист
 |  | -
 |  |  |  |  |  |  |  |  |  | 4
 | Изм. | Лист | № докум. |  | Подп. | Дата

Sheet: 5
 | Поз. обозна- чение |  |  | Наименование |  |  |  | Кол. | Примечание
 |  |  |  | Устройства
 | A4-C59 |  |  | Конденсатор C1005X7R1E104M |  |  |  | 56
 | A8-R22 |  |  | Резистор ERJ-2RKF1001X |  |  |  | 15
 | A8-R19 |  |  | Резистор ERJ-2RKF1001X |  |  |  | 12
 | A8-R20 |  |  | Резистор ERJ-2RKF1001X |  |  |  | 13
 | A8-XP3 |  |  | Соединитель TSM-105-01-T-DV-TR |  |  |  | -4
 | A8-R21 |  |  | Резистор ERJ-2RKF1001X |  |  |  | 14
 | A9-C69 |  |  | Конденсатор C1005X7R1E104M |  |  |  | 61
 | A9-XS1 |  |  | Соединитель |  |  |  | -7
 | A9-C70 |  |  | Конденсатор C1005X7R1E104M |  |  |  | 62
 | A11-C82 |  |  | Конденсатор GRM155R61A224KE19D |  |  |  | 72
 | A11-C84 |  |  | Конденсатор GRM155R61A224KE19D |  |  |  | 74
 | A11-C75 |  |  | Конденсатор C1005X7R1E104M |  |  |  | 65
Подп. и дата | A11-C97 |  |  | Конденсатор GRM155R61A224KE19D |  |  |  | 87
 | A11-C88 |  |  | Конденсатор GRM155R61A224KE19D |  |  |  | 78
 | A11-C94 |  |  | Конденсатор GRM155R61A224KE19D |  |  |  | 84
 | A11-C91 |  |  | Конденсатор GRM155R61A224KE19D |  |  |  | 81
Инв. № дубл. | A11-C87 |  |  | Конденсатор GRM155R61A224KE19D |  |  |  | 77
 | A11-C89 |  |  | Конденсатор GRM155R61A224KE19D |  |  |  | 79
 | A11-C95 |  |  | Конденсатор GRM155R61A224KE19D |  |  |  | 85
Взам. инв.№ | A11-C86 |  |  | Конденсатор GRM155R61A224KE19D |  |  |  | 76
 | A11-C90 |  |  | Конденсатор GRM155R61A224KE19D |  |  |  | 80
 | A11-C93 |  |  | Конденсатор GRM155R61A224KE19D |  |  |  | 83
Подп. и дата | A11-C96 |  |  | Конденсатор GRM155R61A224KE19D |  |  |  | 86
 | A11-C83 |  |  | Конденсатор GRM155R61A224KE19D |  |  |  | 73
 | A11-C92 |  |  | Конденсатор GRM155R61A224KE19D |  |  |  | 82
 | A11-C77 |  |  | Конденсатор C1005X7R1E104M |  |  |  | 67
 | A11-C73 |  |  | Конденсатор C1005X7R1E104M |  |  |  | 63
Инв. № подл. | A11-C76 |  |  | Конденсатор C1005X7R1E104M |  |  |  | 66
 |  |  |  |  |  |  | 495.604.1585ПЭ3 |  |  | Лист
 |  | -
 |  |  |  |  |  |  |  |  |  | 5
 | Изм. | Лист | № докум. |  | Подп. | Дата

Sheet: 6
 | Поз. обозна- чение |  |  | Наименование |  |  |  | Кол. | Примечание
 |  |  |  | Устройства
 | A11-C78 |  |  | Конденсатор C1005X7R1E104M |  |  |  | 68
 | A11-C74 |  |  | Конденсатор C1005X7R1E104M |  |  |  | 64
 | A11-C80 |  |  | Конденсатор C1005X7R1E104M |  |  |  | 70
 | A11-C72 |  |  | Конденсатор C1005X7R1E104M |  |  |  | 62
 | A11-C85 |  |  | Конденсатор GRM155R61A224KE19D |  |  |  | 75
 | A11-C81 |  |  | Конденсатор GRM31CR60J107ME39L |  |  |  | 71
 | A11-C71 |  |  | Конденсатор GRM31CR61E226KE15L |  |  |  | 61
 | A11-R23 |  |  | Резистор ERJ-2RKF4701X |  |  |  | 13
 | A11-XS2 |  |  | Соединитель PCIE-098-02-F-D-TH |  |  |  | -8
 | A11-C79 |  |  | Конденсатор C1005X7R1E104M |  |  |  | 69
Подп. и дата
Инв. № дубл.
Взам. инв.№
Подп. и дата
Инв. № подл.
 |  |  |  |  |  |  | 495.604.1585ПЭ3 |  |  | Лист
 |  | -
 |  |  |  |  |  |  |  |  |  | 6
 | Изм. | Лист | № докум. |  | Подп. | Дата

Sheet: Лист регистрации изменений.
 | Лист регистрации изменений
 | Изм. |  | Номера листов (страниц) |  |  |  |  |  |  |  | Всего листов (страниц) в докум. | № докум. | Входящий № сопроводи-тельного документа и дата | Под- пись | Дата
 |  |  | изменен- ных |  | заменен- ных |  | новых |  |  | аннули- рован- ных
Подп. и дата
Инв. № дубл.
Взам. инв.№
Подп. и дата
Инв. № подл.
 |  |  |  |  |  |  |  |  | 495.604.1585ПЭ3 |  |  |  |  |  |  | Лист
 |  | -
 |  |  |  |  |  |  |  |  |  |  |  |  |  |  |  | 7
 | Изм. | Лист |  | № докум. |  | Подп. |  | Дата
