MSolovtsov/BachelorThesis_Manipulator/Electronic/Altium/Курсовой проект по  электронике/Электроника/AD_GOST/Examples/BaseDimmer/Project Outputs for ╨Р╨С╨Т╨У.201905.100/╨Р╨С╨Т╨У.201905.100.xls

Sheet: АБВГ.201905.100. Первый лист.
Блок/Печатный узел | Перв. примен. | Формат | Зона |  | Поз. |  | Обозначение |  |  |  | Наименование |  |  | Кол. | Примечание
 |  |  |  |  |  |  |  |  |  |  | Документация
 |  | А3 |  |  |  |  | АБВГ.201905.100Э3 |  |  |  | Схема электрическая
 |  |  |  |  |  |  |  |  |  |  | принципиальная
 |  | А4 |  |  |  |  | АБВГ.201905.100ПЭ2 |  |  |  | Перечень элементов
 | Справ. № | А3 |  |  |  |  | АБВГ.201905.100СБ |  |  |  | Сборочный чертеж
 |  |  |  |  |  |  |  |  |  |  | Детали
 |  | А3 |  |  | 1 |  | АБВГ.201905.010 |  |  |  | Плата печатная |  |  | 1
 |  |  |  |  |  |  |  |  |  |  | Прочие изделия
 |  |  |  |  |  |  |  |  |  |  | Конденсаторы
 |  |  |  |  | 2 |  |  |  |  |  | LLM215R70J224MA11L |  |  | 1 | C2
 |  |  |  |  |  |  |  |  |  |  | [Murata]
 | Подп. и дата |  |  |  | 3 |  |  |  |  |  | VJ1825Y105KXXAT [Vishay] |  |  | 1 | C1
 |  |  |  |  |  |  |  |  |  |  | Микросхемы
 |  |  |  |  | 4 |  |  |  |  |  | LM1117DTX-5.0/NOPB |  |  | 1 | D1
 | Инв. № дубл. |  |  |  |  |  |  |  |  |  | [TI National Semiconductor]
 | Взам. инв. №
 | Подп. и дата
 |  |  |  |  |  |  |  |  |  | АБВГ.201905.100
 |  | Изм. |  | Лист |  | № докум. |  | Подп. | Дата
 | Инв. № подл. | Разраб. |  |  |  | Фень |  |  |  | Модуль сигнализации |  | Лит. | Лист |  |  | Листов
 |  | Пров. |  |  |  | Кондратьев |  |  |  |  |  | Э | 1 |  |  | 2
 |  | Рук.Проекта |  |  |  | Фень
 |  | Н. контр. |  |  |  | Демидов
 |  | Утв. |  |  |  | Илюкин

Sheet: 2
Блок/Печатный узел |  | Формат | Зона |  | Поз. |  | Обозначение |  |  |  | Наименование | Кол. | Примечание
 |  |  |  |  |  |  |  |  |  |  | Переключатели
 |  |  |  |  | 5 |  |  |  |  |  | Сенсор [ | 2 | S1, S2
 |  |  |  |  |  |  |  |  |  |  | Диоды
 |  |  |  |  | 6 |  |  |  |  |  | P6SMB27AT3G | 6 | VD1-VD6
 |  |  |  |  |  |  |  |  |  |  | [ON Semiconductor]
 |  |  |  |  |  |  |  |  |  |  | Транзисторы
 |  |  |  |  | 7 |  |  |  |  |  | AO3400A | 6 | VT1-VT6
 |  |  |  |  |  |  |  |  |  |  | [Alpha & Omega Semiconductor]
 |  |  |  |  |  |  |  |  |  |  | Вилки
 |  |  |  |  | 8 |  |  |  |  |  | TSM-104-04-T-DV.1 [Samtec] | 2 | XP1, XP2
 |  |  |  |  | 9 |  |  |  |  |  | TSW-105-05-T-S [Samtec] | 3 | XP3-XP5
 |  |  |  |  |  |  |  |  |  |  | Розетки
 |  |  |  |  | 10 |  |  |  |  |  | 691213710003 | 1 | XS1
 | Подп. и дата |  |  |  |  |  |  |  |  |  | [Wurht Electronics]
 | Инв. № дубл.
 | Взам. инв. №
 | Подп. и дата
 | Инв. № подл.
 |  |  |  |  |  |  |  |  |  | АБВГ.201905.100 |  |  |  | Лист
 |  |  |  |  |  |  |  |  |  |  |  |  |  | 2
 |  | Изм. |  | Лист |  | № докум. |  | Подп. | Дата
