MSolovtsov/BachelorThesis_Manipulator/Electronic/Altium/Курсовой проект по  электронике/Электроника/AD_GOST/Examples/BaseDimmer/Project Outputs for ╨Р╨С╨Т╨У.201905.100/╨Р╨С╨Т╨У.201905.100╨Я╨н3.xls

Sheet: АБВГ.201905.100. Первый лист.
Блок/Печатный узел | Перв. примен. | АБВГ.201905.100 | Поз. обозна-чение |  |  | Наименование |  |  |  | Кол. |  | Примечание
 |  |  |  |  |  | Конденсаторы
 |  |  | C1 |  |  | VJ1825Y105KXXAT [Vishay] |  |  |  | 1
 |  |  | C2 |  |  | LLM215R70J224MA11L [Murata] |  |  |  | 1
 | Справ. №
 |  |  |  |  |  | Микросхемы
 |  |  | D1 |  |  | LM1117DTX-5.0/NOPB [TI National Semiconductor] |  |  |  | 1
 |  |  |  |  |  | Переключатели
 |  |  | S1,S2 |  |  | Сенсор [ |  |  |  | 2
 |  |  |  |  |  | Диоды
 | Подп. и дата
 |  |  | VD1-VD6 |  |  | P6SMB27AT3G [ON Semiconductor] |  |  |  | 6
 |  |  |  |  |  | Транзисторы
 | Инв. № дубл.
 |  |  | VT1-VT6 |  |  | AO3400A [Alpha & Omega Semiconductor] |  |  |  | 6
 | Взам. инв.№
 | Подп. и дата
 |  |  |  |  |  |  |  |  | АБВГ.201905.100ПЭ3
 |  |  | 1 | Все |  |  |  | 16.05.19
 |  |  | Изм. | Лист | № докум. |  | Подп. | Дата
 | Инв. № подл. |  | Разраб. |  | Леган |  |  |  | Модуль сигнализации |  | Лит. |  | Лист | Листов
 |  |  | Пров. |  | Кондратьев |  |  |  |  |  | Э |  | 1 | 2
 |  |  | Рук.Проекта |  | Фень
 |  |  | Н.контр |  | Демидов
 |  |  | Утв. |  | Илюкин |  |  |  | Перечень элементов

Sheet: 2
Блок/Печатный узел |  | Поз. обозна- чение |  |  | Наименование |  |  |  | Кол. | Примечание
 |  |  |  |  | Вилки
 |  | XP1,XP2 |  |  | TSM-104-04-T-DV.1 [Samtec] |  |  |  | 2
 |  | XP3-XP5 |  |  | TSW-105-05-T-S [Samtec] |  |  |  | 3
 |  |  |  |  | Розетки
 |  | XS1 |  |  | 691213710003 [Wurht Electronics] |  |  |  | 1
 | Подп. и дата
 | Инв. № дубл.
 | Взам. инв.№
 | Подп. и дата
 | Инв. № подл.
 |  |  |  |  |  |  |  | АБВГ.201905.100ПЭ3 |  |  | Лист
 |  | 1 | Все |  |  |  | 16.05.19
 |  |  |  |  |  |  |  |  |  |  | 2
 |  | Изм. | Лист | № докум. |  | Подп. | Дата
