MSolovtsov/BachelorThesis_Manipulator/Electronic/Altium/Курсовой проект по  электронике/Электроника/AD_GOST/Examples/TEST_GOSTBOM/Project Outputs for XXXX.468361.001/XXXX.468361.001.xls

Sheet: ХХХХ.468361.001. Первый лист.
Проект, Изделие, Блок, ФУ | Перв. примен. | ХХХХ.468361.777 | Формат | Зона |  | Поз. |  | Обозначение |  |  |  | Наименование |  |  |  |  | Кол. | Примечание
 |  |  |  |  |  |  |  |  |  |  |  | Документация
 |  |  | А3 |  |  |  |  | ХХХХ.468361.001СБ |  |  |  | Сборочный чертеж
 |  |  | А3 |  |  |  |  | ХХХХ.468361.001Э3 |  |  |  | Схема электрическая
 |  |  |  |  |  |  |  |  |  |  |  | принципиальная
 | Справ. № |  | А4 |  |  |  |  | ХХХХ.468361.001ПЭ3 |  |  |  | Перечень элементов
 |  |  |  |  |  |  |  |  |  |  |  | Детали
 |  |  | А3 |  |  | 1 |  | XXXX.758723.001 |  |  |  | Плата печатная |  |  |  |  | 1
 |  |  |  |  |  |  |  |  |  |  |  | Прочие изделия
 |  |  |  |  |  |  |  |  |  |  |  | Конденсаторы
 |  |  |  |  |  | 2 |  |  |  |  |  | GRM188R71H104KA93# |  |  |  |  | 1 | C1
 | Подп. и дата |  |  |  |  |  |  |  |  |  |  | Микросхемы
 |  |  |  |  |  | 3 |  |  |  |  |  | DS18B20U+ |  |  |  |  | 1 | DD1
 |  |  |  |  |  |  |  |  |  |  |  | Резисторы
 | Инв. № дубл. |  |  |  |  | 4 |  |  |  |  |  | CR0402-FX-4701G |  |  |  |  | 1 | R1
 |  |  |  |  |  | 5 |  |  |  |  |  | CR2512-FX-8200E |  |  |  |  | 6 | R3-R8
 | Взам. инв. №
 | Подп. и дата
 |  |  |  |  |  |  |  |  |  |  | ХХХХ.468361.001
 |  |  | 4 |  | - |  | 004-18 |  |  | 26.04.2018
 |  |  | Изм. |  | Лист |  | № докум. |  | Подп. | Дата
 | Инв. № подл. |  | Разраб. |  |  |  | К_Разраб. |  |  |  | Модуль обогрева (МО) |  | Лит. |  |  | Лист |  |  | Листов
 |  |  | Пров. |  |  |  | К_Пров. |  |  |  |  |  | П | Э | Т | 1 |  |  | 5
 |  |  | Рук.Проекта |  |  |  | К_РПроекта
 |  |  | Н. контр. |  |  |  | К_НКонтр.
 |  |  | Утв. |  |  |  | К_Утв.

Sheet: 2
Проект, Изделие, Блок, ФУ |  | Формат | Зона |  | Поз. |  | Обозначение |  |  |  | Наименование | Кол. | Примечание
 |  |  |  |  |  |  |  |  |  |  | Материалы
 |  |  |  |  | 6 |  |  |  |  |  | Лак УР-231 | 100 | см
 |  |  |  |  |  |  |  |  |  |  | ТУ6-10-863-76.9.3
 |  |  |  |  | 7 |  |  |  |  |  | Припой ПОС-61 ГОСТ 21931-76 | 1 | г
 | Подп. и дата
 | Инв. № дубл.
 | Взам. инв. №
 | Подп. и дата
 | Инв. № подл.
 |  |  |  |  |  |  |  |  |  | ХХХХ.468361.001 |  |  |  | Лист
 |  | 4 |  | - |  | 004-18 |  |  | 26.04.2018
 |  |  |  |  |  |  |  |  |  |  |  |  |  | 2
 |  | Изм. |  | Лист |  | № докум. |  | Подп. | Дата

Sheet: 3
Проект, Изделие, Блок, ФУ |  | Формат | Зона |  | Поз. |  | Обозначение |  |  |  | Наименование | Кол. | Примечание
 |  |  |  |  |  |  | Переменные данные для исполнений
 |  |  |  |  |  |  |  |  |  |  | ХХХХ.468361.001
 |  |  |  |  |  |  |  |  |  |  | Стандартные изделия
 |  |  |  |  | 8 |  |  |  |  |  | Лепесток 2-1-2-7-02 | 4 | XP2-XP5
 |  |  |  |  |  |  |  |  |  |  | ГОСТ 16840-78
 |  |  |  |  |  |  |  |  |  |  | Прочие изделия
 |  |  |  |  |  |  |  |  |  |  | Резисторы
 |  |  |  |  | 10 |  |  |  |  |  | CR2512-FX-8200E | 2 | R2, R9
 |  |  |  |  |  |  |  |  |  |  | Вилки
 |  |  |  |  | 13 |  |  |  |  |  | СНП346-5ВП21-1-В | 1 | XP1
 |  |  |  |  |  |  |  |  |  |  | РЮМК.430420.011ТУ
 | Подп. и дата
 |  |  |  |  |  |  |  |  |  |  | ХХХХ.468361.001-01
 |  |  |  |  |  |  |  |  |  |  | Стандартные изделия
 | Инв. № дубл.
 |  |  |  |  | - |  |  |  |  |  | Не устанавливать | 4 | XP2-XP5
 | Взам. инв. № |  |  |  |  |  |  |  |  |  | Прочие изделия
 |  |  |  |  |  |  |  |  |  |  | Резисторы
 | Подп. и дата |  |  |  | - |  |  |  |  |  | Не устанавливать | 2 | R2, R9
 | Инв. № подл.
 |  |  |  |  |  |  |  |  |  | ХХХХ.468361.001 |  |  |  | Лист
 |  | 4 |  | - |  | 004-18 |  |  | 26.04.2018
 |  |  |  |  |  |  |  |  |  |  |  |  |  | 3
 |  | Изм. |  | Лист |  | № докум. |  | Подп. | Дата

Sheet: 4
Проект, Изделие, Блок, ФУ |  | Формат | Зона |  | Поз. |  | Обозначение |  |  |  | Наименование | Кол. | Примечание
 |  |  |  |  |  |  |  |  |  |  | Вилки
 |  |  |  |  | 14 |  |  |  |  |  | СНП346-5ВП31-1-В | 1 | XP1
 |  |  |  |  |  |  |  |  |  |  | РЮМК.430420.011ТУ
 |  |  |  |  |  |  |  |  |  |  | ХХХХ.468361.001-02
 |  |  |  |  |  |  |  |  |  |  | Стандартные изделия
 |  |  |  |  | 8 |  |  |  |  |  | Лепесток 2-1-2-7-02 | 4 | XP2-XP5
 |  |  |  |  |  |  |  |  |  |  | ГОСТ 16840-78
 |  |  |  |  |  |  |  |  |  |  | Прочие изделия
 |  |  |  |  |  |  |  |  |  |  | Резисторы
 |  |  |  |  | 11 |  |  |  |  |  | CR2512-FX-8201E | 2 | R2, R9
 |  |  |  |  |  |  |  |  |  |  | Вилки
 | Подп. и дата |  |  |  | 13 |  |  |  |  |  | СНП346-5ВП21-1-В | 1 | XP1
 |  |  |  |  |  |  |  |  |  |  | РЮМК.430420.011ТУ
 | Инв. № дубл.
 | Взам. инв. №
 | Подп. и дата
 | Инв. № подл.
 |  |  |  |  |  |  |  |  |  | ХХХХ.468361.001 |  |  |  | Лист
 |  | 4 |  | - |  | 004-18 |  |  | 26.04.2018
 |  |  |  |  |  |  |  |  |  |  |  |  |  | 4
 |  | Изм. |  | Лист |  | № докум. |  | Подп. | Дата

Sheet: Лист регистрации изменений.
Проект, Изделие, Блок, ФУ |  | Лист регистрации изменений
 |  | Изм. |  | Номера листов (страниц) |  |  |  |  |  |  |  | Всего листов (страниц) в докум. | № докум. | Входящий № сопроводи- тельного документа и дата | Под- пись | Дата
 |  |  |  | изме- ненных |  | заме- няемых |  | новых |  |  | аннули-рованных
 | Подп. и дата
 | Инв. № дубл.
 | Взам. инв. №
 | Подп. и дата
 | Инв.№ подл.
 |  |  |  |  |  |  |  |  |  | ХХХХ.468361.001 |  |  |  |  |  |  | Лист
 |  | 4 | - |  | 004-18 |  |  |  | 26.04.2018
 |  |  |  |  |  |  |  |  |  |  |  |  |  |  |  |  | 5
 |  | Изм. | Лист |  | № докум |  | Подп. |  | Дата
