MSolovtsov/BachelorThesis_Manipulator/Electronic/Altium/Курсовой проект по  электронике/Электроника/AD_GOST/Examples/TEST_GOSTBOM/Project Outputs for XXXX.468361.001/XXXX.468361.001_╨Т╨Я.xls

Проект, Изделие, Блок, ФУ | Перв. примен. | ХХХХ.468361.001 | № строки | Наименование | Код ОКП | Обозначение документа на поставку | Поставщик |  |  |  |  |  | Кол. на исполн. |  |  |  |  |  |  |  | Примечание
 |  |  |  |  |  |  |  |  |  |  |  |  | -00 |  | -01 | -02
 |  |  |  | Стандартные изделия
 |  |  | 1 | Лепесток 2-1-2-7-02 | 27.33.13.120 | ГОСТ 16840-78 | Россия |  |  |  |  |  | 4 |  | x | 4
 |  |  |  | ГОСТ 16840-78
 | Справ. № |  |  | Прочие изделия
 |  |  |  | Конденсаторы
 |  |  | 2 | GRM188R71H104KA93# |  |  | MURATA, США |  |  |  |  |  | 1 |  | 1 | 1
 |  |  |  | Микросхемы
 |  |  | 3 | DS18B20U+ |  |  |  |  |  |  |  |  | 1 |  | 1 | 1
 |  |  |  | Резисторы
 |  |  | 4 | CR0402-FX-4701G |  |  | Bourns, США |  |  |  |  |  | 1 |  | 1 | 1
 |  |  | 5 | CR2512-FX-8200E |  |  | Bourns, США |  |  |  |  |  | 8 |  | 6 | 6
 |  |  | 6 | CR2512-FX-8201E |  |  | Bourns, США |  |  |  |  |  | x |  | x | 2
 | Подп. и дата
 |  |  |  | Вилки
 |  |  | 7 | СНП346-5ВП21-1-В | 27.33.13.120 | РЮМК.430420.011ТУ | АО «Карачевский завод |  |  |  |  |  | 1 |  | x | 1
 |  |  |  | РЮМК.430420.011ТУ |  |  | «Электродеталь», Россия
 | Инв. № дубл. |  | 8 | СНП346-5ВП31-1-В | 27.33.13.120 | РЮМК.430420.011ТУ | АО «Карачевский завод |  |  |  |  |  | x |  | 1 | x
 |  |  |  | РЮМК.430420.011ТУ |  |  | «Электродеталь», Россия
 | Взам. инв. №
 | Подп. и дата
 |  |  |  |  |  |  |  |  |  |  |  |  |  | ХХХХ.468361.001 ВП
 |  |  |  |  |  |  |  | 3 | Все | 003-18 |  | 25.04.2018
 |  |  |  |  |  |  |  | Изм. | Лист | № докум. | Подп. | Дата
 | Инв. № подл. |  |  |  |  |  |  | Разраб. |  | К_Разраб. |  |  |  | Модуль обогрева (МО) |  |  | Лит. |  |  | Лист |  | Листов
 |  |  |  |  |  |  |  | Пров. |  | К_Пров. |  |  |  |  |  |  | П | Э | Т |  |  | 1
 |  |  |  |  |  |  |  | Рук.Проекта |  | К_РПроекта
 |  |  |  |  |  |  |  | Н. контр. |  | К_НКонтр.
 |  |  |  |  |  |  |  | Утв. |  | К_Утв. |  |  |  | Ведомость покупных изделий
