MSolovtsov/BachelorThesis_Manipulator/Electronic/Altium/Курсовой проект по  электронике/Электроника/AD_GOST/Examples/TEST_GOSTBOM/Project Outputs for XXXX.468361.001/XXXX.468361.001_╨Я╨н3.xls

Sheet: ХХХХ.468361.001. Первый лист.
Проект, Изделие, Блок, ФУ | Перв. примен. | ХХХХ.468361.001 | Поз. обозна-чение |  |  | Наименование |  |  |  | Кол. |  | Примечание
 |  |  |  |  |  | Конденсаторы
 |  |  | C1 |  |  | GRM188R71H104KA93# |  |  |  | 1
 | Справ. № |  |  |  |  | Микросхемы
 |  |  | DD1 |  |  | DS18B20U+ |  |  |  | 1
 |  |  |  |  |  | Резисторы
 |  |  | R1 |  |  | CR0402-FX-4701G |  |  |  | 1
 |  |  | R3-R8 |  |  | CR2512-FX-8200E |  |  |  | 6
 | Подп. и дата
 | Инв. № дубл.
 | Взам. инв.№
 | Подп. и дата
 |  |  |  |  |  |  |  |  | ХХХХ.468361.001ПЭ3
 |  |  | 2 | Нов. | 002-18 |  |  | 24.04.2018
 |  |  | Изм. | Лист | № докум. |  | Подп. | Дата
 | Инв. № подл. |  | Разраб. |  | Сх_Разраб |  |  |  | Модуль обогрева (МО) |  | Лит. |  |  | Лист | Листов
 |  |  | Пров. |  | Сх_Пров. |  |  |  |  |  | П | Э | Т | 1 | 4
 |  |  | Рук.Проекта |  | Сх_РПроекта
 |  |  | Н.контр |  | Сх_НКонтр.
 |  |  | Утв. |  | Сх_Утв. |  |  |  | Перечень элементов

Sheet: 2
Проект, Изделие, Блок, ФУ |  | Поз. обозна- чение |  |  | Наименование |  |  |  | Кол. | Примечание
 |  |  |  |  | Переменные данные для исполнений
 |  |  |  |  | ХХХХ.468361.001
 |  |  |  |  | Резисторы
 |  | R2,R9 |  |  | CR2512-FX-8200E |  |  |  | 2
 |  |  |  |  | Вилки
 |  | XP1 |  |  | СНП346-5ВП21-1-В РЮМК.430420.011ТУ |  |  |  | 1
 |  | XP2-XP5 |  |  | Лепесток 2-1-2-7-02 ГОСТ 16840-78 |  |  |  | 4
 |  |  |  |  | ХХХХ.468361.001-01
 | Подп. и дата
 |  |  |  |  | Резисторы
 |  | R2,R9 |  |  | Не устанавливать |  |  |  | 2
 | Инв. № дубл.
 |  |  |  |  | Вилки
 | Взам. инв.№ | XP1 |  |  | СНП346-5ВП31-1-В РЮМК.430420.011ТУ |  |  |  | 1
 |  | XP2-XP5 |  |  | Не устанавливать |  |  |  | 4
 | Подп. и дата
 | Инв. № подл.
 |  |  |  |  |  |  |  | ХХХХ.468361.001ПЭ3 |  |  | Лист
 |  | 2 | Нов. | 002-18 |  |  | 24.04.2018
 |  |  |  |  |  |  |  |  |  |  | 2
 |  | Изм. | Лист | № докум. |  | Подп. | Дата

Sheet: 3
Проект, Изделие, Блок, ФУ |  | Поз. обозна- чение |  |  | Наименование |  |  |  | Кол. | Примечание
 |  |  |  |  | ХХХХ.468361.001-02
 |  |  |  |  | Резисторы
 |  | R2,R9 |  |  | CR2512-FX-8201E |  |  |  | 2
 |  |  |  |  | Вилки
 |  | XP1 |  |  | СНП346-5ВП21-1-В РЮМК.430420.011ТУ |  |  |  | 1
 |  | XP2-XP5 |  |  | Лепесток 2-1-2-7-02 ГОСТ 16840-78 |  |  |  | 4
 | Подп. и дата
 | Инв. № дубл.
 | Взам. инв.№
 | Подп. и дата
 | Инв. № подл.
 |  |  |  |  |  |  |  | ХХХХ.468361.001ПЭ3 |  |  | Лист
 |  | 2 | Нов. | 002-18 |  |  | 24.04.2018
 |  |  |  |  |  |  |  |  |  |  | 3
 |  | Изм. | Лист | № докум. |  | Подп. | Дата

Sheet: Лист регистрации изменений.
Проект, Изделие, Блок, ФУ |  | Лист регистрации изменений
 |  | Изм. |  | Номера листов (страниц) |  |  |  |  |  |  |  | Всего листов (страниц) в докум. | № докум. | Входящий № сопроводи-тельного документа и дата | Под- пись | Дата
 |  |  |  | изменен- ных |  | заменен- ных |  | новых |  |  | аннули- рован- ных
 | Подп. и дата
 | Инв. № дубл.
 | Взам. инв.№
 | Подп. и дата
 | Инв. № подл.
 |  |  |  |  |  |  |  |  |  | ХХХХ.468361.001ПЭ3 |  |  |  |  |  |  | Лист
 |  | 2 | Нов. |  | 002-18 |  |  |  | 24.04.2018
 |  |  |  |  |  |  |  |  |  |  |  |  |  |  |  |  | 4
 |  | Изм. | Лист |  | № докум. |  | Подп. |  | Дата
