MSolovtsov/BachelorThesis_Manipulator/Electronic/Altium/Курсовой проект по  электронике/Электроника/User Library-SOIC-8-1.step

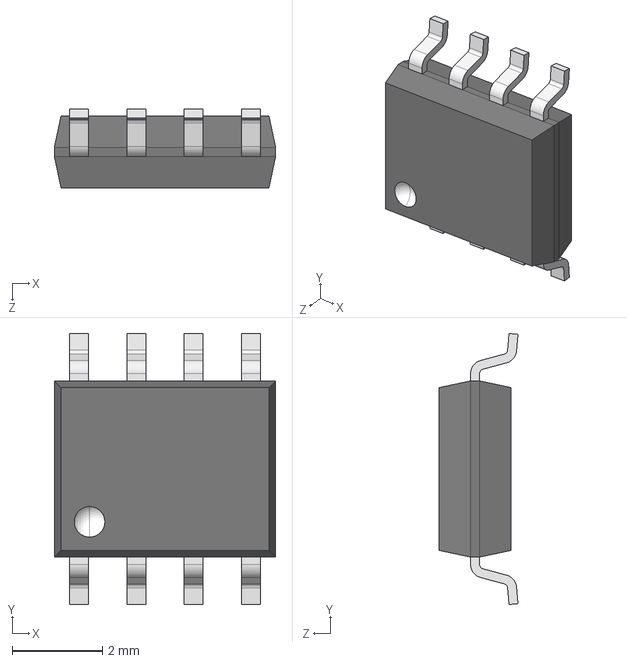
[picture p67: CAD file, 2025-06-08]
Electronic/Altium/Курсовой проект по электронике/Электроника/User Library-SOIC-8-1.step
4.90 x 6.00 x 1.75 mm
