MSolovtsov/BachelorThesis_Manipulator/End_effector/_Print/Червяк.stl

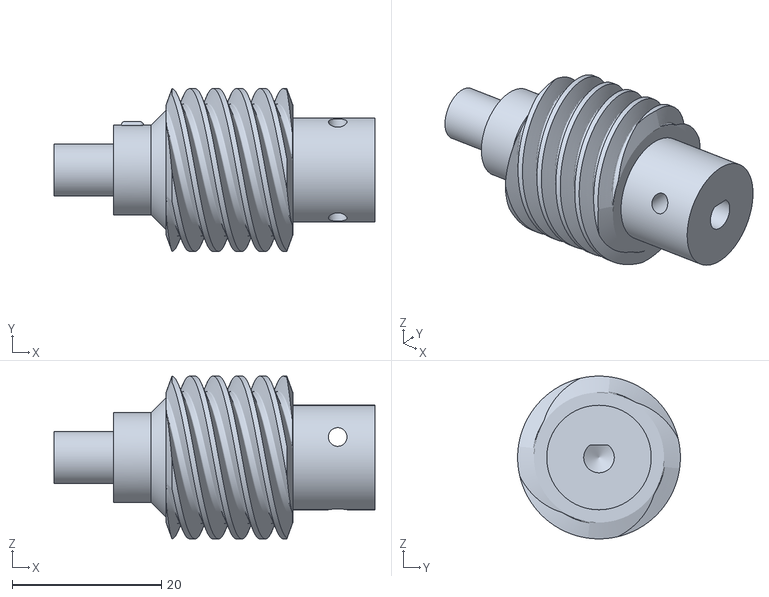
[picture p68: CAD file, 2025-06-08]
End_effector/_Print/Червяк.stl
43.0 x 21.8 x 21.8
