MSolovtsov/BachelorThesis_Manipulator/MatLab/SimModel/5_3_finger.stl

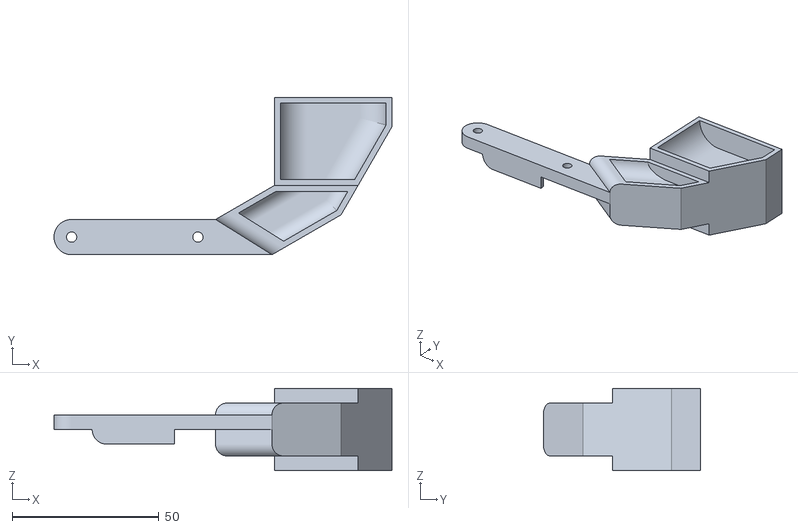
[picture p69: CAD file, 2025-05-09]
MatLab/SimModel/5_3_finger.stl
115.1 x 53.6 x 28.0
