MSolovtsov/BachelorThesis_Manipulator/Electronic/Altium/Курсовой проект по  электронике/Электроника/User Library-TO252AA.step

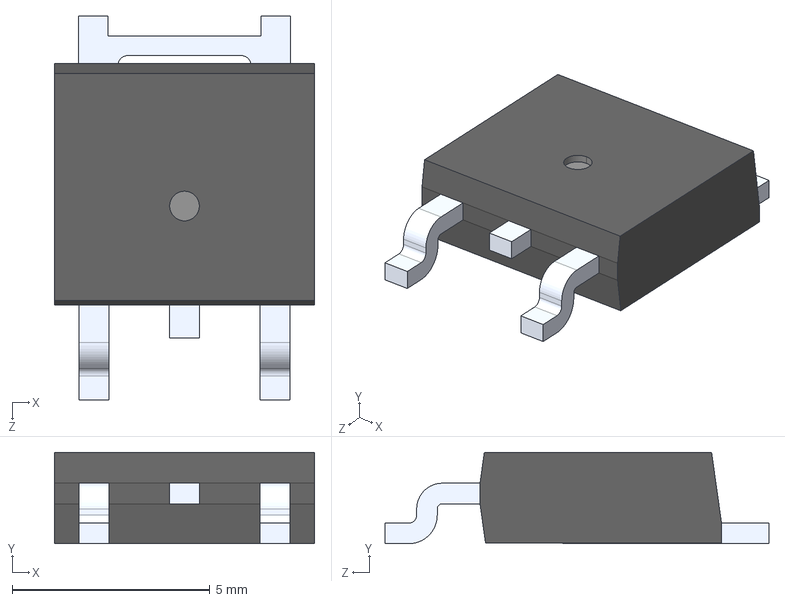
[picture p70: CAD file, 2025-06-08]
Electronic/Altium/Курсовой проект по электронике/Электроника/User Library-TO252AA.step
6.58 x 2.31 x 9.70 mm
