MSolovtsov/BachelorThesis_Manipulator/End_effector/_Print/Короб_двигателя.stl

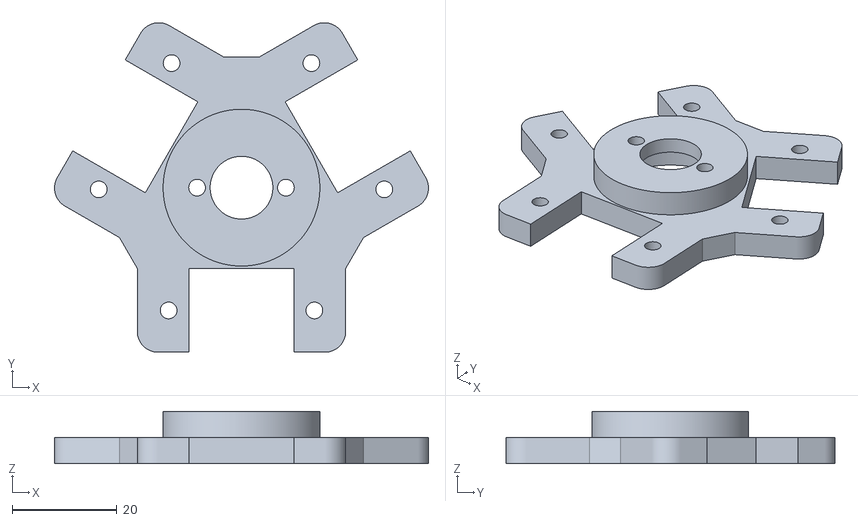
[picture p71: CAD file, 2025-03-04]
End_effector/_Print/Короб_двигателя.stl
71.6 x 63.1 x 10.0
