MSolovtsov/BachelorThesis_Manipulator/MatLab/SimModel/4_SecondLink.stp

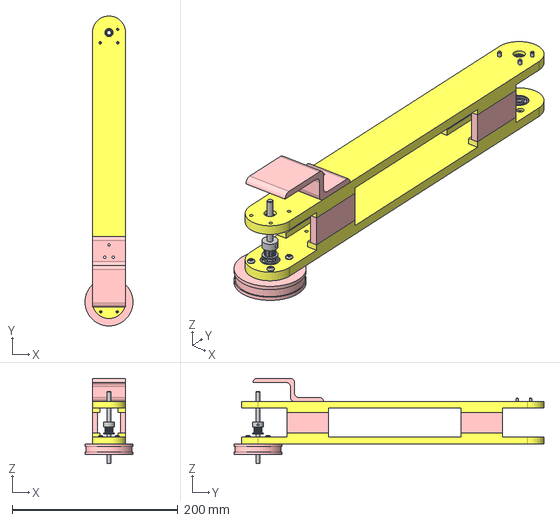
[picture p72: CAD file, 2025-05-09]
MatLab/SimModel/4_SecondLink.stp
58.0 x 374.0 x 103.0 mm
