MSolovtsov/BachelorThesis_Manipulator/Electronic/Altium/Курсовой проект по  электронике/Электроника/User Library-TO263-5.STEP

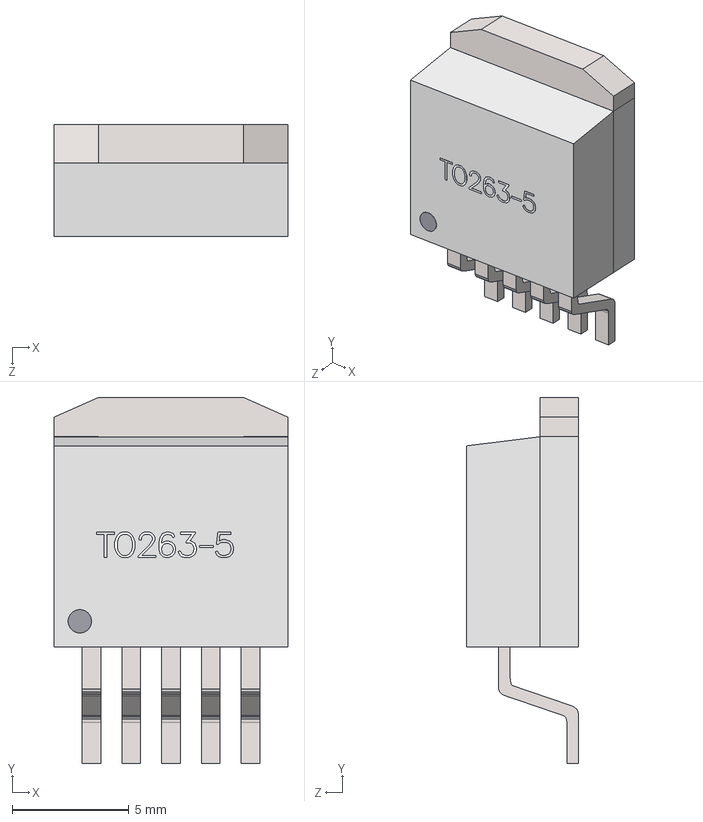
[picture p73: CAD file, 2025-06-08]
Electronic/Altium/Курсовой проект по электронике/Электроника/User Library-TO263-5.STEP
10.0 x 15.7 x 4.80 mm
Extruded17
Extruded21
Extruded19
Extruded16
Extruded11
Extruded15
Extruded18
Board5
Extruded14
Extruded20
Board9
Board8
Extruded12
Extruded13 x 5
Board7 x 5
Board6
