MSolovtsov/BachelorThesis_Manipulator/End_effector/_Print/Стойка.stl

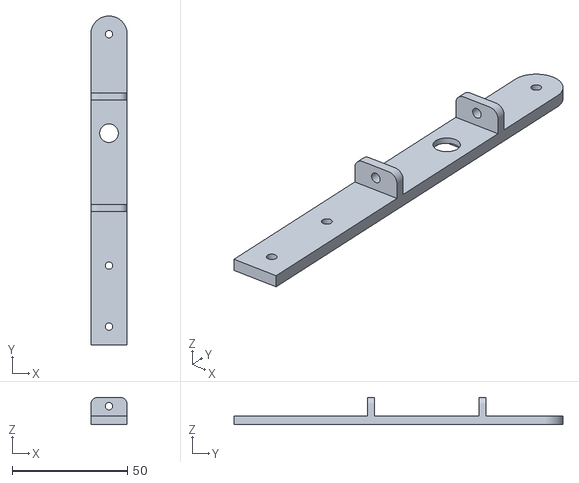
[picture p74: CAD file, 2025-03-04]
End_effector/_Print/Стойка.stl
15.8 x 142.9 x 11.8
