MSolovtsov/BachelorThesis_Manipulator/MatLab/SimModel/5_0_joint.stl

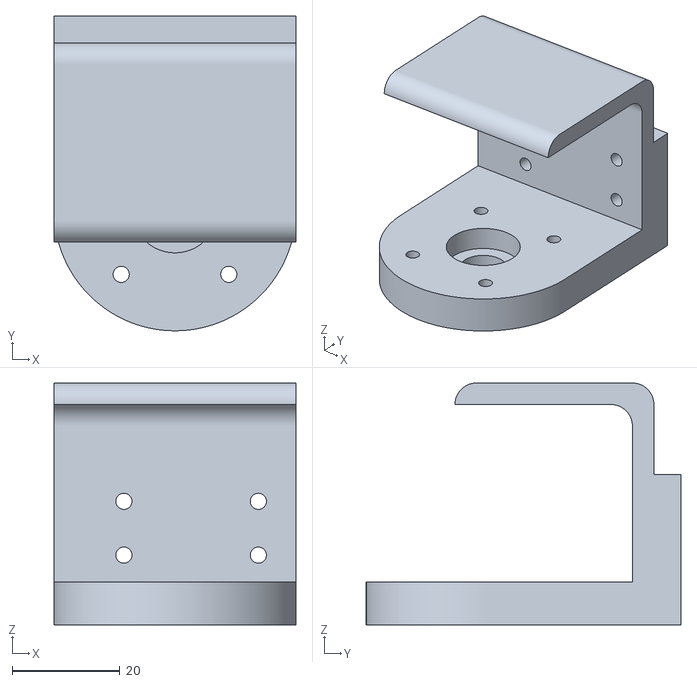
[picture p75: CAD file, 2025-05-09]
MatLab/SimModel/5_0_joint.stl
45.0 x 58.5 x 45.0
