MSolovtsov/BachelorThesis_Manipulator/End_effector/_Print/Ось_зк_стойки.stl

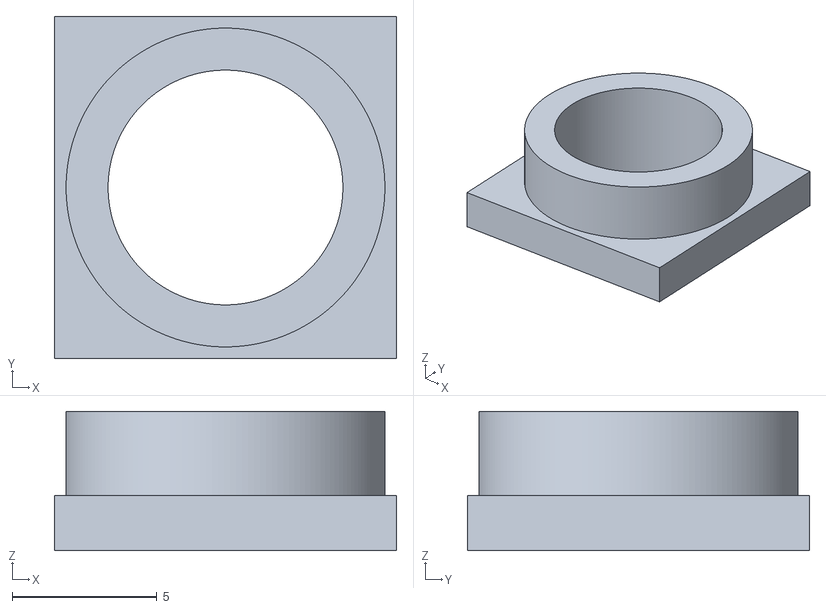
[picture p76: CAD file, 2025-03-04]
End_effector/_Print/Ось_зк_стойки.stl
11.8 x 11.8 x 4.80
