MSolovtsov/BachelorThesis_Manipulator/MatLab/SimModel/5_2_support_minor.stl

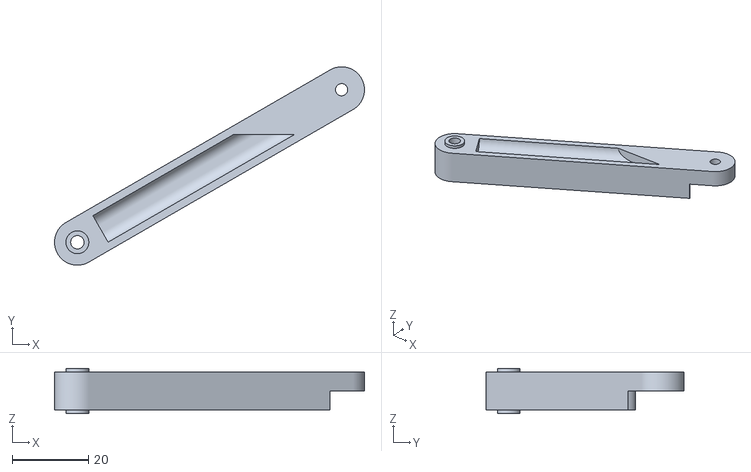
[picture p77: CAD file, 2025-05-09]
MatLab/SimModel/5_2_support_minor.stl
81.3 x 52.0 x 11.8
