MSolovtsov/BachelorThesis_Manipulator/Electronic/Altium/Курсовой проект по  электронике/Электроника/User Library-Resistor 100 Ohm 1 Watt.step

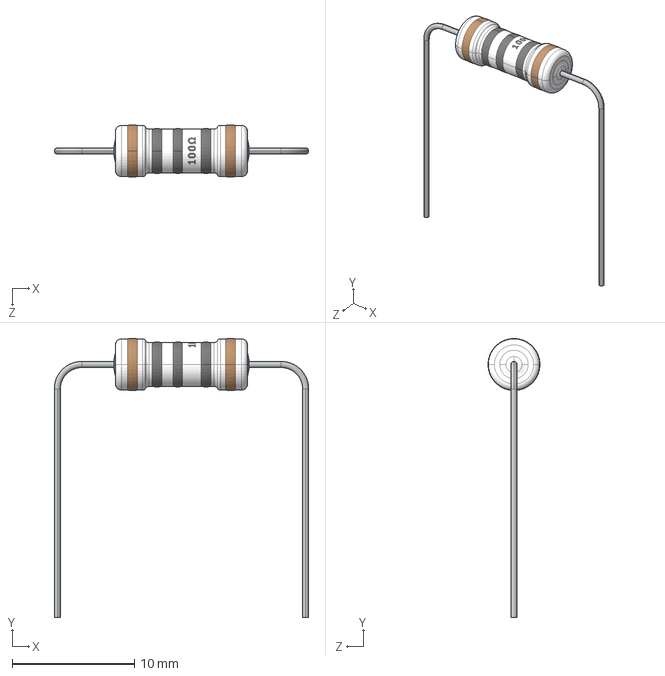
[picture p78: CAD file, 2025-06-08]
Electronic/Altium/Курсовой проект по электронике/Электроника/User Library-Resistor 100 Ohm 1 Watt.step
20.8 x 22.8 x 4.25 mm
