MSolovtsov/BachelorThesis_Manipulator/End_effector/_Print/Опора_пальца.stl

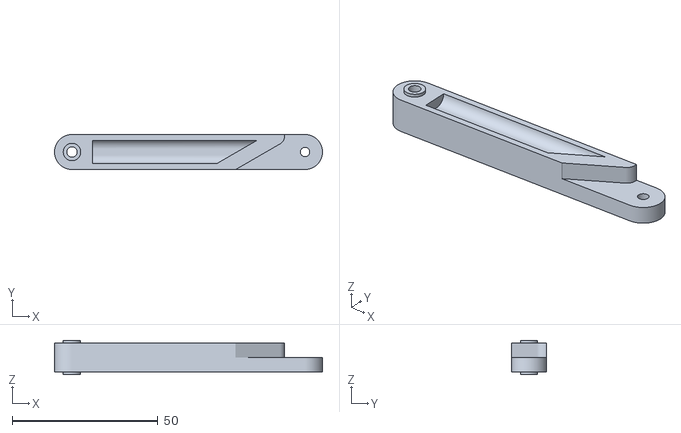
[picture p79: CAD file, 2025-03-04]
End_effector/_Print/Опора_пальца.stl
92.0 x 12.0 x 11.8
