MSolovtsov/BachelorThesis_Manipulator/Electronic/Altium/Курсовой проект по  электронике/Электроника/stm32f030k6t6.stp

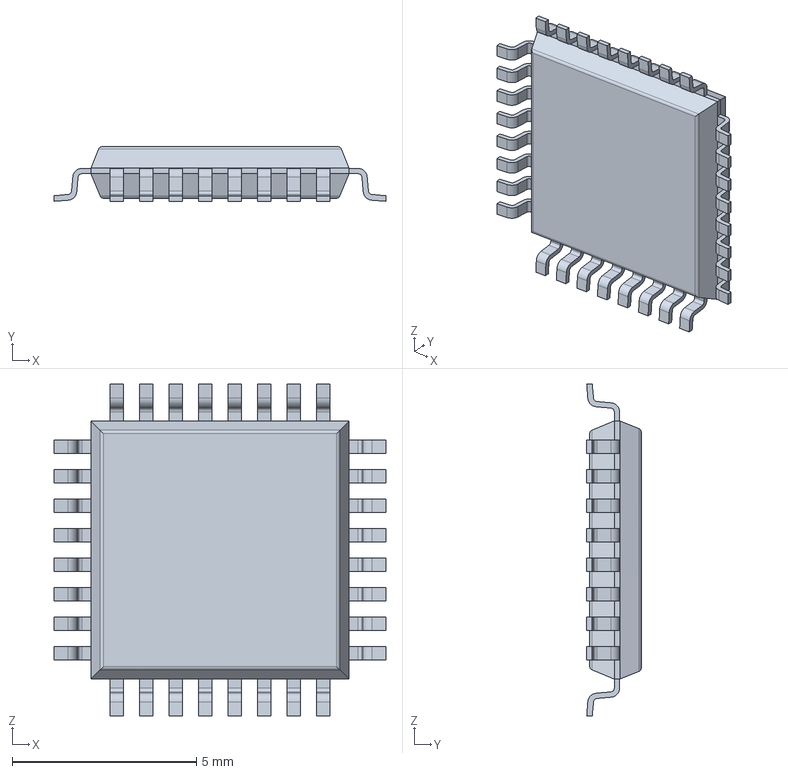
[picture p80: CAD file, 2025-06-08]
Electronic/Altium/Курсовой проект по электронике/Электроника/stm32f030k6t6.stp
9.00 x 1.48 x 9.00 mm
