MSolovtsov/BachelorThesis_Manipulator/End_effector/_Print/Основание.stl

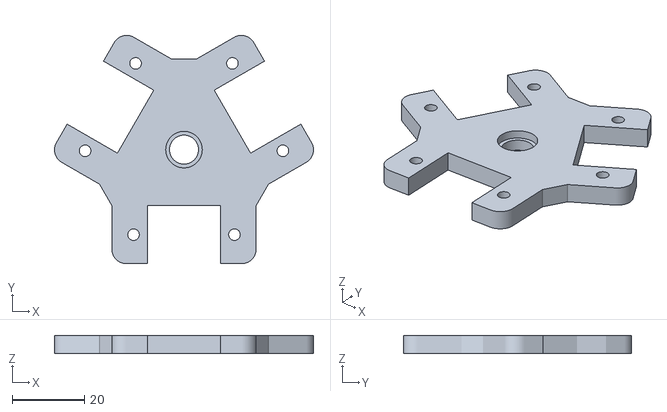
[picture p81: CAD file, 2025-03-04]
End_effector/_Print/Основание.stl
71.6 x 63.1 x 5.00
