MSolovtsov/BachelorThesis_Manipulator/Electronic/Altium/Курсовой проект по  электронике/Электроника/User Library-TO-263 5Ld.step

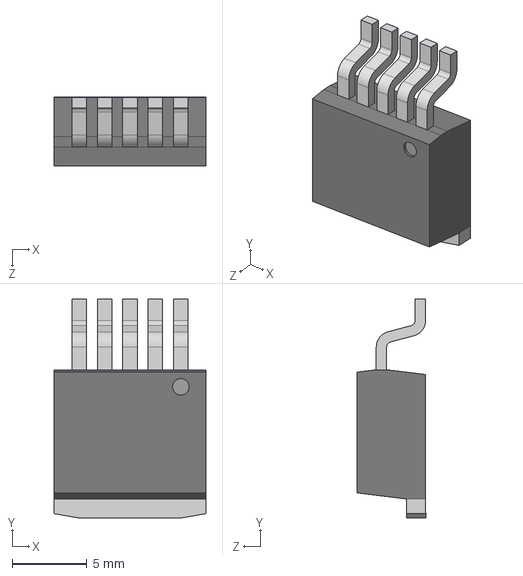
[picture p82: CAD file, 2025-06-08]
Electronic/Altium/Курсовой проект по электронике/Электроника/User Library-TO-263 5Ld.step
10.2 x 14.6 x 4.58 mm
