MSolovtsov/BachelorThesis_Manipulator/Electronic/Altium/Курсовой проект по  электронике/Электроника/User Library-KLS7-TS6601-7.STEP

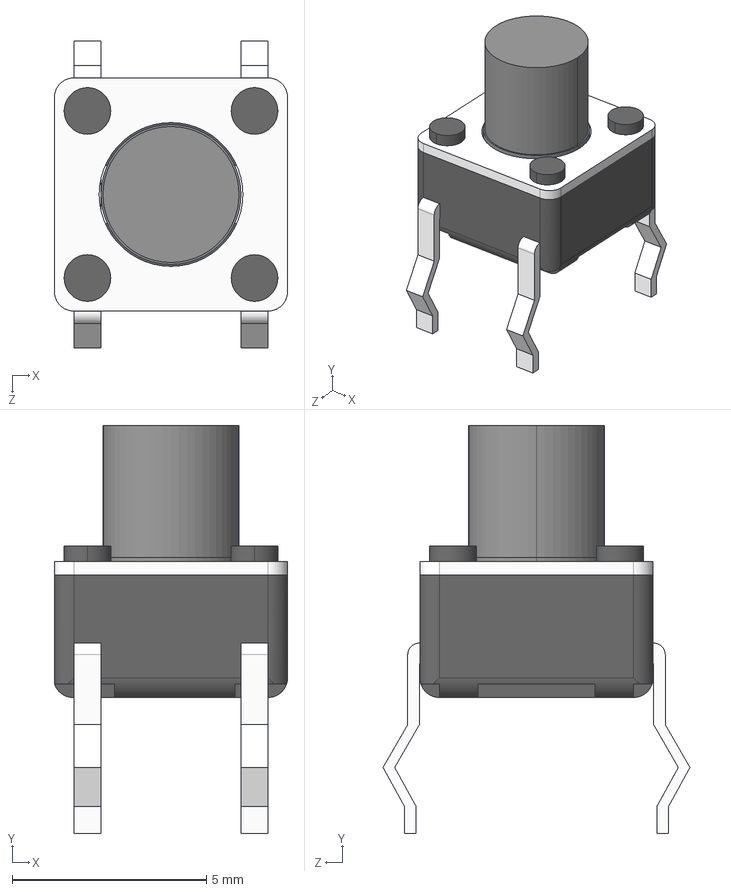
[picture p83: CAD file, 2025-06-08]
Electronic/Altium/Курсовой проект по электронике/Электроника/User Library-KLS7-TS6601-7.STEP
6.00 x 10.5 x 7.90 mm
_X2_041E0441043D043E04320430_X0_2
_X2_041A043E0440043F04430441_X0_2
_X2_041A043E043D04420430043A0442_X0_1-2
_X2_041A043E043D04420430043A0442_X0_2-2
_X2_041404380441043A_X0_
_X2_043A043D043E043F043A0430_X0_2
