MSolovtsov/BachelorThesis_Manipulator/End_effector/_Print/Вал_зубчатого_колеса.stl

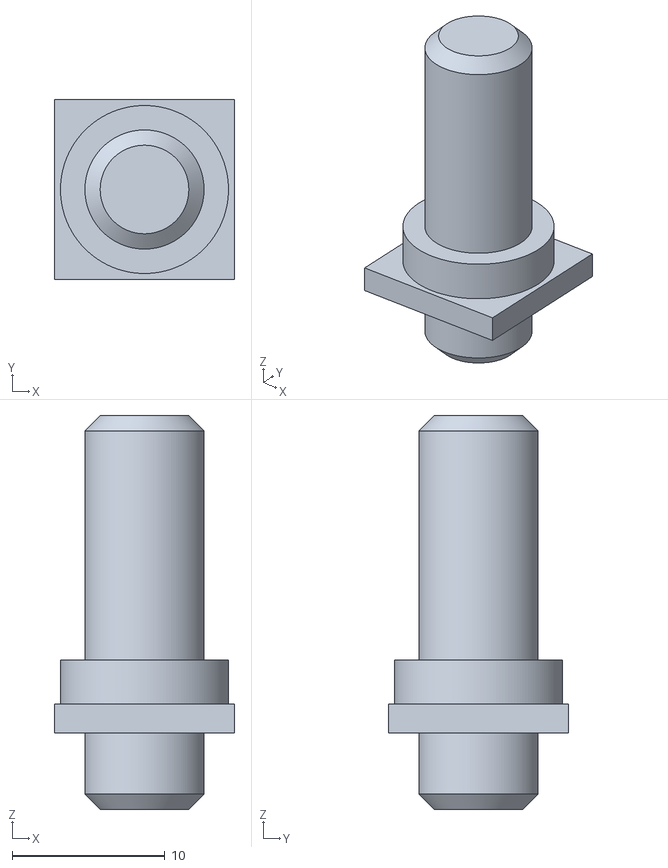
[picture p84: CAD file, 2025-03-04]
End_effector/_Print/Вал_зубчатого_колеса.stl
11.8 x 11.8 x 25.8
