MSolovtsov/BachelorThesis_Manipulator/Electronic/Altium/Курсовой проект по  электронике/Электроника/User Library-DO-214AB SMC.step

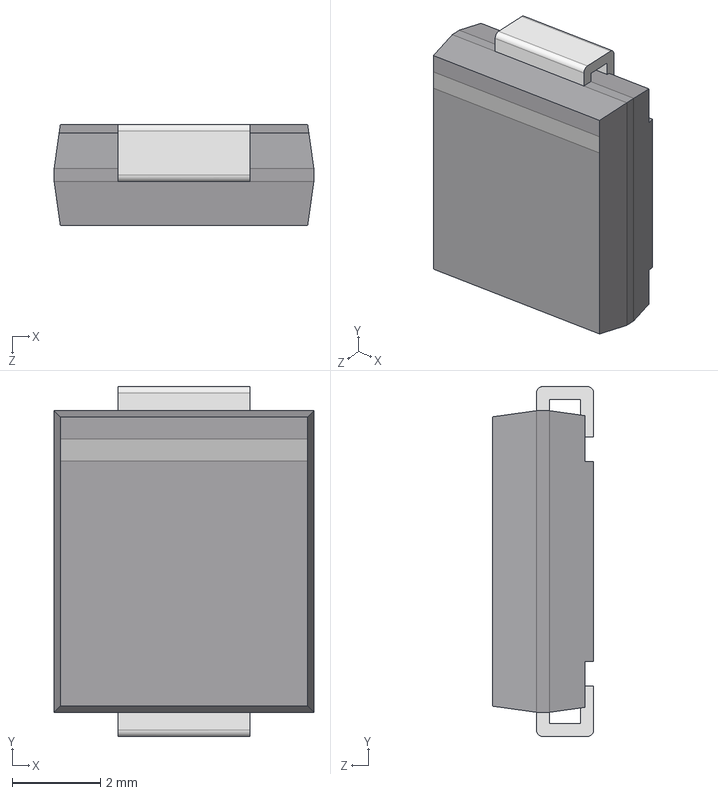
[picture p85: CAD file, 2025-06-08]
Electronic/Altium/Курсовой проект по электронике/Электроника/User Library-DO-214AB SMC.step
5.90 x 7.95 x 2.30 mm
