MSolovtsov/BachelorThesis_Manipulator/End_effector/_Print/Крышка.stl

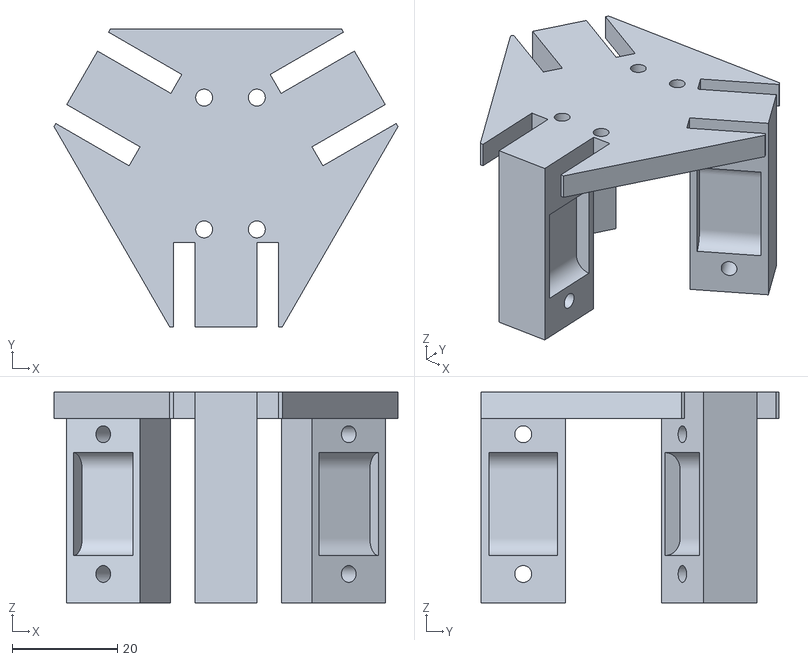
[picture p86: CAD file, 2025-03-04]
End_effector/_Print/Крышка.stl
65.2 x 56.5 x 40.0
