MSolovtsov/BachelorThesis_Manipulator/Electronic/Altium/Курсовой проект по  электронике/Электроника/User Library-SIZE CODE J16.STEP

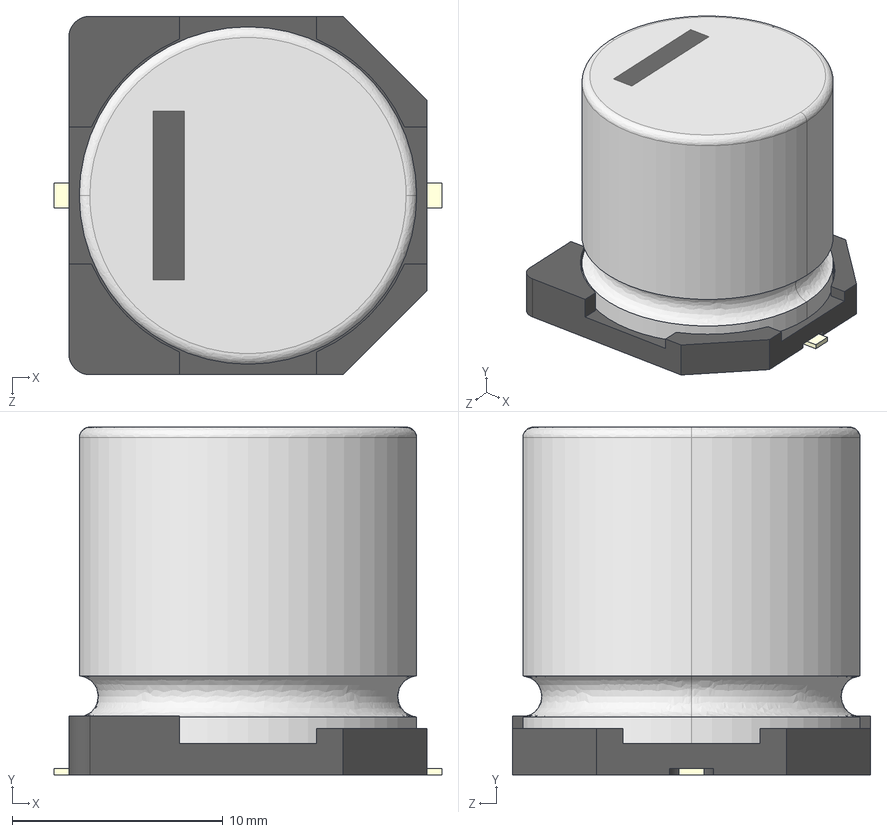
[picture p87: CAD file, 2025-06-08]
Electronic/Altium/Курсовой проект по электронике/Электроника/User Library-SIZE CODE J16.STEP
18.4 x 16.5 x 17.0 mm
•W€SIZE CODE J16-001
•W€SIZE CODE J16-002
•W€SIZE CODE J16-003 x 2
