MSolovtsov/BachelorThesis_Manipulator/(list of files, cad)

Other CAD files:
End_effector/_Print/Палец.stl
Electronic/Altium/Курсовой проект по электронике/Электроника/3546357.stp
