MSolovtsov/BachelorThesis_Manipulator/Electronic/Draws/Датчик/Принципиальная_датчика.PDF

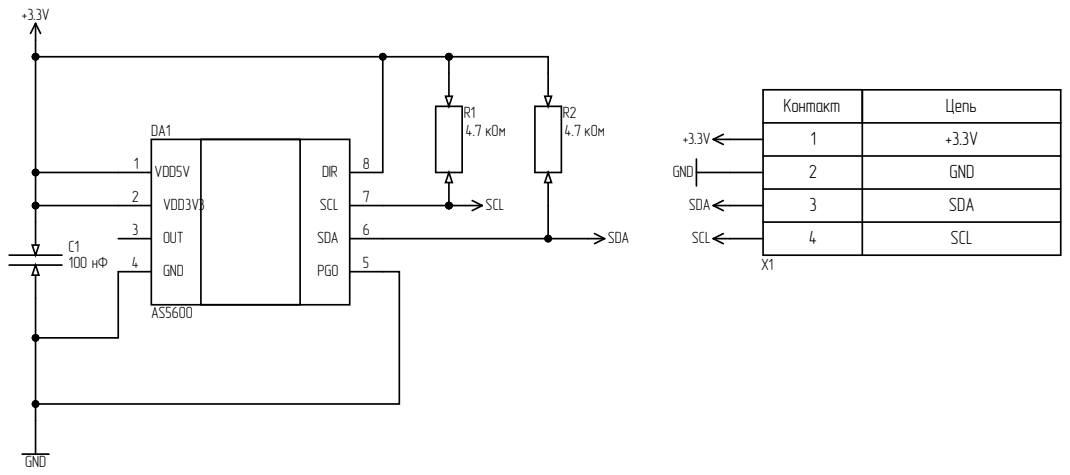
[picture p88: page 1]

Контакт | Цепь
1 | +3.3V

VDD5 V VDD3 V OU T GN D | 3 | DI R SC L SD A O

Плата датчик а положения Схема электрическая принципиаль н а я | Лит . | Масса | Масш .

Из м | Лист | № докум . | Подп . | Дата
Разра б | | Соловцов М . А .
Пров . | | Бошляков А . А
Т . контр . | | | | | Лист 1 | Листов

МГТУ им. Н . Э. Баумана группа СМ7-71 Б

Н . конт р
Утв .
