MSolovtsov/BachelorThesis_Manipulator/Electronic/Draws/Плата/Принципиальная_платы.PDF

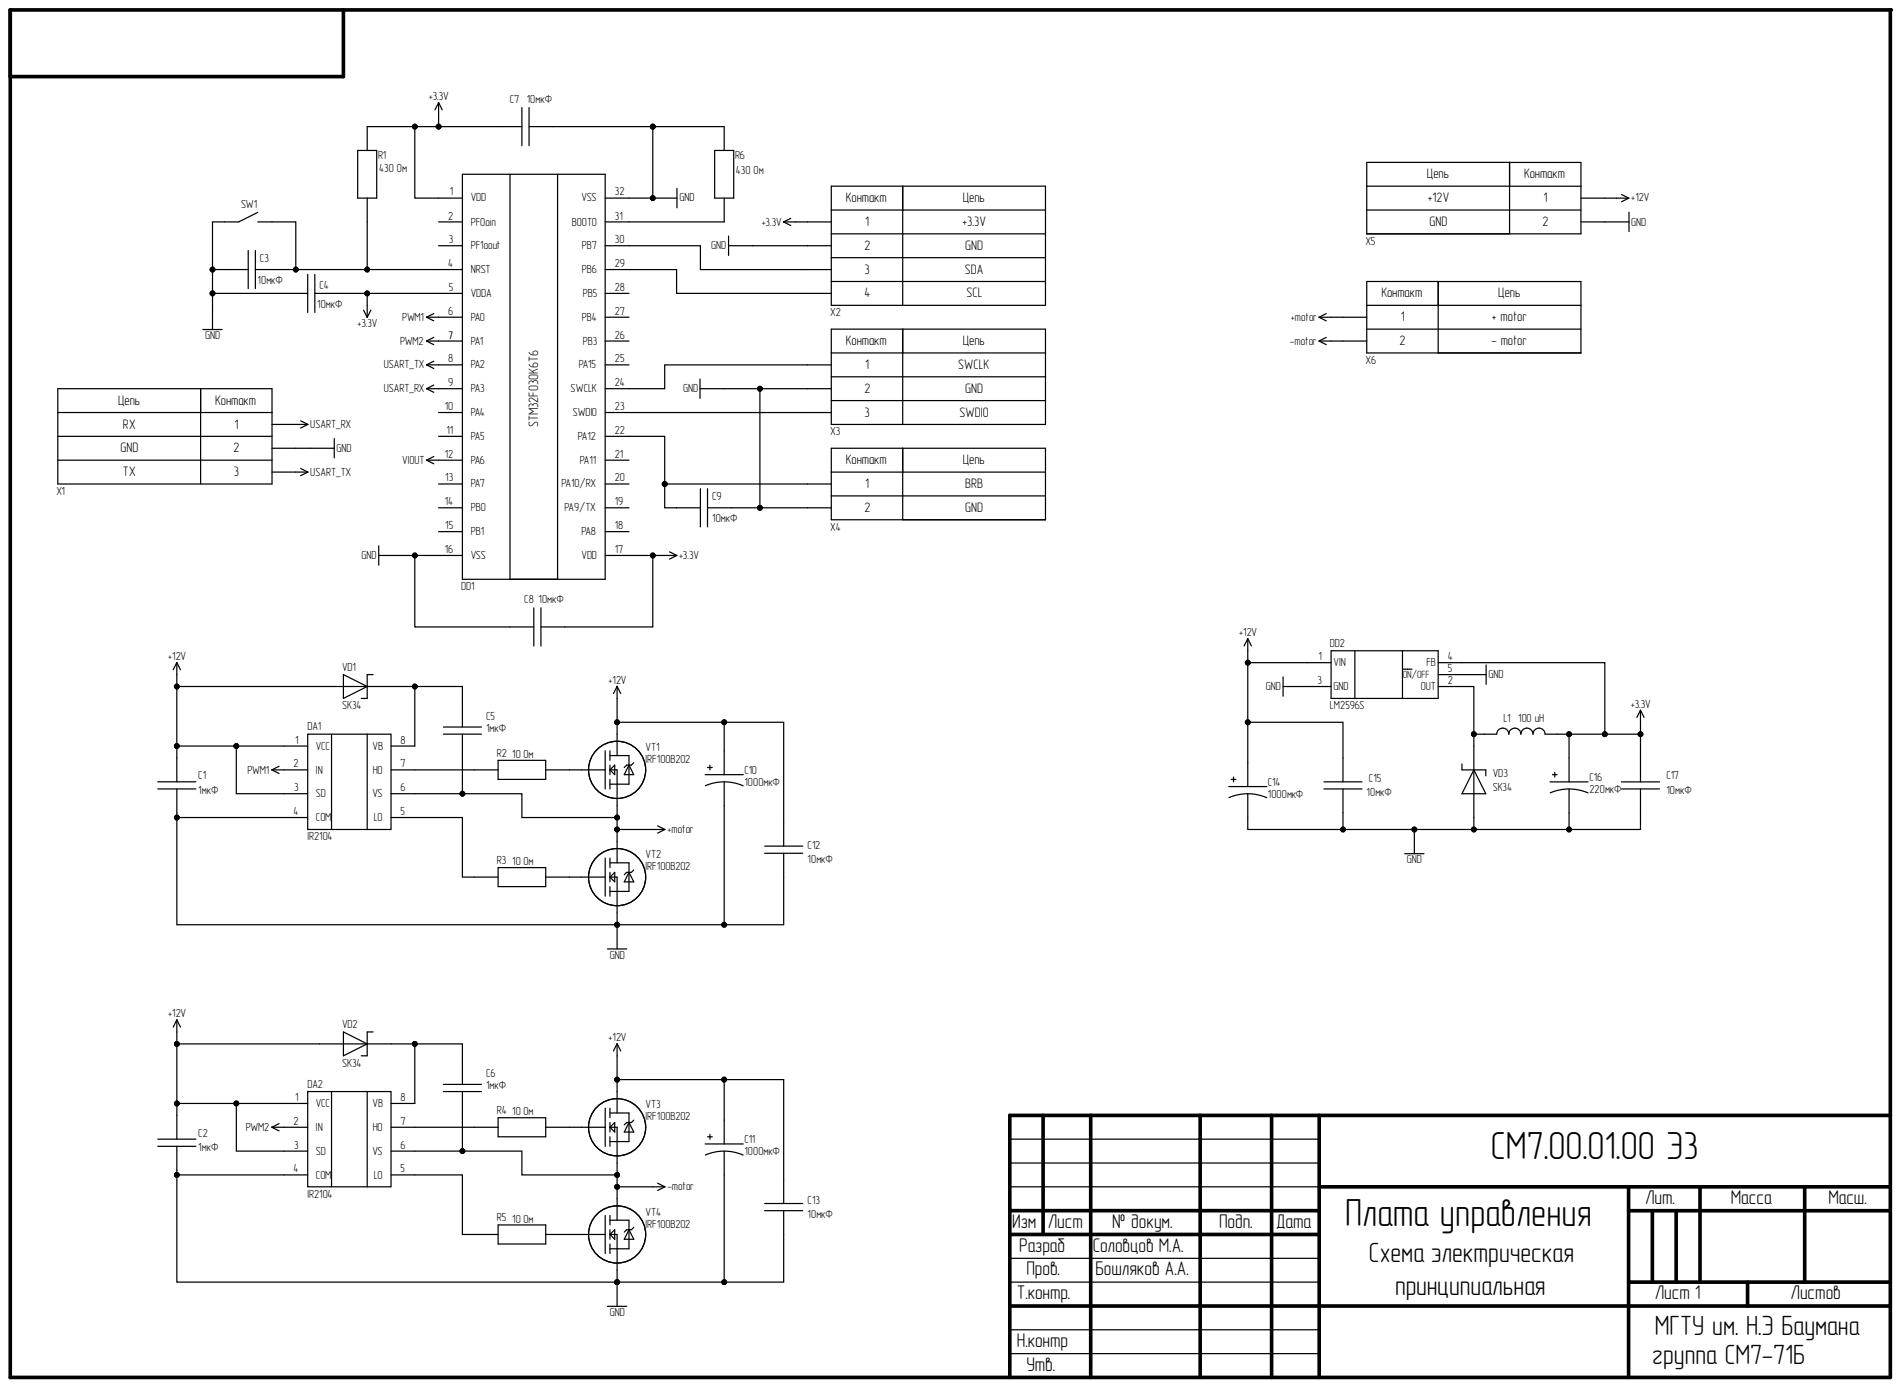
[picture p89: page 1]

2 | SDA 4 GND 3 SCL

Контакт | Цепь

7 P W M 2 8 USART_ T X 9 | 2 7

1 | SWCL K
2 | SWDIO GND 3

1 | BRB 2 GND

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

Н . конт р
Утв .
