MSolovtsov/BachelorThesis_Manipulator/Electronic/Altium/Курсовой проект по  электронике/Электроника/Гарбич/Sensor_plate.pdf

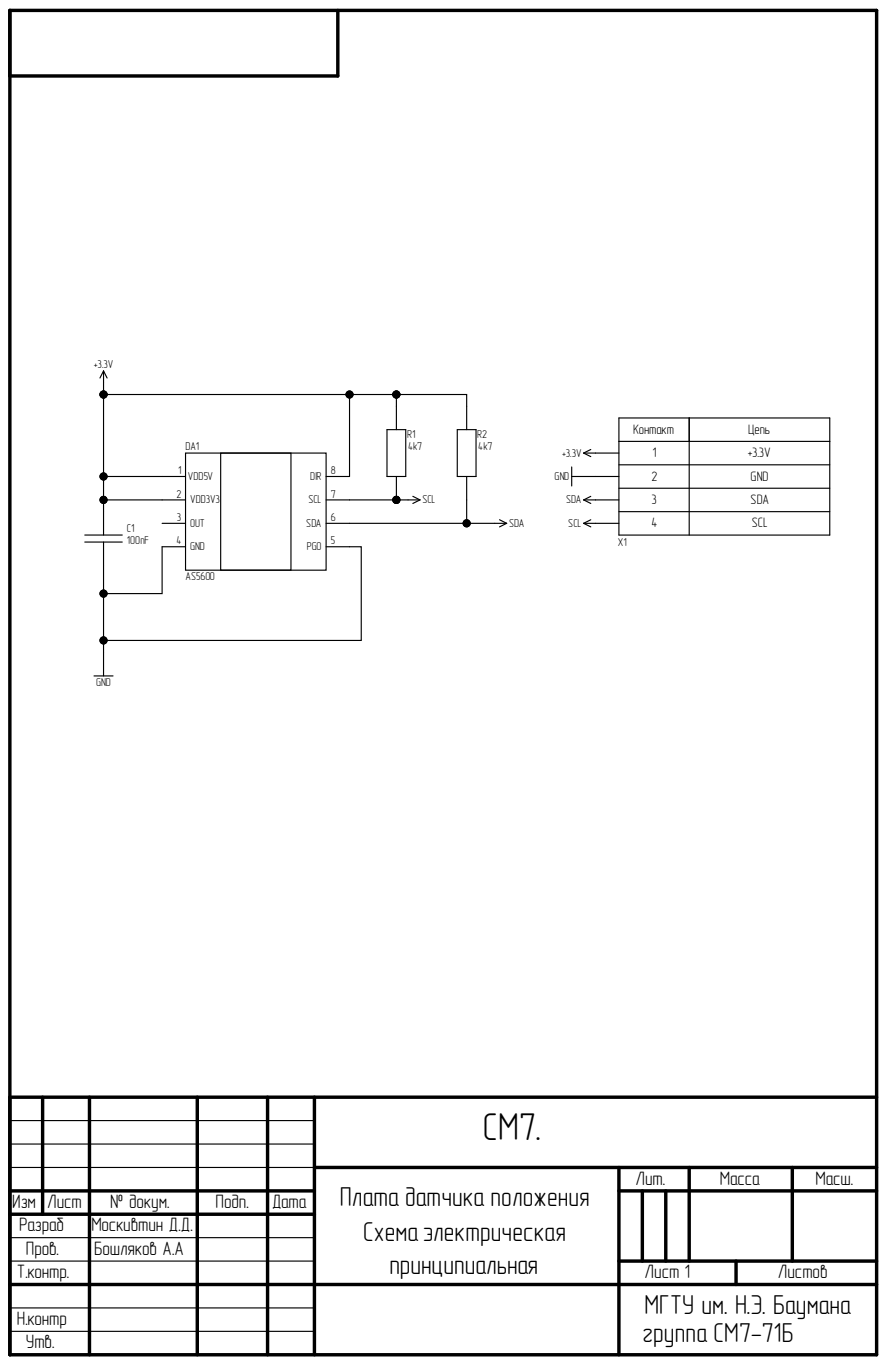
[picture p90: page 1]

К о нта к т | Ц е п ь

V D D 5 V V D D3V 3 O U T G N D | D I R S C L S D A P G O

Плата датчик а положения Схема электрическая принципиал ь н а я | Лит . | Масса | Масш .

Из м | Лист | № докум . | Подп . | Дата
Разраб | | Москивтин Д . Д .
Пров . | | Бошляков А . А
Т . контр . | | | | | Лист 1 | Листов

МГТУ им. Н . Э. Баумана группа СМ7-71 Б

Н . контр
Утв .
