MSolovtsov/BachelorThesis_Manipulator/Electronic/Altium/Курсовой проект по  электронике/Электроника/Гарбич/test.pdf

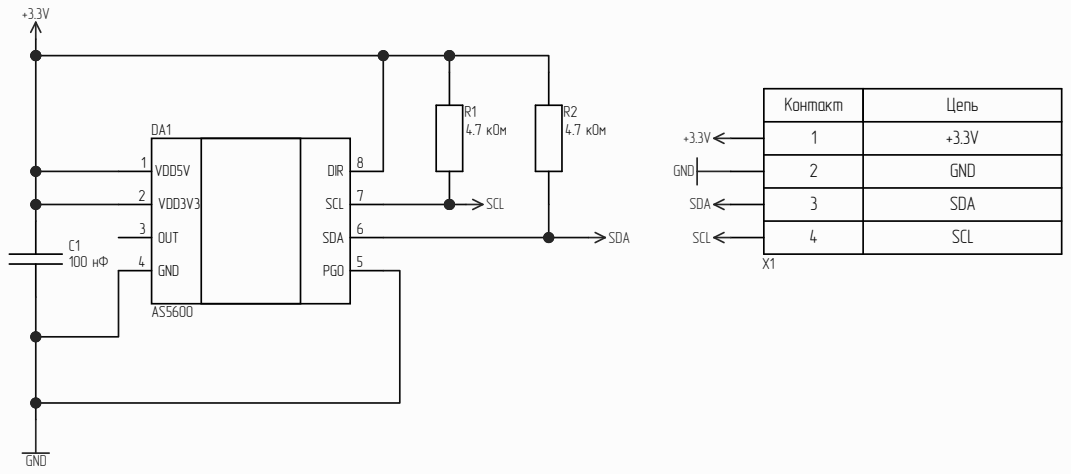
[picture p91: page 1]
VDD5V 1; VDD3V3 2; OUT 3; GND 4; PGO 5; SDA 6; SCL 7; DIR 8; 4.7 кОм; GND; SDA; SCL

Контакт | Цепь
1 +3.3V
2 GND
3 SDA
4 SCL

Плата датчик положения Схема электрическая принципиальная | Лит. | Масса | Масш.

Изм | Лист | № докум. | Подп. | Дата
Разраб | | Москивтин Д.Д.
Пров. | | Бошляков А.А
Т.контр. | | | | | Лист 1 | Листов

МГТУ им. Н.Э. Баумана группа СМ7-71Б

Н.контр
Утв.
