MSolovtsov/BachelorThesis_Manipulator/Electronic/Altium/Курсовой проект по  электронике/Электроника/Печать/плата упр принцип.pdf

# VSS CPU 32 STM³²F0³0K6T6

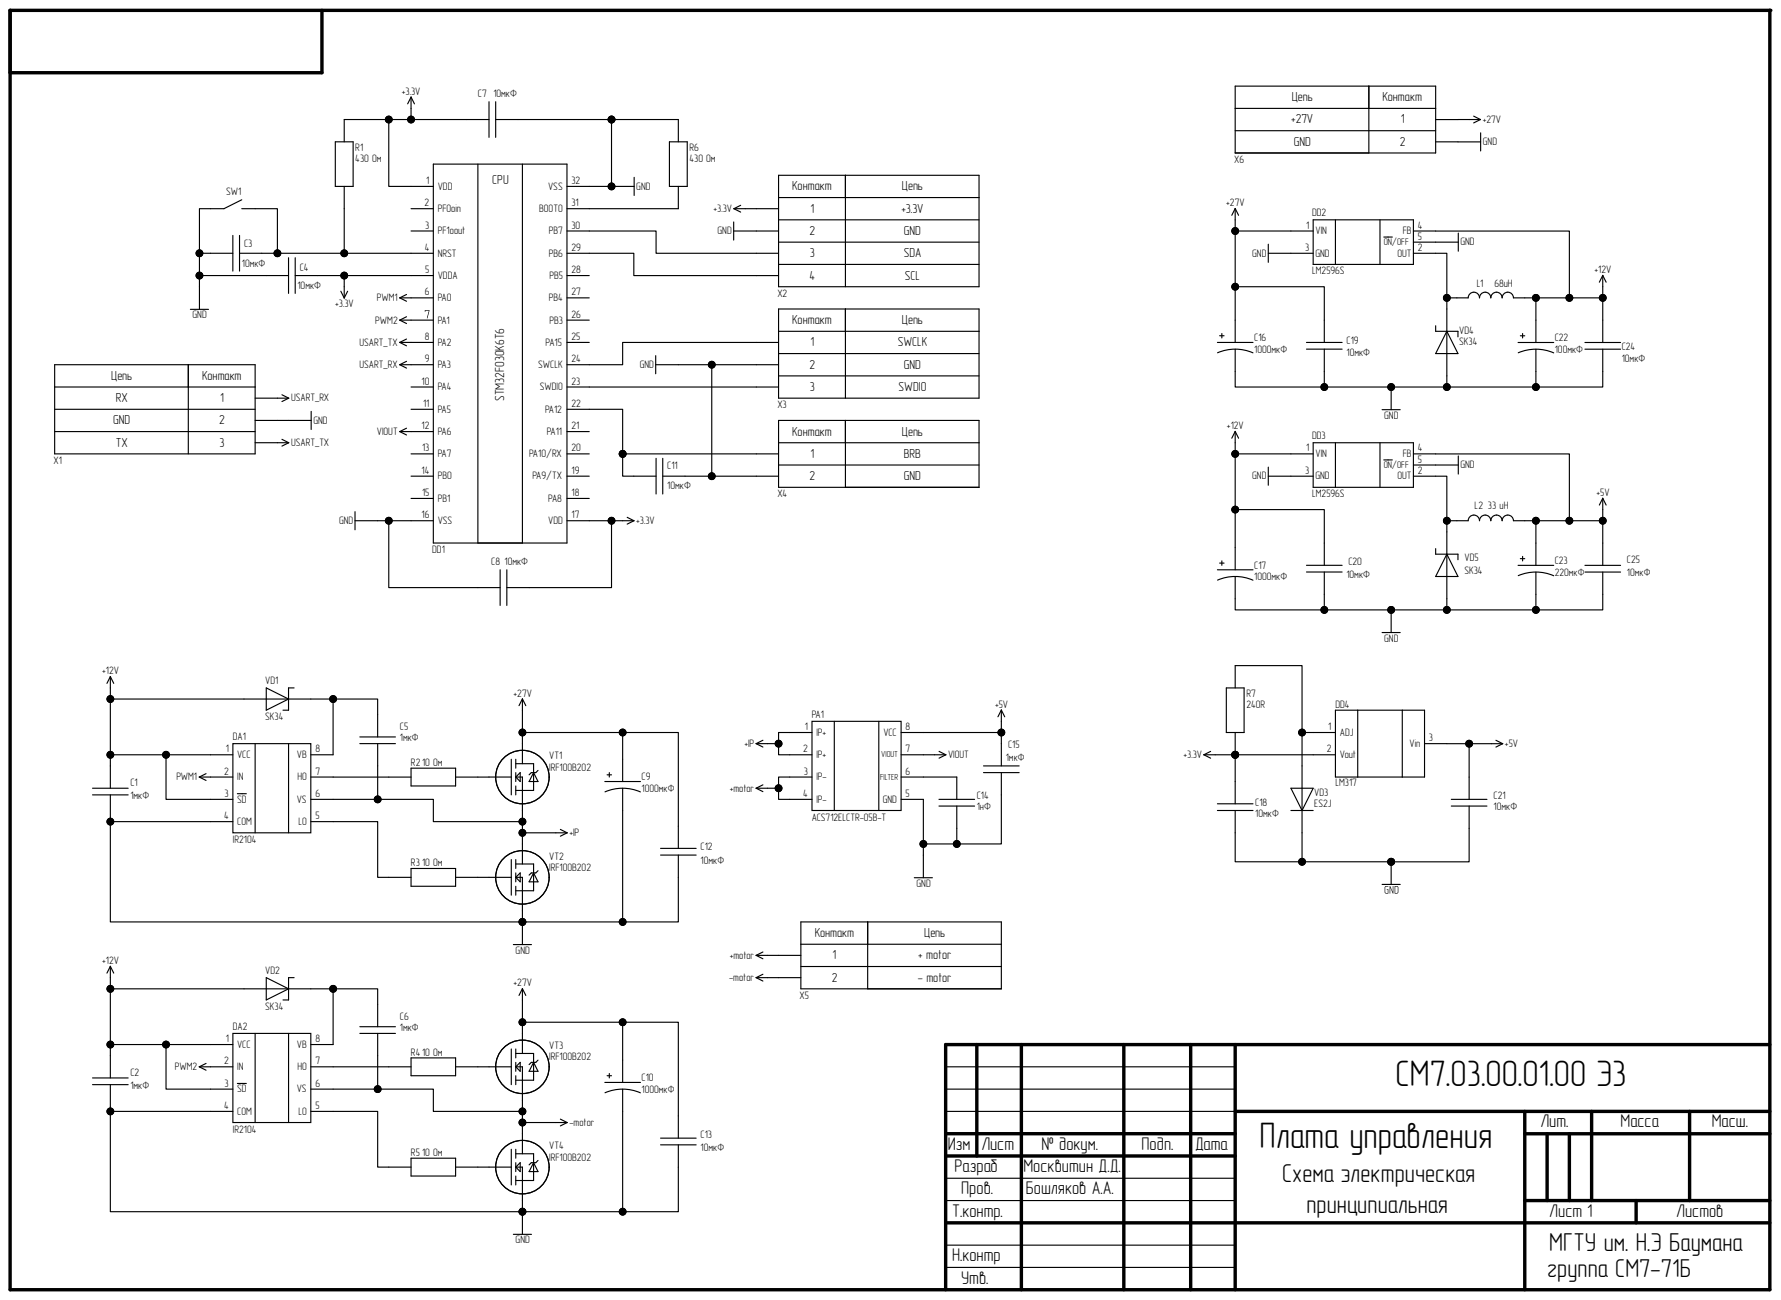
[picture p92: page 1]

Цепь | Контакт
+27V | 1
GND | 2

Контакт | Цепь
1 +3.3V

1 SWCLK
2 GND
3 SWDIO

1 + motor
2 - motor

Плата управления Схема электрическая принципиальная | Лит. | Масса | Масш.

Изм | Лист | № докум. | Подп. | Дата
Разраб | | Москвитин Д.Д.
Пров. | | Бошляков А.А.
Т.контр. | | | | | Лист 1 | Листов

МГТУ им. Н.Э Баумана группа СМ7-71Б

Н.контр
Утв.
