MSolovtsov/BachelorThesis_Manipulator/Electronic/Draws/Плата/плата упр сб.PDF

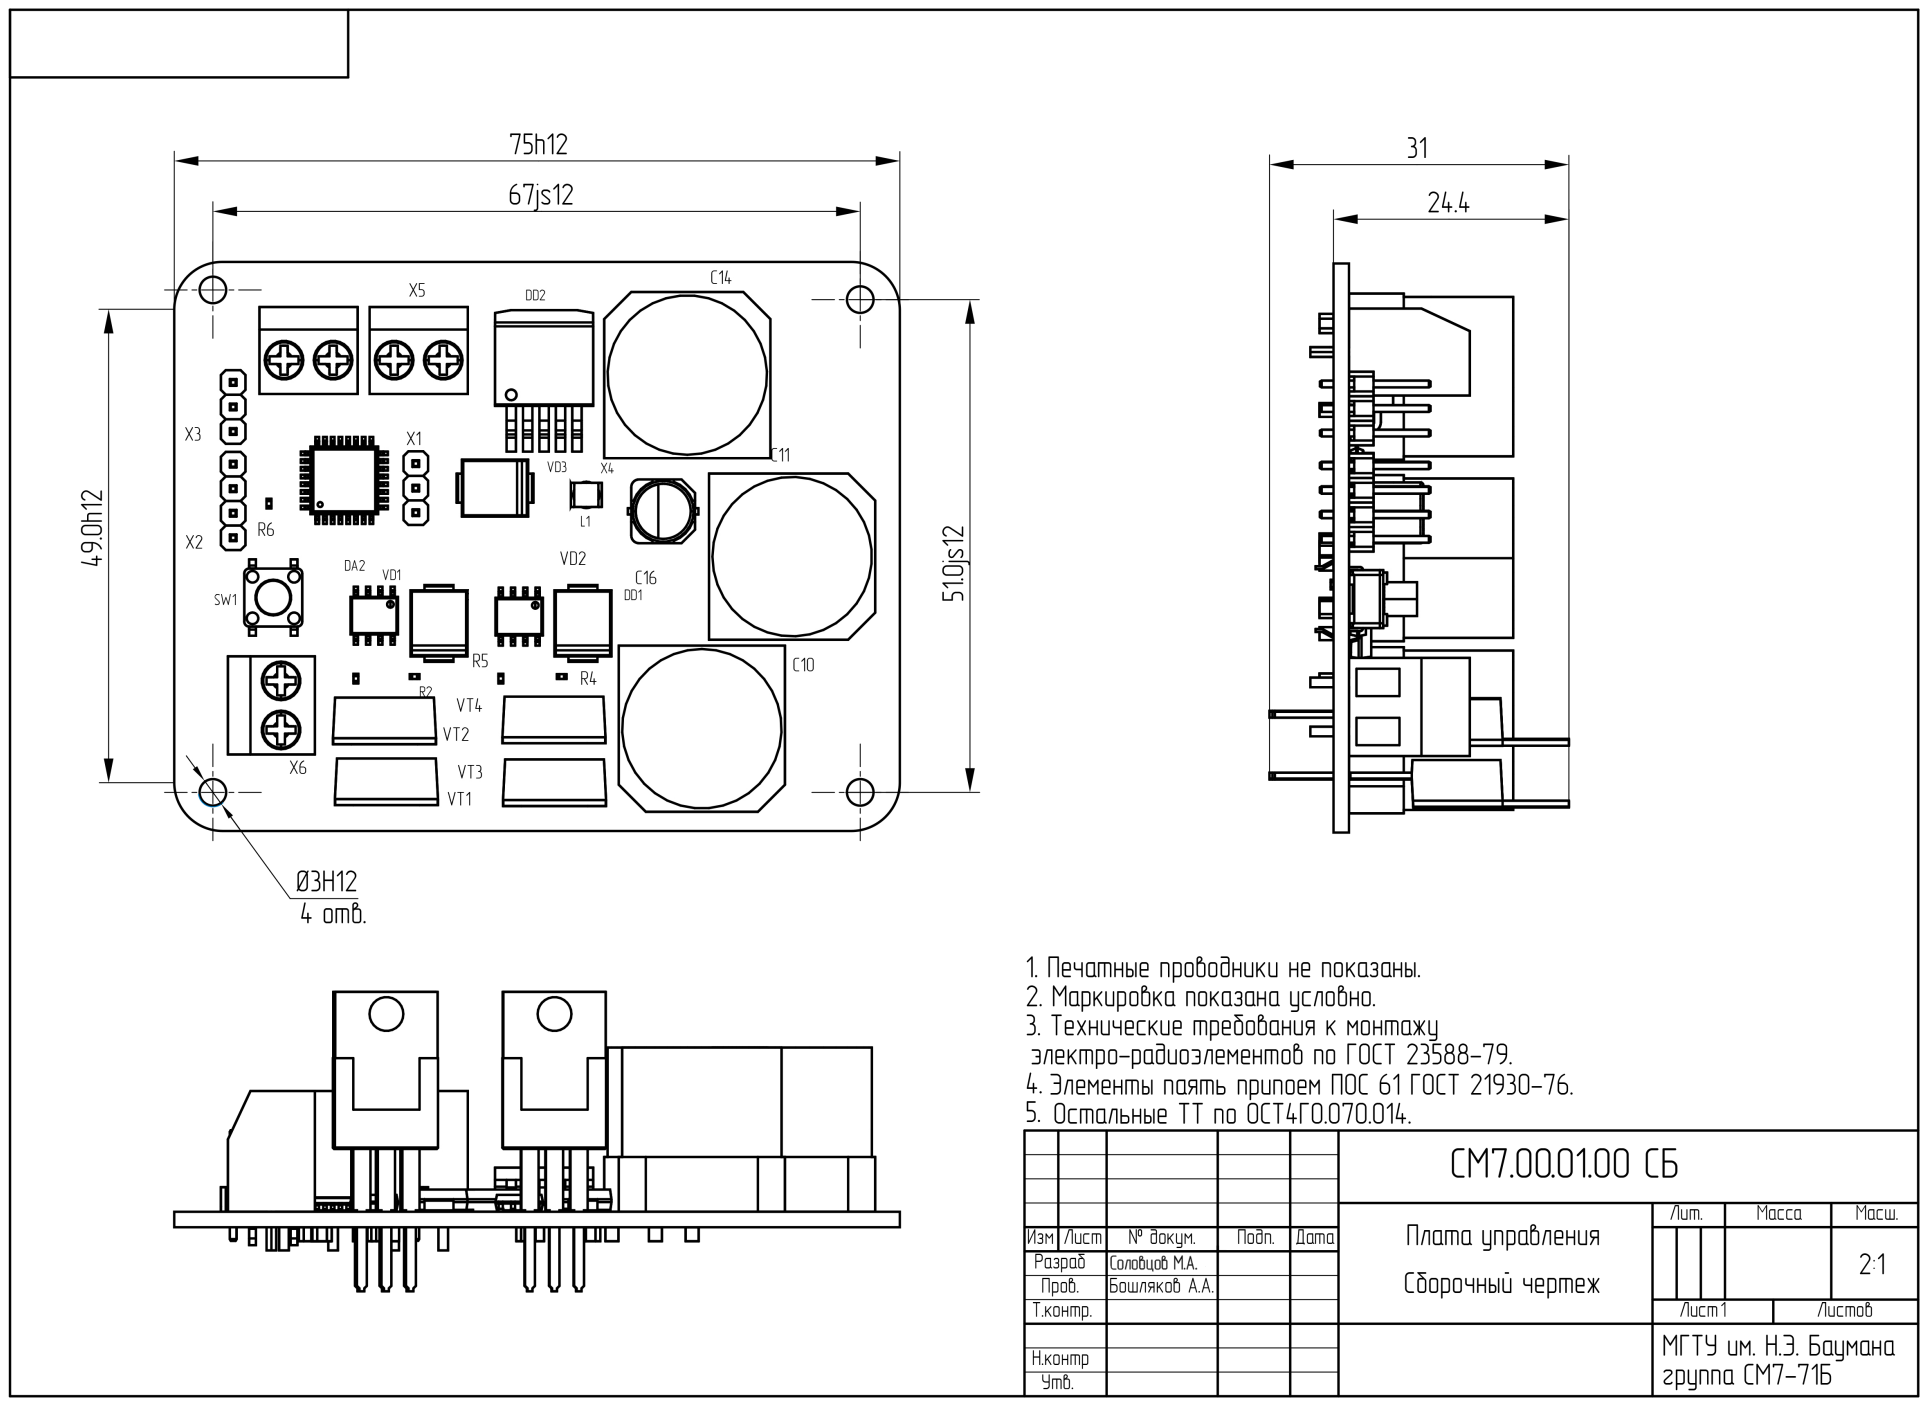
[picture p93: page 1]
