MSolovtsov/BachelorThesis_Manipulator/Electronic/Draws/Плата/плата упр трас.PDF

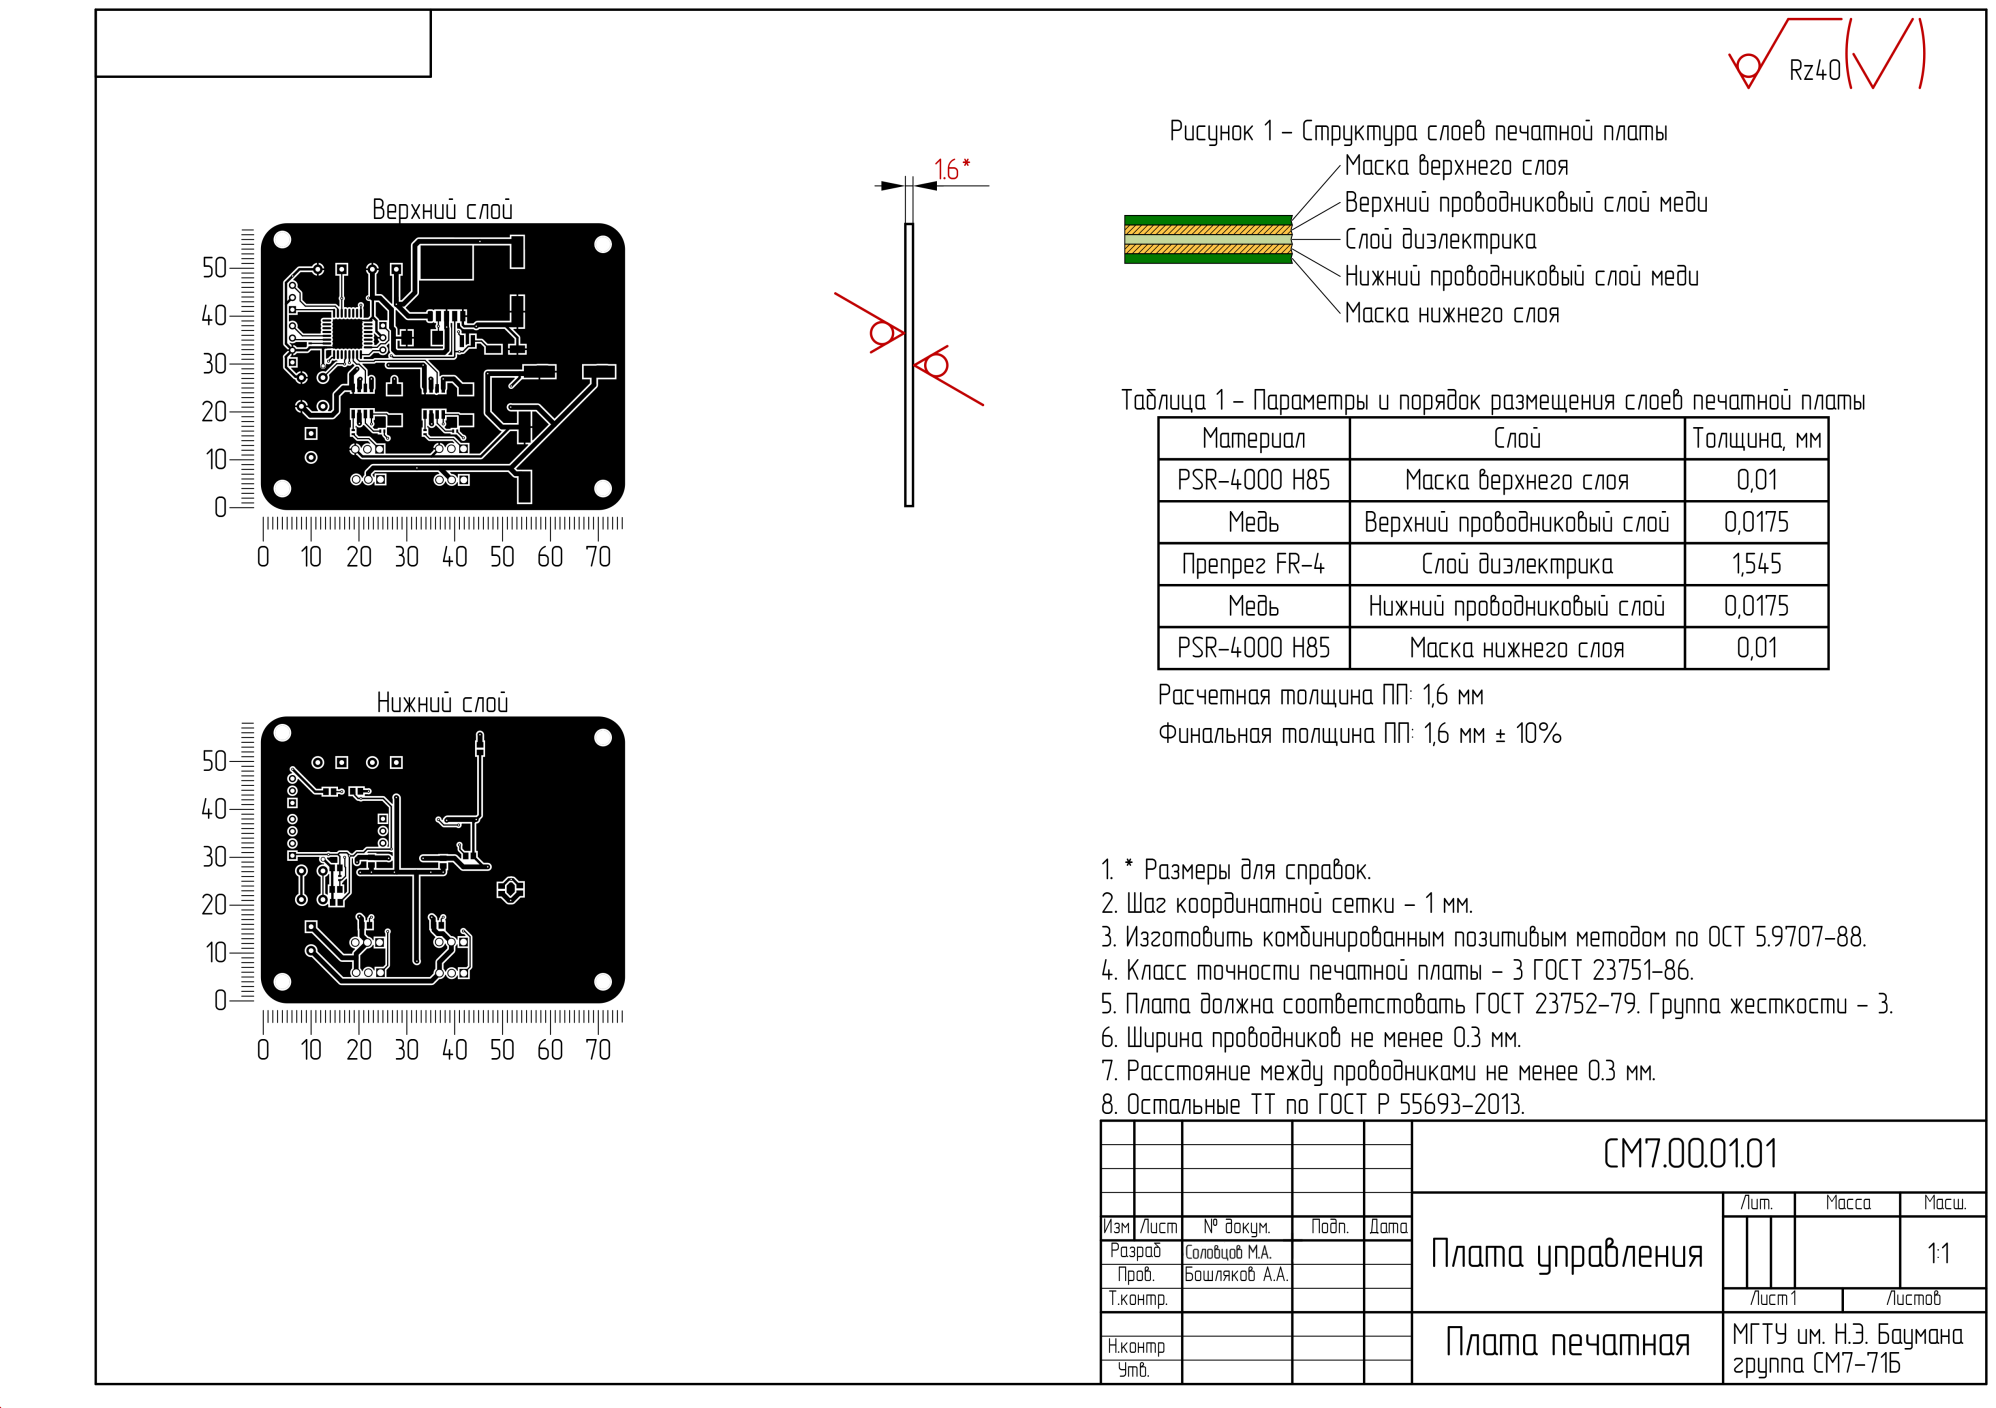
[picture p94: page 1]
