MSolovtsov/BachelorThesis_Manipulator/Electronic/Altium/Курсовой проект по  электронике/Электроника/Гарбич/Base_plate.pdf

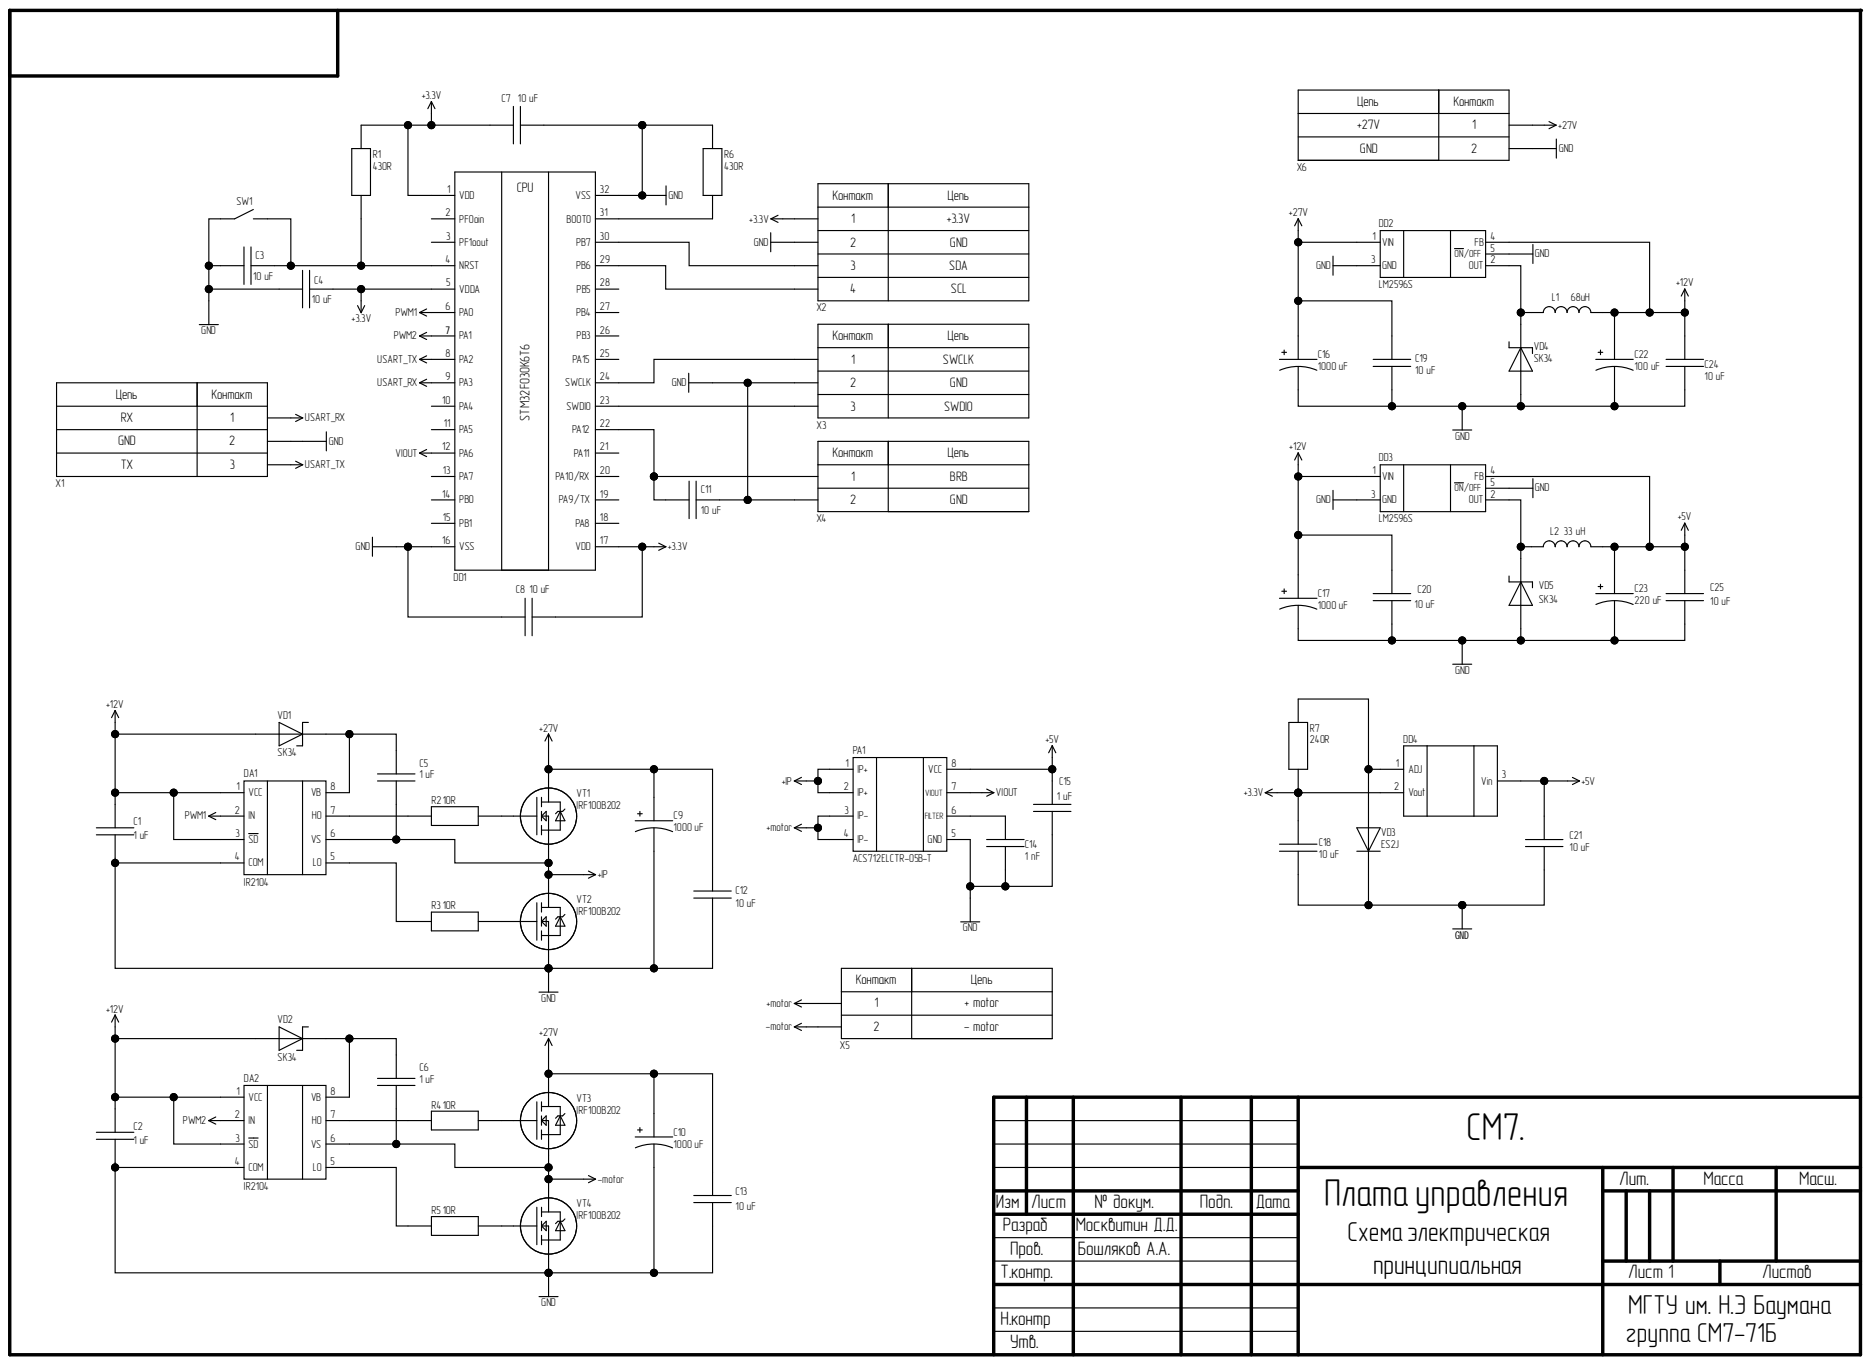
[picture p95: page 1]

Ц е п ь | К о нта к т

К о нта к т | Ц е п ь

1 | S W CLK

1 | + moto r

2 | - moto r

Из м | Лист | № докум . | Подп . | Дата
Разраб | | Москвитин Д . Д .
Пров . | | Бошляков А . А .
Т . контр . | | | | | Лист 1 | Листов

МГТУ им. Н . Э Баумана группа СМ7-71 Б

Н . контр
Утв .
