MSolovtsov/BachelorThesis_Manipulator/Electronic/Altium/Курсовой проект по  электронике/Электроника/Гарбич/SB_base.pdf

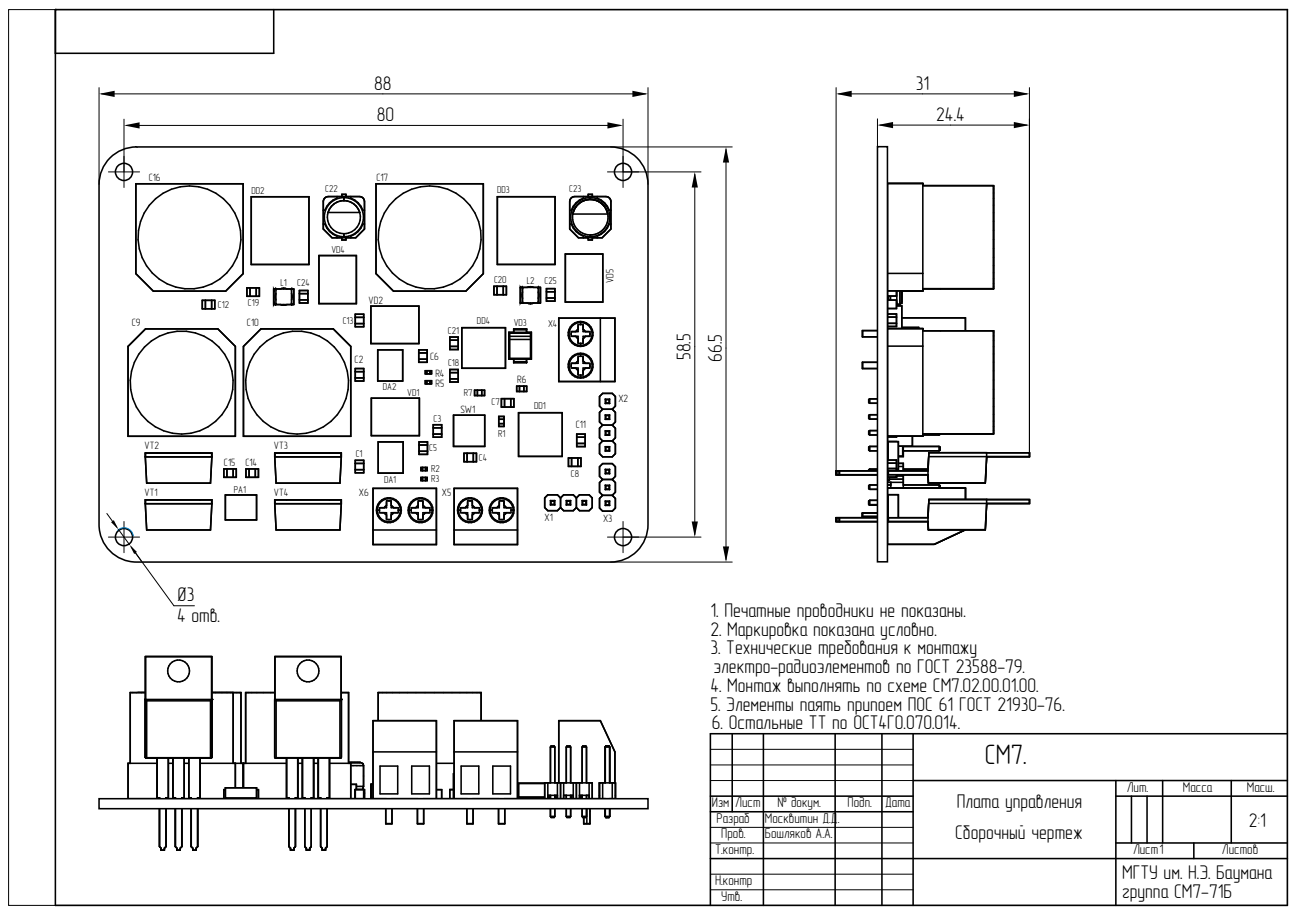
[picture p96: page 1]

1. Печатные проводники не показаны.
2. Маркировка показана условно.
3. Технические требования к монтажу
электро-радиоэлементов по ГОСТ 23588-79.
4. Монтаж выполнять по схеме СМ7.02.00.01.00.
5. Элементы паять припоем ПОС 61 ГОСТ 21930-76.
6. Остальные ТТ по ОСТ4Г0.070.014.
