MSolovtsov/BachelorThesis_Manipulator/Electronic/Altium/Курсовой проект по  электронике/Электроника/Гарбич/Tras_base.pdf

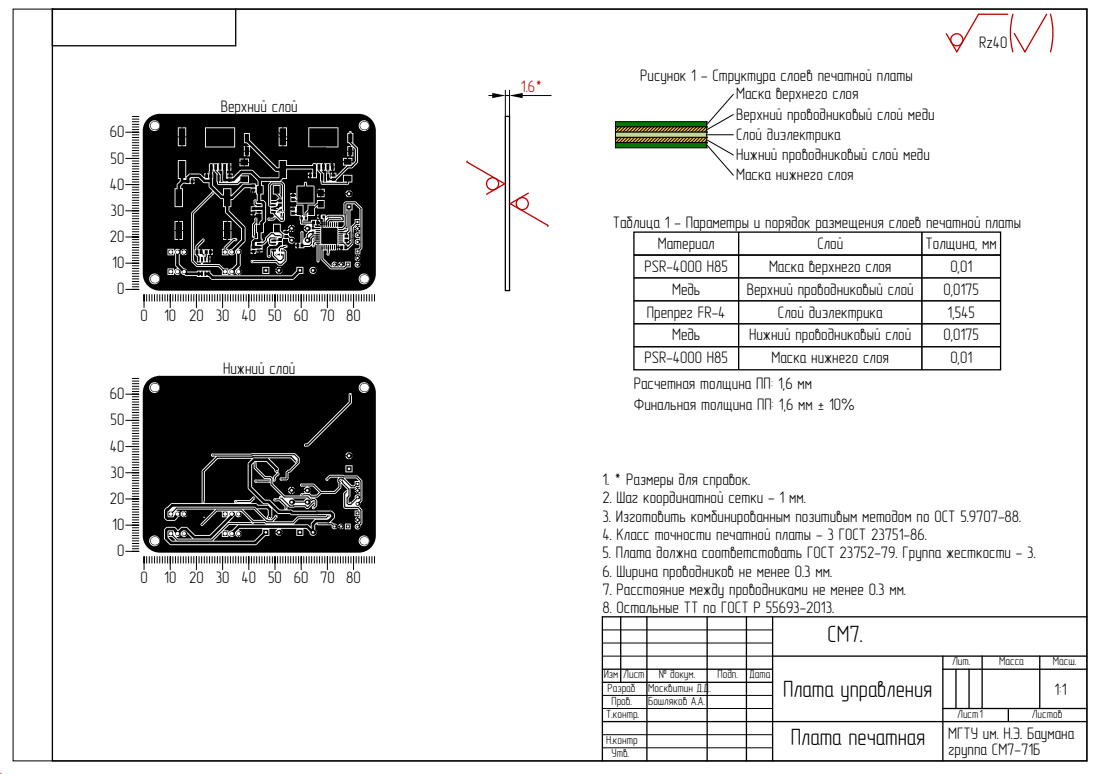
[picture p97: page 1]
Верхний слой; Нижний слой; Толщина, мм 0,01 0,0175 1,545 0,0175 0,01

Рисунок 1 - Структура слоев печатной платы

Маска верхнего слоя
Верхний проводниковый слой меди
Слой диэлектрика
Нижний проводниковый слой меди
Маска нижнего слоя

Таблица 1 - Параметры и порядок размещения слоев печатной платы
Материал
PSR-4000 H85
Медь
Препрег FR-4
Расчетная толщина ПП: 1,6 мм
Финальная толщина ПП: 1,6 мм ± 10%

Слой
Верхний проводниковый слой
Нижний проводниковый слой

1. * Размеры для справок.
2. Шаг координатной сетки - 1 мм.
3. Изготовить комбинированным позитивым методом по ОСТ 5.9707-88.
4. Класс точности печатной платы - 3 ГОСТ 23751-86.
5. Плата должна соответстовать ГОСТ 23752-79. Группа жесткости - 3.
6. Ширина проводников не менее 0.3 мм.
7. Расстояние между проводниками не менее 0.3 мм.
8. Остальные ТТ по ГОСТ Р 55693-2013.

Плата управления | Лит. | Масса | Масш.

Изм | Лист | № докум. | Подп. | Дата | | | | | 1:1
Разраб | | Москвитин Д.Д.
Пров. | | Бошляков А.А.
Т.контр. | | | | | Лист 1 | Листов

Плата печатная | МГТУ им. Н.Э. Баумана группа СМ7-71Б

Н.контр
Утв.
