MSolovtsov/BachelorThesis_Manipulator/(list of files, drawings)

Other design files:
Electronic/Altium/CourseProject/CourseProject.PrjPcb
Electronic/Altium/CourseProject/PCB1.PcbDoc
Electronic/Altium/CourseProject/Sheet1.SchDoc
Electronic/Altium/Курсовой проект по электронике/Электроника/AD_GOST/Examples/BaseDimmer/BaseDimmerBoard.SchDoc
Electronic/Altium/Курсовой проект по электронике/Электроника/AD_GOST/Examples/BaseDimmer/╨Р╨С╨Т╨У.201905.010.PcbDoc
Electronic/Altium/Курсовой проект по электронике/Электроника/AD_GOST/Examples/BaseDimmer/╨Р╨С╨Т╨У.201905.100.PrjPcb
Electronic/Altium/Курсовой проект по электронике/Электроника/AD_GOST/Examples/MiniPC MB GOST/Clock group.SchDoc
Electronic/Altium/Курсовой проект по электронике/Электроника/AD_GOST/Examples/MiniPC MB GOST/Converter 3V3-0V9 V1.SchDoc
Electronic/Altium/Курсовой проект по электронике/Электроника/AD_GOST/Examples/MiniPC MB GOST/Converter 3V3-0V9 V2.SchDoc
Electronic/Altium/Курсовой проект по электронике/Электроника/AD_GOST/Examples/MiniPC MB GOST/Converter 3V3-1V8.SchDoc
Electronic/Altium/Курсовой проект по электронике/Электроника/AD_GOST/Examples/MiniPC MB GOST/Converter 3V3-1V.SchDoc
Electronic/Altium/Курсовой проект по электронике/Электроника/AD_GOST/Examples/MiniPC MB GOST/Converter 3V3-2V5.SchDoc
Electronic/Altium/Курсовой проект по электронике/Электроника/AD_GOST/Examples/MiniPC MB GOST/Converter 3V3-DDR4VCC.SchDoc
Electronic/Altium/Курсовой проект по электронике/Электроника/AD_GOST/Examples/MiniPC MB GOST/Converter 3V3-VADJ.SchDoc
Electronic/Altium/Курсовой проект по электронике/Электроника/AD_GOST/Examples/MiniPC MB GOST/Converter 12V-0V9.SchDoc
Electronic/Altium/Курсовой проект по электронике/Электроника/AD_GOST/Examples/MiniPC MB GOST/Converter 12V-3V3.SchDoc
Electronic/Altium/Курсовой проект по электронике/Электроника/AD_GOST/Examples/MiniPC MB GOST/Converter 12V-5V.SchDoc
Electronic/Altium/Курсовой проект по электронике/Электроника/AD_GOST/Examples/MiniPC MB GOST/Core Supply Filter.SchDoc
Electronic/Altium/Курсовой проект по электронике/Электроника/AD_GOST/Examples/MiniPC MB GOST/Display Port Interface.SchDoc
Electronic/Altium/Курсовой проект по электронике/Электроника/AD_GOST/Examples/MiniPC MB GOST/DisplayPort Connector.SchDoc
Electronic/Altium/Курсовой проект по электронике/Электроника/AD_GOST/Examples/MiniPC MB GOST/DRAM DDR4 bank 1 Connector.SchDoc
Electronic/Altium/Курсовой проект по электронике/Электроника/AD_GOST/Examples/MiniPC MB GOST/DRAM DDR4 Bank 2 Connector.SchDoc
Electronic/Altium/Курсовой проект по электронике/Электроника/AD_GOST/Examples/MiniPC MB GOST/DRAM DDR4.SchDoc
Electronic/Altium/Курсовой проект по электронике/Электроника/AD_GOST/Examples/MiniPC MB GOST/DRAM Group.SchDoc
Electronic/Altium/Курсовой проект по электронике/Электроника/AD_GOST/Examples/MiniPC MB GOST/Ethernet Connector.SchDoc
Electronic/Altium/Курсовой проект по электронике/Электроника/AD_GOST/Examples/MiniPC MB GOST/Ethernet HPS Connector.SchDoc
Electronic/Altium/Курсовой проект по электронике/Электроника/AD_GOST/Examples/MiniPC MB GOST/Ethernet HPS Interface.SchDoc
Electronic/Altium/Курсовой проект по электронике/Электроника/AD_GOST/Examples/MiniPC MB GOST/Ethernet Interface Group.SchDoc
Electronic/Altium/Курсовой проект по электронике/Электроника/AD_GOST/Examples/MiniPC MB GOST/Ethernet Interface.SchDoc
Electronic/Altium/Курсовой проект по электронике/Электроника/AD_GOST/Examples/MiniPC MB GOST/IO Supply Filter.SchDoc
Electronic/Altium/Курсовой проект по электронике/Электроника/AD_GOST/Examples/MiniPC MB GOST/JTAG Connector.SchDoc
Electronic/Altium/Курсовой проект по электронике/Электроника/AD_GOST/Examples/MiniPC MB GOST/MiniPC MB GOST.PrjPcb
Electronic/Altium/Курсовой проект по электронике/Электроника/AD_GOST/Examples/MiniPC MB GOST/MiniPC MB GOST.SchDoc
Electronic/Altium/Курсовой проект по электронике/Электроника/AD_GOST/Examples/MiniPC MB GOST/miniPCIE Connector.SchDoc
Electronic/Altium/Курсовой проект по электронике/Электроника/AD_GOST/Examples/MiniPC MB GOST/P_DP_REFCLK_SFP.SchDoc
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
