MSolovtsov/BachelorThesis_Manipulator/(commit log)

2025-02-25 Added conculations of gear geometry, force & kinematic
2025-02-26 Complited mechanic calculations. Remade shafts & added bearings. Rebuild 3D model to print.
2025-03-04 Added .stl files to print parts
    [Вал_зубчатого_колеса.stl, Короб_двигателя.stl, Крышка.stl, Опора_пальца.stl, Основание.stl, Ось_зк_стойки.stl, Палец.stl, Стойка.stl]
2025-03-14 Printed the details on 3D printer. Developed functional electronic circuit & selected Electric Companions
    [Червяк.stl]
2025-05-09 Redesigned Base rotation & second link roration dears for different 3D-printer
    [4_SecondLink.stp, 5_0_joint.stl, 5_2_support_minor.stl, 5_3_finger.stl, Вал_зубчатого_колеса.stl, Короб_двигателя.stl, Крышка.stl, Опора_пальца.stl]
2025-05-10 Redesigned all of gear models
2025-05-26 Reoganise Redesigned_parts/ dir. Build some models of gearboxes
2025-06-08 Develope carduino code. Rewrite electronic part .docx file. Add electronic draws
    [3546357.stp, AS5600-block.PcbLib, AS5600-block.SCHLIB, BaseDimmerBoard.SchDoc, Base_plate.PrjPCB, Base_plate.SchDoc, Clock group.SchDoc, Converter 12V-0V9.SchDoc]
